SN4NTR/ArduinoSecuritySystem/Final/Changes.txt

C1, C2 - 10 мкФ
C7, C9 - 10 мкФ в другом корпусе
R1, R2 - 10 кОм
