SN4NTR/ArduinoSecuritySystem/Final/Presentation.pptx

## Презентация дипломного проекта

«Система обеспечения безопасности котельной жилого дома на базе микроконтроллера»

Выполнил: Миронь А.В.
Руководитель: Шемаров А.И.

## Газовый котел

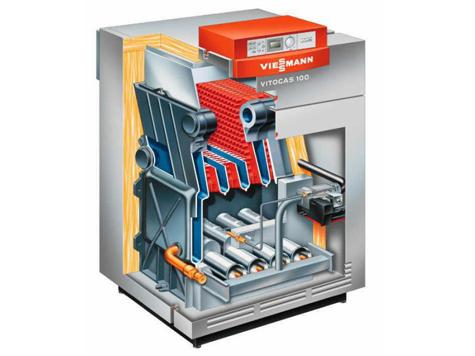
[picture p1: figure]
Принцип работы газового котла - понятно и подробно

- Низкая цена топлива;
- Высокий КПД;
- Занимает 40% доли рынка среди других котлов;
- Спрос на них будет постоянно увеличиваться.

## Функционал системы

- Определение превышения концентрации угарного (CO), углекислого (CO2) и природного газов;
- Обнаружение задымления;
- Обнаружение возгорания;
- Определение превышения температуры и влажности;
- SMS-оповещение по номеру телефона;
- Звуковая сигнализация;
- Световая индикация;
- Перекрытие подачи газа в газовый котел.

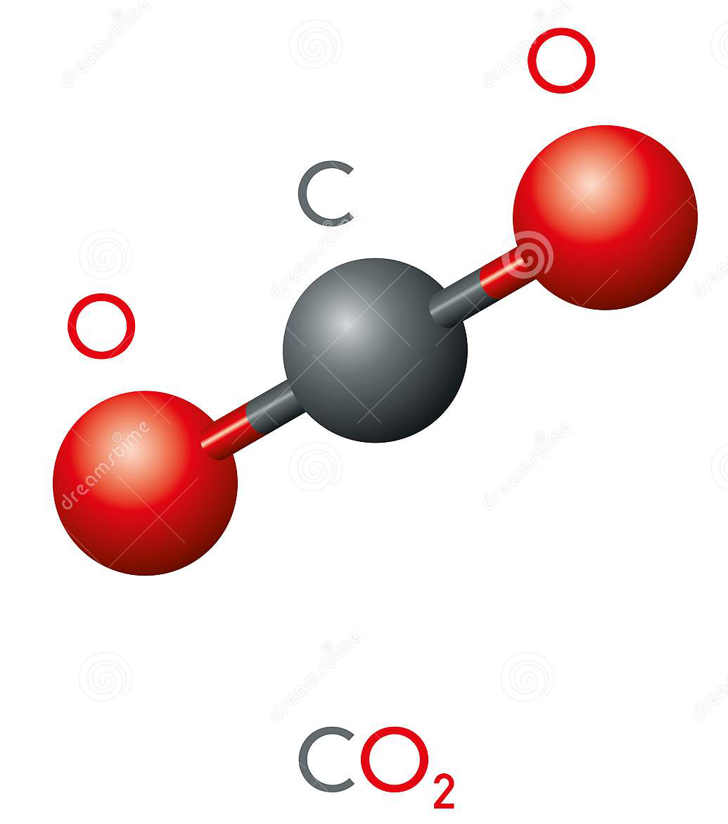
[picture p2: figure]
Углекислый газ, СО2, модель молекулы и химическая формула Иллюстрация вектора - иллюстрации насчитывающей изолировано, газ: 126784904
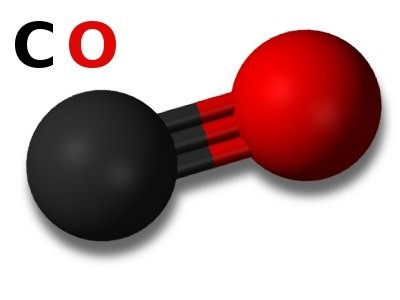
[picture p3: figure]
Влияние угарного газа на здоровье человека | АльфаЭко
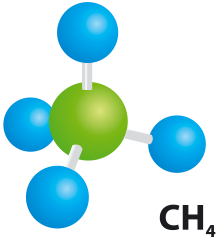
[picture p4: figure]
Природный газ – экологичное моторное топливо

## Аппаратное обеспечение

Микроконтроллер ATmega328P

- Тактовая частота 0 – 20 МГц;
- Напряжение питания 1,8 – 5,5 В;
- Общее количество портов 23;
- Объем Flash-памяти 32 кб;
- Объем RAM-памяти 2 кб;
- Объем EEPROM-памяти 1 кб;
- Количество аппаратных I2C/SPI 1;
- Диапазон рабочих температур -40 - 85℃.

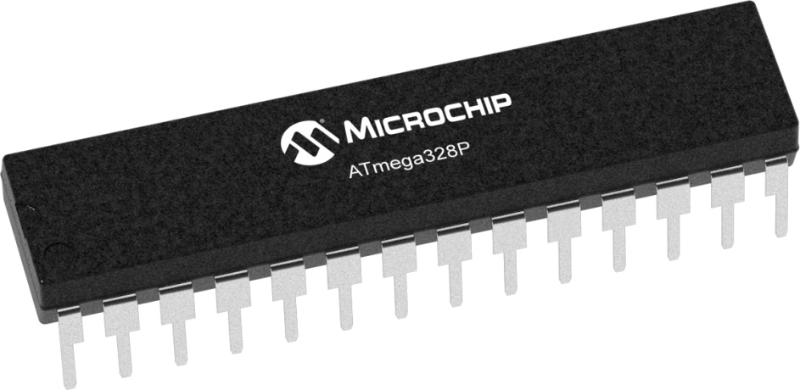
[picture p5: figure]
ATmega328P - 8-bit AVR Microcontrollers

## Аппаратное обеспечение

GSM/GPRS модуль SIM900A

- Два диапазона 900/1800 МГц;
- Напряжение питания 3,2 – 4,8 В;
- Встроенный стек TCP/IP, UDP/IP;
- Протоколы HTTP и FTP;
- Управление AT-командами;
- Диапазон рабочих температур -40 - 85℃.

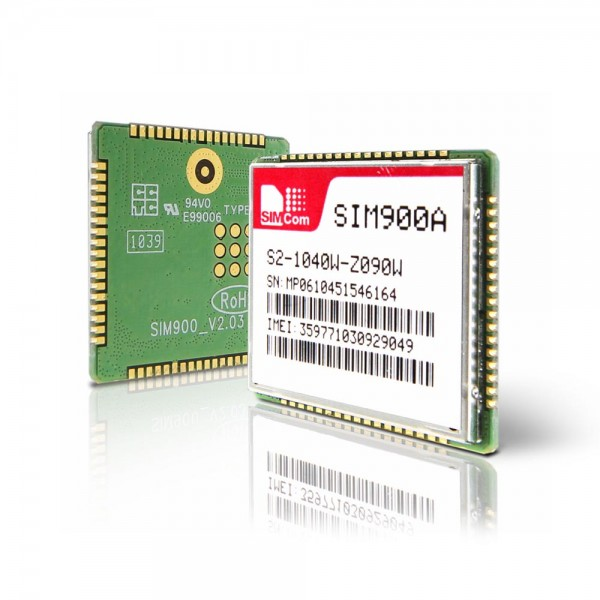
[picture p6: figure]
GSM GPRS модуль SIM900A (б/у)

## 3D-модель печатной платы

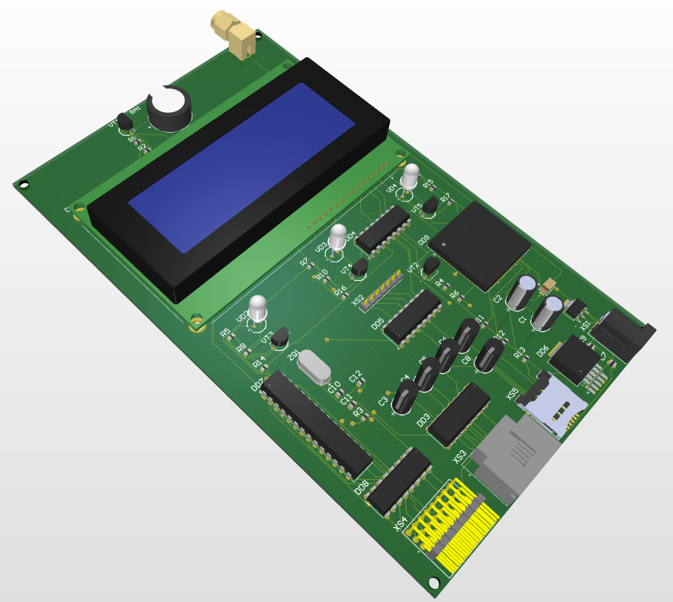
[picture p7: figure]

- 3-й класс точности;
- Паяльная паста Mechanic XG-50;
- Бессвинцовый припой ПОМ-3;
- Покрытие лаком PLASTIK 71.

Размеры платы: 110 х 180 х 1,5 мм

## 3D-модель корпуса устройства

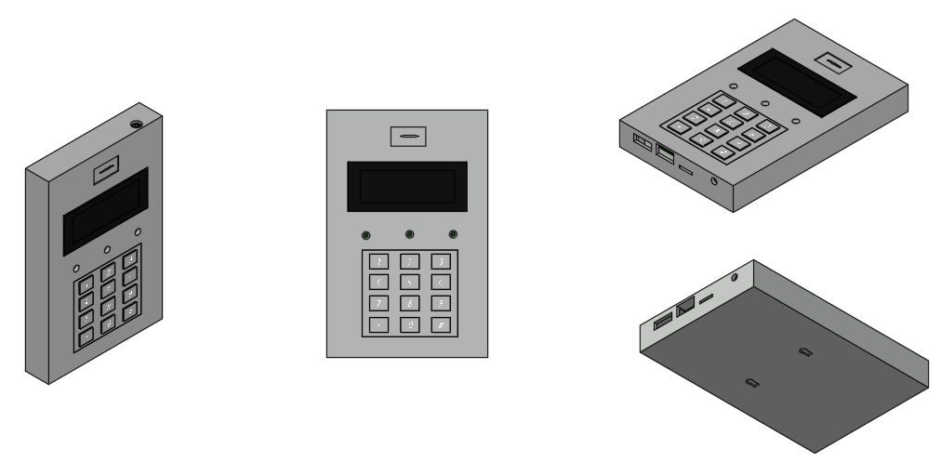
[picture p8: figure]

Размеры корпуса: 130 х 200 х 29 мм

ABS-пластик

## Slide 8

Программное обеспечение

## Моделирование работы системы

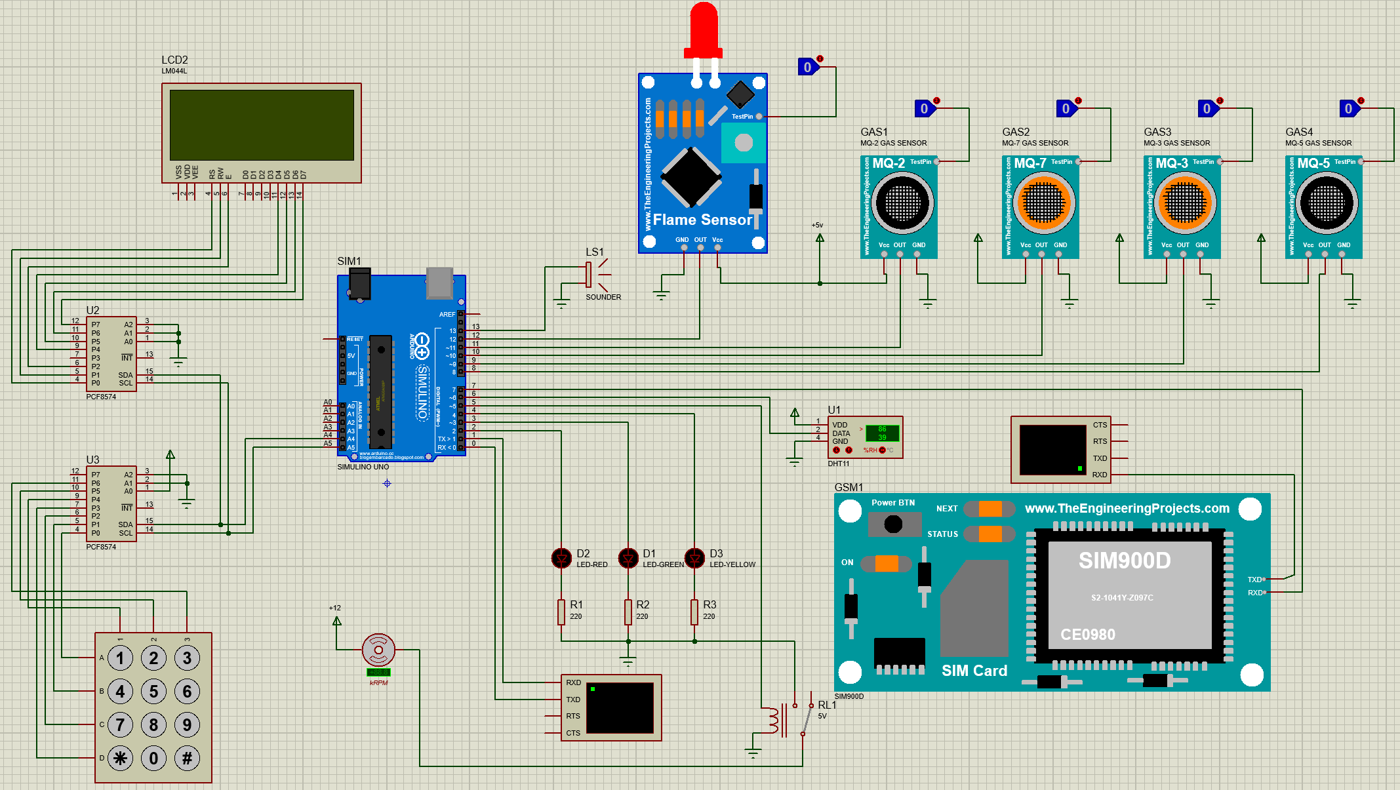
[picture p9: figure]

## Моделирование работы системы

Ввод номера телефона

Безопасная ситуация

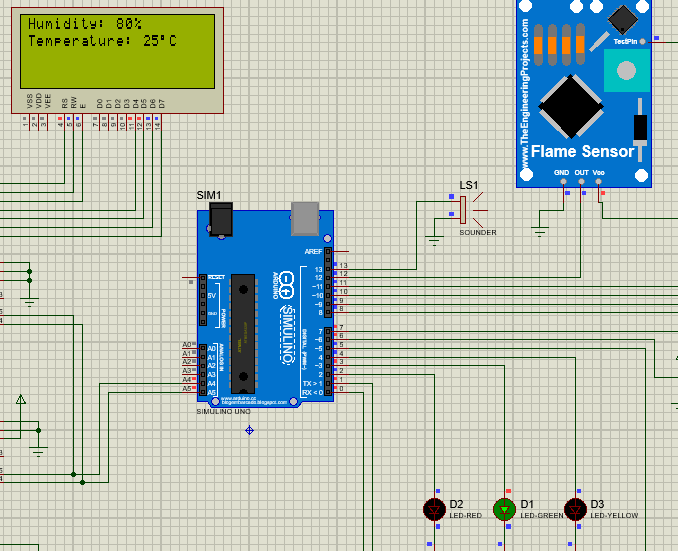
[picture p10: figure]
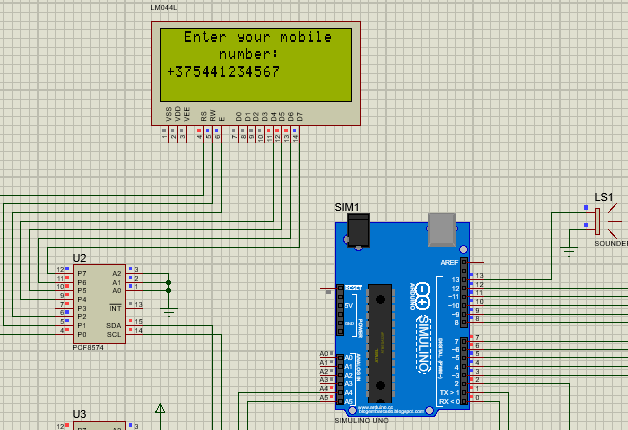
[picture p11: figure]

## Моделирование работы системы

Опасная ситуация

SMS-оповещение

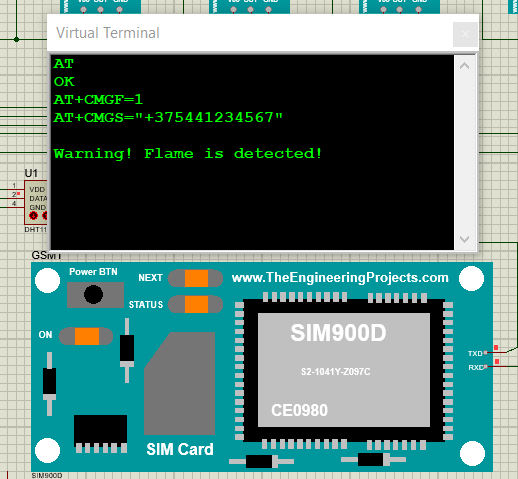
[picture p12: figure]
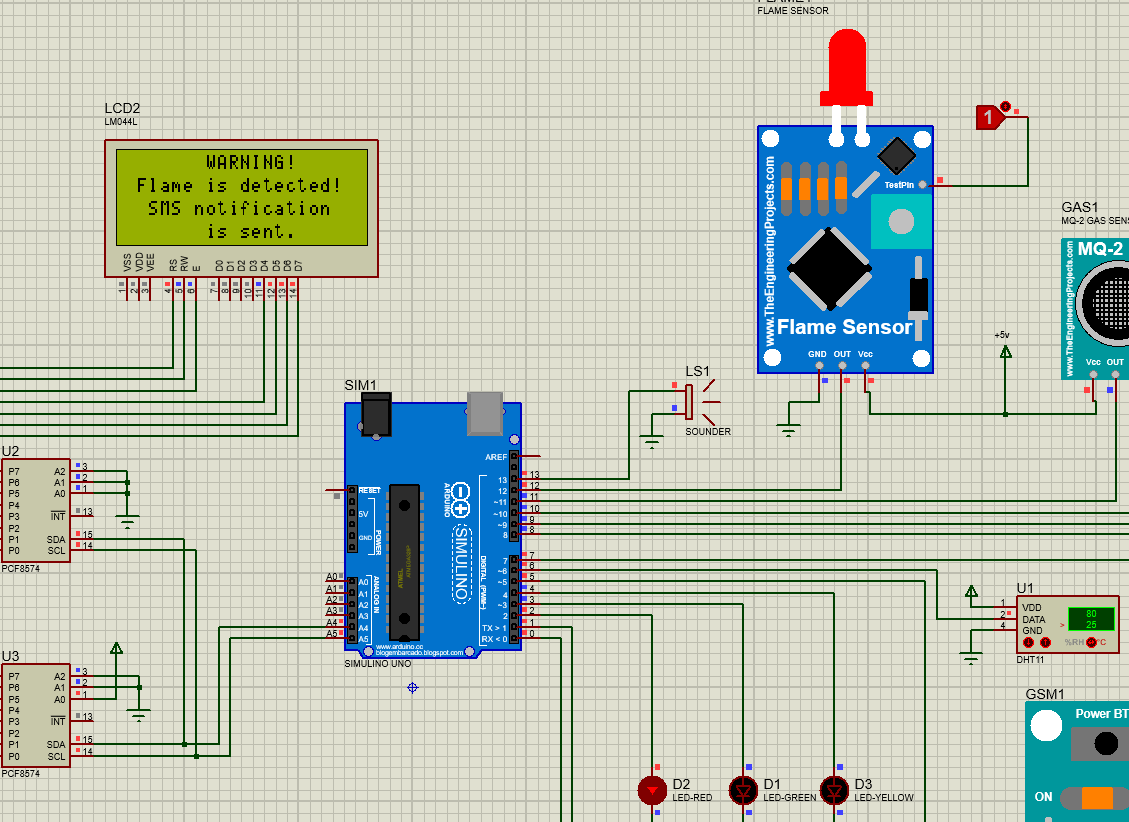
[picture p13: figure]

## Анализ экономической эффективности

Наименование статьи затрат | Значение, руб.
Покупные комплектующие | 261
Производственная себестоимость | 344
Полная себестоимость | 354
Отпускная цена | 443

## Спасибо за внимание!
