SN4NTR/ArduinoSecuritySystem/Final/For Review/Specs/Ведомость ДП Миронь.pdf

Перв. примен.

Зона
Обозначение | Наименование

Дополнительные
сведения

Текстовые документы

БГУИР ДП 1-40 02 02 01 011 ПЗ | Пояснительная записка | 91 с.
| Отзыв руководителя | 1 с.
| Рецензия | 1 с.

Справочный №

Графические документы

ГУИР.425158.001 ПЛ | Схема структурная | Формат А1
ГУИР.425158.001 Э3 | Схема электрическая принципиальная | Формат А1
ГУИР.425158.001 ПД | Схема алгоритма работы | Формат А1
ГУИР.758725.001 | Чертеж печатной платы | Формат А1

Подпись и дата

ГУИР.425158.001 СБ | Сборочный чертеж печатной платы | Формат А1
ГУИР.425159.001 СБ | Сборочный чертеж устройства | Формат А1

Инв. № дубл. Взам. Инв. № Подпись и дата

## БГУИР ДП 1-40 02 02 01 011 Д1

Изм. | Лист | № докум. | Подп. | Дата
Разраб. | Миронь | | | | Лит. | Лист | Листов
Инв. № подл.

Система обеспечения безопасности котельной жилого дома на базе микроконтроллера
Ведомость дипломного проекта
Пров. | Шемаров | Т | 92 | 92
Т.контр. | Шемаров
Н.контр. | Лихачёв
Утв. | Азаров

Кафедра ЭВС
гр. 750701
