SN4NTR/ArduinoSecuritySystem/Final/For Review/Specs/Спецификация на СБ печатной платы Миронь.pdf

Формат Зона Поз.
Обозначение | Наименование | кол.
Примеч.

Документация

A1 | ГУИР.425158.001 СБ | Сборочный чертеж печатной платы | 1
А1 | ГУИР.425158.001 Э3 | Схема электрическая | 1
| | принципиальная
А4 | ГУИР.425158.001 ПЭ3 | Перечень элементов | 1 | 2 с.

Детали

А1 | 1 | ГУИР.758725.001 | Плата печатная | 1

Прочие изделия

Диоды

2 | SMA4007 | 1 | VD1
3 | GNL-3012HD | 1 | VD2
4 | GNL-3012YD | 1 | VD3
5 | GNL-3012GD | 1 | VD4

Конденсаторы

6 | ECAP-10 мкФ, 100 В, ±20% | 2 | С1, C2
7 | ECAP-1 мкФ, 100 В, ±20% | 5 | С3..C6, C8
8 | TECAP-10 мкФ, 35 В, ±10% | 2 | C7, C9
9 | 0805-NPO-33 пФ, 50 В, ±5% | 2 | C10, C11
10 | 0805-X7R-1 мкФ, 16 В, ±10% | 1 | C12
| | ГУИР.425158.001
Изм | Лист | № докум | Подп. | Дата
Разраб. | Миронь | | | Система обеспечения безопасности котельной жилого дома на базе микроконтроллера | Лит | Лист | Листов
Пров. | Шемаров | | | | | Т | | 1 | 3
Т.контр. | Шемаров | | | | ЭВС, гр.750701
Н.контр. | Лихачёв
Утв. | Азаров

Микросхемы

11 | LCD-20X4B | 1 | DD1
12 | NCP1117ST50T3G | 1 | DD2
13 | MAX232 | 1 | DD3
14 | PCF8574 | 3 | DD4, DD5,
| | | DD8
15 | MIC29302WT | 1 | DD6
16 | ATmega328P | 1 | DD7
17 | SIM900A | 1 | DD9

Разъемы

18 | ADC-029 | 1 | XS1
19 | DS1023-1x7 | 1 | XS2
20 | RS-232 | 1 | XS3
21 | DS1013-24S | 1 | XS4
22 | SIM5051-6-0-18-00-A | 1 | XS5
23 | 901-9894-RFX | 1 | XS6

Резисторы

24 | Чип 0805-10 кОм ± 1% | 2 | R1, R2
25 | Чип 0805-1 МОм ± 1% | 1 | R3
26 | Чип 0805-4,7 кОм ± 1% | 4 | R4, R5, R7,
| | | R9
27 | Чип 0805-47 кОм ± 1% | 4 | R6, R8, R10,
| | | R15
28 | Чип 0805-22 Ом ± 1% | 3 | R11..R13
29 | Чип 0805-510 Ом ± 1% | 3 | R14, R16, R17
| ГУИР.425158.001 | Лист
2
Изм | Лист | № докум | Подп.

Резонаторы

30 | Резонатор кварцевый HC-49S | 1 | ZQ1

Устройства индикационные

31 | Динамик пьезоэлектрический CVS-1508 | 1 | BA1

Транзисторы

32 | КТ3102АМ | 5 | VT1..VT5

Материалы

33 | Краска МКЭ белая ОСТ92-1586-89 | 0,02
34 | Припой ПОМ-3 ГОСТ 21931-76 | 0,04
35 | Паяльная паста Mechanic XG-50 | 0,03
36 | Лак PLASTIK 71 | 0,03

# ГУИР.425158.001

Лист
3
Изм | Лист | № докум | Подп.
