SN4NTR/ArduinoSecuritySystem/Final/For Review/Specs/Спецификация на СБ устройства Миронь.pdf

Формат Зона Поз.
Обозначение | Наименование | кол.
Примеч.

Документация

A1 | ГУИР.425159.001 СБ | Сборочный чертеж устройства | 1

Стандартные изделия

1 | ГУИР.758725.001 | Плата | 1
2 | | Клавиатура Accord AK-304-N-BBW | 1
3 | | Винт М2.5х8 ГОСТ 17473-80 | 4
4 | | Винт М2.5х5 ГОСТ 17473-80 | 8
5 | | Винт М3х8 ГОСТ 17473-80 | 4

# ГУИР.425159.001

Изм | Лист | № докум | Подп. | Дата
Разраб. | Миронь | | | Система обеспечения безопасности котельной жилого дома на базе микроконтроллера | Лит | Лист | Листов
Пров. | Шемаров | | | | | Т | | 1
Т.контр. | Шемаров | | | | ЭВС, гр.750701
Н.контр. | Лихачёв
Утв. | Азаров
