SN4NTR/ArduinoSecuritySystem/Docs/Приказ по темам.pdf

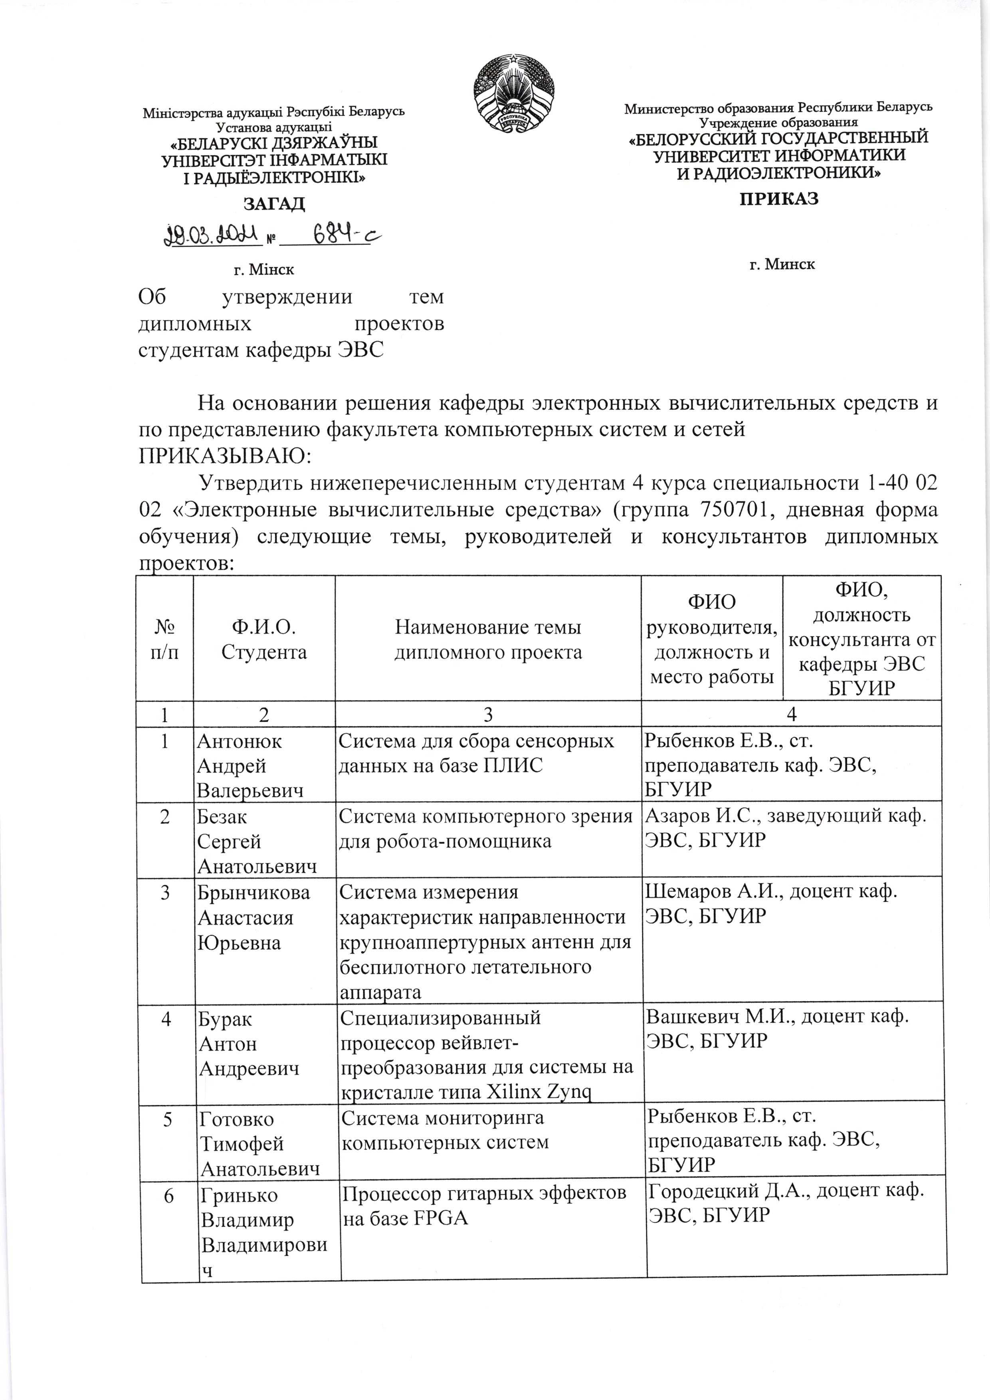
[picture p36: page 1]
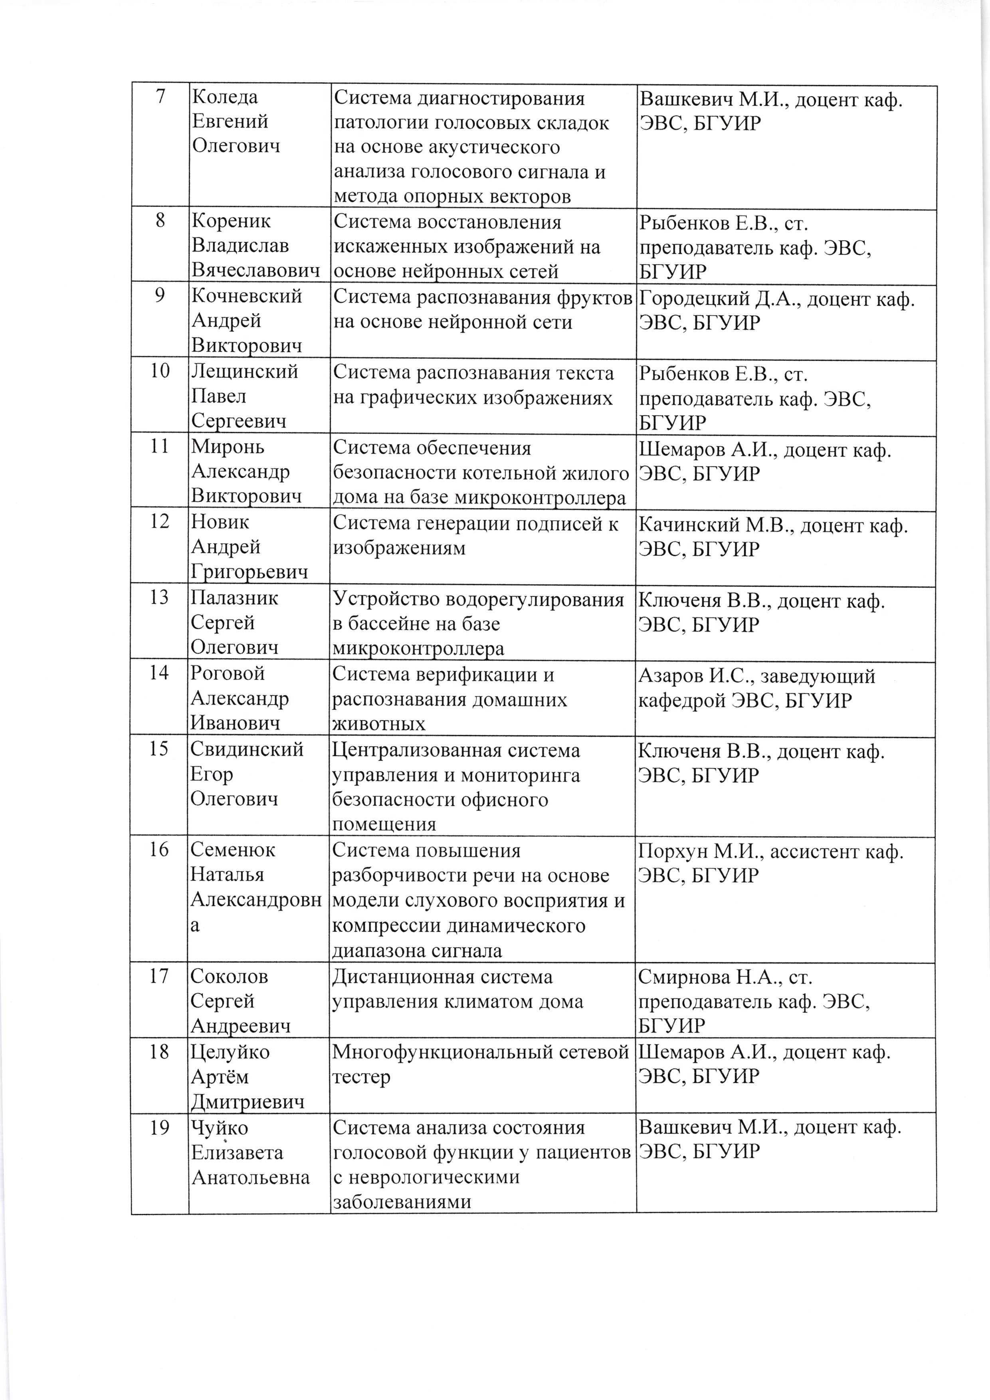
[picture p37: page 2]
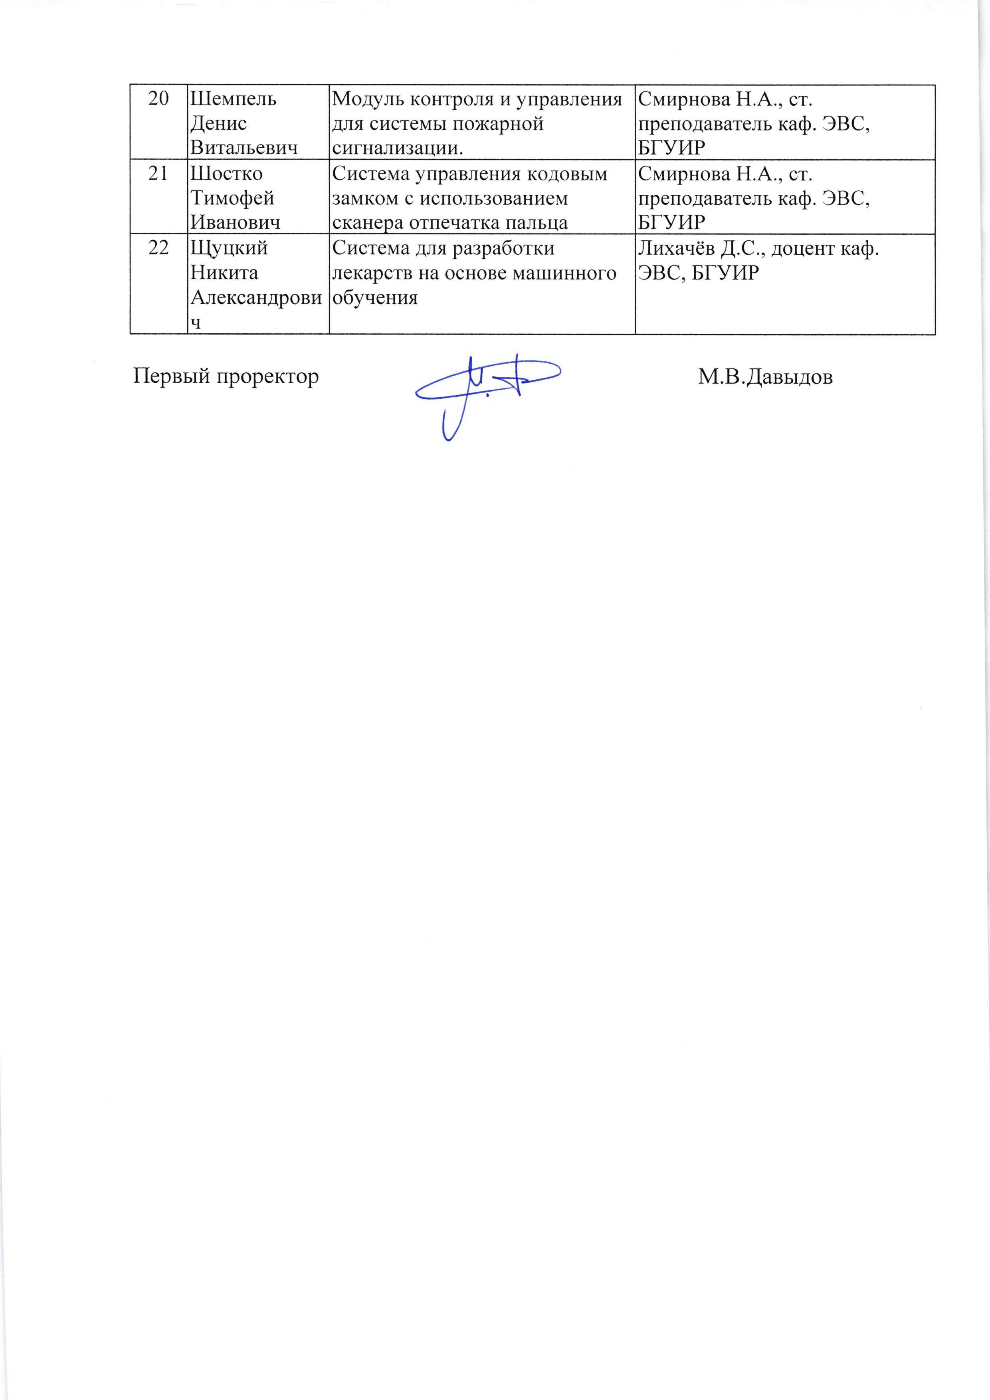
[picture p38: page 3]
