SN4NTR/ArduinoSecuritySystem/Final/For Review/Пояснительная записка Миронь.pdf

Министерство образования Республики Беларусь

Учреждение образования
БЕЛОРУССКИЙ ГОСУДАРСТВЕННЫЙ УНИВЕРСИТЕТ ИНФОРМАТИКИ И РАДИОЭЛЕКТРОНИКИ

Факультет компьютерных систем и сетей Кафедра электронных вычислительных средств

К защите допустить:
Заведующий кафедрой ЭВС
___________ И. С. Азаров

ПОЯСНИТЕЛЬНАЯ ЗАПИСКА
к дипломному проекту
на тему

СИСТЕМА ОБЕСПЕЧЕНИЯ БЕЗОПАСНОСТИ КОТЕЛЬНОЙ ЖИЛОГО ДОМА НА БАЗЕ МИКРОКОНТРОЛЛЕРА

БГУИР ДП 1-40 02 02 01 011 ПЗ

Студент | А. В. Миронь
Руководитель | А. И. Шемаров

Консультанты:
от кафедры ЭВС | А. И. Шемаров
по экономической части | Т. А. Рыковская
Нормоконтролер | Д. С. Лихачев

Рецензент

Минск 2021

РЕФЕРАТ

СИСТЕМА | ОБЕСПЕЧЕНИЯ | БЕЗОПАСНОСТИ | КОТЕЛЬНОЙ
ЖИЛОГО ДОМА НА БАЗЕ МИКРОКОНТРОЛЛЕРА : дипломный проект / А. В. Миронь. – Минск : БГУИР, 2021, – п.з. – 91 с., чертежей (плакатов) – 6 л. формата А1.

В рамках дипломного проекта разработана система обеспечения безопасности котельной жилого дома на базе микроконтроллера. Было разработано программное обеспечение для тестирования работы системы. Данная система обладает широким функционалом для отслеживания и анализа состояния воздуха в котельном помещении с возможностью определения превышения концентрации ядовитых газов и функцией SMS-оповещения о чрезвычайной ситуации по указанному при регистрации пользователем номеру, а также функцией перекрытия подачи газа в газовый котел.
Элементная база была выбрана исходя из функционального назначения и условий эксплуатаций разрабатываемой системы.
Область технического применения представляет собой жилые и нежилые помещения частного дома, дачи либо коттеджа, т. к. устройство сконструировано для эффективного применения в данных условиях.

Ил. – 24, табл. – 13, прилож. – 2, список лит. – 22 назв.;
Графическая часть – 6 л. формата А1.

Ключевые слова: система обеспечения безопасности котельной,
элементная база, | конструирование, | печатная плата, | газовый котел.

5

СОДЕРЖАНИЕ

5 Выбор | средств | обеспечения | теплового | режима, | герметизации,

6.8 Обеспечение требований эргономики и инженерной психологии ... 48

8 Рекомендации | по | обеспечению | электрической | и | экологической

9 Требования к хранению, маркировке, упаковке и транспортировке

6

7

ВВЕДЕНИЕ

Отопление частного дома, коттеджа, дачи или любого другого жилого помещения является важным фактором для комфортного пребывания в них. В настоящее время существует большое количество различных способов для обогрева помещений, для поддержания комфортной температуры внутри. Одним из таких примеров является газовый котел.
Данный вид котлов получил широкое распространение за счет ряда преимуществ:
– позволяет отапливать объекты и помещения больших размеров;
– коэффициент полезного действия достаточно высокий, а цена топлива – небольшая;
– количество энергии, которое отдает котел, намного больше, чем потребляемое;
– отсутствует необходимость следить за пламенем, потому что газ подается в установку непрерывно;
– прост в эксплуатации и рассчитан на долгий срок службы.
В то же время, газовый котел является источником повышенной опасности. Современные котлы оснащены различными датчиками, которые могут определить, работает ли горелка, не упало ли давление ниже допустимого значения, достаточна ли тяга и т. д. Но несмотря на это, важную роль играет то, какую систему безопасности имеет помещение, в котором газовый котел размещен. При несоблюдении правил эксплуатации газовый котел может стать источником утечки газа или возгорания. Для того, чтобы максимально быстро реагировать на такие ситуации, необходимо грамотно подойти к выбору системы безопасности котельного помещения.

8

### 1 ЛИТЕРАТУРНЫЙ ОБЗОР

Для того, чтобы обеспечить в жилом помещении необходимые условия
для | комфортного проживания, | нужна система, | которая могла | бы
поддерживать нужный температурный режим внутри. Система отопления является наиболее удачным инженерным решением данного вопроса. Эволюция отопительного оборудования проделала долгий путь: от простых каминов до смарт-котлов, интегрированных в отопительную систему и рационально расходующих энергию в зависимости от нужд потребителя. Существуют различные виды систем отопления, но самыми основными являются: водяная, электрическая, паровая, воздушная [1].
Среди | всей | классификации | систем | отопления | наибольшей
популярностью пользуется водяное отопление. Технические преимущества такого отопления были выявлены в результате многих лет практики:
– небольшая температура поверхности различных приборов и труб;
– обеспечивает одинаковую температуру во всех помещениях;
– экономит топливо;
– повышенные эксплуатационные сроки;
– бесшумная работа;
– простота в обслуживании и ремонте.
Главным компонентом системы водяного отопления является котел. Такое устройство необходимо для того, чтобы нагревать воду. Вода является в таком виде отопления теплоносителем. Она циркулирует по трубам замкнутого типа, а потом тепло передается в различные отопительные компоненты, а от них уже обогревается все помещение.

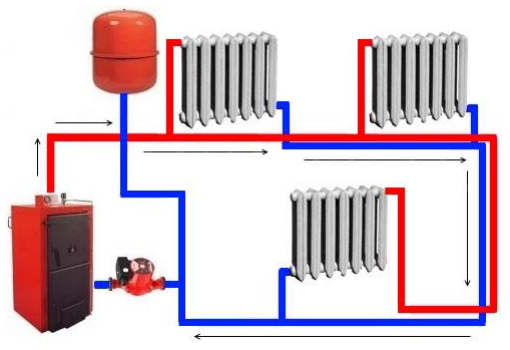
[picture p39: figure]

Рисунок 1.1 – Схема водяной системы отопления

9

Электрическая система отопления становится популярной за счет того, что не требует больших затрат для установки или ремонта. Электрический конвектор можно поставить в нужное место и подключить его к питанию сети. Уровень комфорта и экономичность такой обогревательной системы достигается благодаря тому, что в электрических конвекторах применяется электронная система, которая помогает поддерживать определенную температуру.

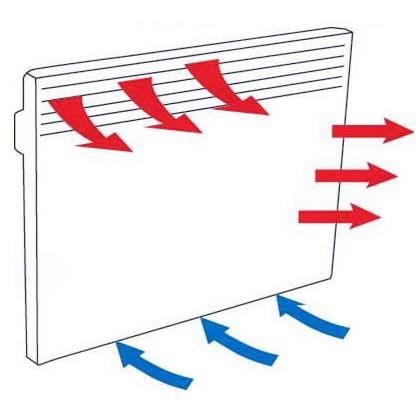
[picture p40: figure]

Рисунок 1.2 – Схема электрической системы отопления

Воздушное отопление считается одним из самых старых видов отопления. Такая отопительная система получила широкое распространение в общественных и производственных помещениях. Нагретый воздух попадает в помещение, где происходит процесс смешивания с внутренним воздухом и охлаждается до температуры помещения и снова нагревается.


Рисунок 1.3 – Схема воздушного отопления

10

Одним из видов воздушного отопления является отопление при помощи газовых котлов. Низкая цена топлива обеспечила ему популярность. Но установка такого котла требует соблюдения ряда условий из-за взрывоопасности газа. Современные газовые котлы имеют различные датчики, отвечающие за безопасность оборудования:
– тяги;
– температуры (уличный и комнатный);
– пламени;
– датчик давления;
– перегрева.

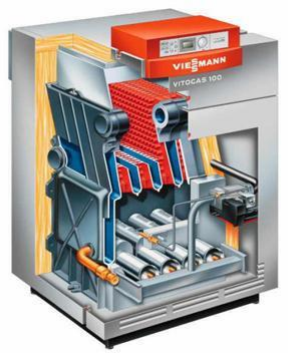
[picture p41: figure]

Рисунок 1.4 – Газовый котел

Но несмотря на безопасность современного котельного оборудования, важную роль играет система безопасности помещения, в которой котел размещен. Данная система безопасности должна уметь распознавать наличие опасных газов в помещении (таких как угарный (CO) и углекислый (CO2) газ), задымленность, возгорание, а также отслеживать температуру и влажность помещения и реагировать соответствующим образом на данные показатели [2].

11

### 2 АНАЛИЗ ТЕХНИЧЕСКОГО ЗАДАНИЯ

### 2.1 Описание схемы электрической принципиальной

Работа системы обеспечения безопасности котельной жилого дома основывается на принципе считывания показаний датчиков и, исходя из данных показаний, принятия решений на основе программы управления, которая зашита в микроконтроллере ATmega328P (DD7). Для обеспечения работы микроконтроллера на частоте 16 МГц необходимо подключить
внешний | кварцевый | резонатор | ко | входам | XTAL1 | и | XTAL2
микроконтроллера, второй конец параллельных резонатору цепей заземлить, но перед подключением земли расположить по емкости малого номинала, т. к. встроенный кварцевый резонатор способен выдать частоту до 8 МГц [3]. Для данной цели выбран многослойный керамический конденсатор номиналом 33 пФ с максимальным отклонением от номинала в 5% и напряжением 50 В.
Главной | микросхемой, | отвечающей | за | управление | системой
обеспечения | безопасности | котельной | жилого | дома, | является
микроконтроллер ATmega328P (DD7). Для подключения к управляющей схеме различных элементов управления, датчиков, а также индикаторов системы будут использованы расширители портов ввода/вывода. Элементы управления необходимы для первоначальной настройки устройства. При первом включении пользователю будет предложено ввести при помощи клавиатуры номер телефона для возможности SMS-оповещений. Датчики
выполняют | роль | считывателей | состояния | котельного | помещения.
Индикаторы необходимы для визуального и звукового оповещения пользователя об опасной ситуации. Для реализации возможности SMS-оповещения пользователя к микроконтроллеру ATmega328P подключается микросхема SIM900A (DD9). Разъем типа RS-232 (XS3) необходим для прошивки и отладки системы.
Для отображения состояния котельного помещения к системе подключается LCD-дисплей LCD-20X4B размером 20 символов на 4 строки. К управляющей микросхеме DD7 дисплей подключается через расширитель портов ввода/вывода PCF8574 (DD4). Для установки адреса устройства необходимо заземлить выводы A0-A2. Получится адрес «000».
Для обеспечения возможности ввода номера телефона при настройке устройства пользователем используется клавиатура Accord AK-304-N-BBW. Данная клавиатура имеет кнопки от 0 до 9 и знаками «*» и «#». Клавиатура

12

подключается через 7-контактный разъем (XS2). На выводы расширителя портов P0-P6 подаются сигналы с клавиатуры через разъем XS2, который пронумерован для правильного подключения клавиатуры. Разъем XS2 подключается к микроконтроллеру при помощи расширителя портов ввода/вывода PCF8574 (DD5). Необходимо заземлить адресные выводы A1-A2 и подать питание на вывод A0, чтобы получить адрес «001».
Система обеспечения безопасности котельной жилого дома имеет разъемы для подключения до 8 проводных датчиков (XS4): различных газов, температуры и влажности, а также реле для отключения подачи газа. Данный разъем подключается к микроконтроллеру при помощи расширителя портов ввода/вывода по шине I

2C – PCF8574 (DD8). Выводы разъема OUT1-OUT8 подключаются к выводам P0-P7 расширителя DD8. Так как DD8 подключен к I

2C шине, необходимо задать уникальный адрес данного устройства. Для этого A0 и A2 заземляются (их логические уровни равны нулю), а на вывод A1 подается питание +5В (логический уровень равен единице). В данном случае уникальный адрес будет «010». Для питания DD8 используется питающее напряжение цепи +5В.
К микросхеме DD7 подключается пьезодинамик (ВA1) HPA17F при помощи усилителя для звукового оповещения пользователя о чрезвычайной ситуации.
Взаимодействие с системой происходит через коммуникационный последовательный интерфейс RS-232 (XS3), который имеет большое число
преобразователей | в | USB, | Ethernet, | силовые | разъемы | и | другие.
Коммуникационный разъем ХS3 содержит выводы интерфейса SPI, который может быть использован для ISP-программирования. Последовательный
коммуникационный | интерфейс | подключен | через | микросхему
преобразователя | уровней | MAX232 | (DD3). | К | DD3 | подключаются
поляризованные конденсаторы емкостью 1 мкФ к выводам C1+, C1-, C2+, C2-, V-. Для питания DD3 используется напряжение +5В.
Для обеспечения возможности SMS-оповещения пользователя о чрезвычайных ситуациях используется микросхема SIM900A (DD9). Эта микросхема является двухдиапазонным модулем GSM/GPRS работающим на частотах EGSM 900 МГц и DCS 1800 МГц. Для того, чтобы аутентифицировать систему в сети, к выводам SIM_VDD, SIM_DATA, SIM_CLK микросхемы DD9 необходимо подключить SIM-карту через разъем SIM5051 (XS5) с использованием резисторов на 22 Ом. Вывод PWRKEY GSM-модуля подключается к выводу PD5 микроконтроллера ATmega328P для подачи микроконтроллером сигнала включения. Передача сигналов

13

GSM-модулем осуществляется через антенну, которая подключается к разъему 901-9894-RFX (XS6). Цепь, идущая от коллектора транзистора VT1 к выводу PD5 микроконтроллера добавлена для дополнительной страховки и нужна для того, чтобы следить, включен ли модуль SMS-оповещения. Если микроконтроллер DD7 обнаружит, что на этой линии высокий уровень напряжения, выполнится функция повторного запуска GSM-модуля. Вывод NETLIGHT GSM-модуля используется для отображения состояния сети. Рабочие состояния вывода представлены в таблице 2.1.

Таблица 2.1 - Рабочие состояния вывода NETLIGHT [4]

Состояние | Функция SIM900A
Выключен | Микросхема не в рабочем состоянии
64 мс включено / 800 мс выключено | Микросхема не нашла сеть
64 мс включено / 3000 мс выключено | Микросхема нашла сеть
64 мс включено / 300 мс выключено | Связь по GPRS

### 2.2 Описание схемы питания

Разъем ADC-029 (XS1) является входным портом. На него подается внешнее питание от блока питания 12 В. При помощи стабилизатора напряжения NCP1117ST50T3G (DD2) напряжение 12 В преобразуется в 5 В. А при помощи MIC29302WT (DD6) – в 3,3 В. Напряжение питания 3,3 В используется для питания GSM-модуля, 5 В используется для питания
микроконтроллера | ATmega328P, | преобразователя | уровня | MAX232,
расширителей портов PCF8574 и для подачи питания на разъемы для подключения внешних устройств. Для обеспечения работы динамика BA1 используется напряжение 12 В.
Структурная схема системы обеспечения безопасности котельной жилого дома представлена на плакате ГУИР.425158.001 ПЛ. Схема электрическая принципиальная представлена на чертеже ГУИР.425158.001 Э3.

### 2.3 Анализ условий эксплуатации

Система | обеспечения | безопасности | котельной | жилого | дома
эксплуатируется в диапазоне температур от -20 до +60°С и относительной

14

влажности не более 90%, а основным назначением системы является эксплуатация в районе с умеренным климатом.
Cистема будет находиться в умеренном климате в помещении, и температура помещения не будет ниже -20°С, при отсутствии отопления. Исходя из этих условий, была выбрана следующая категория размещения:
для | эксплуатации | в | помещениях | с | искусственно | регулируемыми
климатическими условиями, например, в закрытых отапливаемых или охлаждаемых и вентилируемых производственных и других, в том числе хорошо вентилируемых подземных помещениях (отсутствие воздействия прямого солнечного излучения, атмосферных осадков, ветра, песка и пыли наружного воздуха; отсутствие или существенное уменьшение воздействия рассеянного солнечного излучения и конденсации влаги) «помещение категории 4» [5].
Сочетание исполнения, категории и группы для системы обеспечения безопасности котельной жилого дома будет использоваться следующее: вид климатического исполнения УХЛ 4.2 по ГОСТ 15150-69.

Таблица 2.2 – Характеристики вида климатического исполнения УХЛ 4.2 [5]

Значение температуры воздуха при эксплуатации, °С | Относительная влажность, %
Рабочее | Предельное рабочее | Среднегодовое значение | Верхнее значение
верхнее | нижнее | верхнее | нижнее | при 20°С | при 25 °С
+35 | +10 | +40 | 0 | 60 | 80

15

### 3 ВЫБОР ЭЛЕМЕНТНОЙ БАЗЫ И МАТЕРИАЛОВ

КОНСТРУКЦИИ

Выбор элементной базы очень важен для обеспечения стабильности, надежности и экономичности устройства, потому что выбор элементов, применяющихся в современных электронных средствах, обеспечивает ремонтоспособность элементов. Не менее важной задачей является достижение простоты сборки, а также электрического монтажа, испытаний и регулировки.
Характеристики изделий электронной техники приведены в таблице 3.1.

Таблица 3.1 – Элементы, входящие в систему, и их характеристики

Позиционное обозначение | Тип | Примечание | Корпус
1 | 2 | 3 | 4
ВA1 | CVS-1508 | Uпит не более 5 В; Диапазон температуры (-0С 20…+55)
C1, C2 | JRB | Конденсатор электролитический поляризованный сквозного монтажа; C = 10 мкФ; Uраб = 100 В; Диапазон температур (-40…+105)⁰С
C3-C6, C8 | JRB | Конденсатор электролитический поляризованный сквозного монтажа; C = 1 мкФ; Uраб = 100 В; Диапазон температур (-40…+105)⁰С
С7, С9 | GRM | Конденсатор танталовый поверхностного монтажа; C = 10 мкФ; Uраб = 35 В; Диапазон температур (-55…+125)⁰С

16

Продолжение таблицы 3.1

1 | 2 | 3 | 4
С10, С11 | GRM | Конденсатор многослойный керамический поверхностного монтажа; C = 33 пФ; Uраб = 50 В; Диапазон температур (-55…+125)⁰С | SMD 0805
C12 | GRM | Конденсатор многослойный керамический поверхностного монтажа; C = 1 мкФ; Uраб = 16 В; Диапазон температур (-55…+125)⁰С | SMD 0805
DD1 | LCD-20X4B | Uпит не более 5 В; Диапазон температур (-30…+80) 0С
DD2 | NCP1117 ST50T3G | Uпит не более 20 В; Диапазон температур (-40…+125)⁰С | SOT-223
DD3 | MAX232 | Uпит не более 5,5 В; Диапазон температур (-40…+85)⁰С | DIP-16
DD4, DD5, DD8 | PCF8574 | Uпит не более 7 В; Диапазон температур (-40…+85)⁰С | PDIP-16
DD6 | MIC29302WT | Uпит не более 26 В; Диапазон температур (-40…+125)⁰С | TO-263-5
DD7 | ATmega328P | Uпит не более 5,5 В; Диапазон температур (-40…+85)⁰С | DIP-28
DD9 | SIM900A | Uпит не более 4,5 В; Диапазон температур (-40…+85)⁰С | SMD-8pin
R1-R17 | RC | Бескорпусные толстопленочные резисторы; R = 22 Ом, 510 Ом, 4,7 кОм, 10 кОм, 47 кОм, 1 МОм; Pном. = 0,125 Вт; Uраб = 200 В; Диапазон температур (-55…+125)⁰С | SMD 0805

17

Продолжение таблицы 3.1

1 | 2 | 3 | 4
VD1 | M7 | Диод универсальный | SMA
VD2 | GNL-3012HD | Светодиод красный
VD3 | GNL-3012YD | Светодиод желтый
VD4 | GNL-3012GD | Светодиод зеленый
VT1-VT5 | КТ3102АМ | Транзистор npn типа Макс. напр. к-б при заданном обратном токе к и разомкнутой цепи э.(Uкбо макс) = 50 В Макс. напр. к-э при заданном токе к и разомкнутой цепи б.(Uкэо макс) = = 45 В Iк макс = 0.1 A P = 0.5 В Диапазон температур (-55…+150)⁰С | TO-92
XS1 | ADC-029 | Разъем питания для системы Диапазон температуры (-25…+85)⁰С | DIP
XS2 | DS1023-1x7 | Разъем для подключения клавиатуры, 7 контактов Диапазон температуры (-40…+105)⁰С | DIP
XS3 | RS-232 | Разъем RS-232 Диапазон температуры (-40…+105)⁰С | BH-10
XS4 | DS1013-24S | Разъем для подключения датчиков, 24 контакта Диапазон температуры (-55…+140)⁰С | DIP
XS5 | SIM5051-6-0-18-00-A | Разъем для SIM-карты Диапазон температуры (-40…+85)⁰С | SMD

18

Продолжение таблицы 3.1

1 | 2 | 3 | 4
XS6 | 901-9894-RFX | Разъем для подключения антенны к GSM-модулю Диапазон температуры (-40…+90)⁰С | SMD
ZQ1 | РПК01 | Кварцевый резонатор Диапазон температуры (-20…+70)⁰С | HC-49S

Есть несколько принципов выбора элементной базы:
– объема производства;
– исходя из их назначения в схеме;
– с учетом требований, предъявляемых к компоновке платы как в целом, так и отдельных ее элементов;
– | экономической | целесообразности | применяемого | способа
изготовления изделия.
Стеклостелиты имеют структуру слоеного пластика, волокна которого чередуются с полимерным связующим веществом. Обычно это бакелита, эпоксидная смола или полиэфирная смола. Стеклоткань является основой
стеклотекстолита. | Кроме | хороших | электрических | и | механических
электрических свойств, она обладает высокими гидрофобными свойствами, химической инертностью, а ее рабочая температура от -65°С до +155°С, что придает высокую стойкость к перегревам.
Основным недостатком | является предельный | запас прочности
стеклотекстолила, поэтому это требует соблюдения определенных условий хранения. Возможно выделение токсичной пыли от смол и при нагреве до высоких температур токсичных паров, которые способны раздражать человеческую слизистую. Еще одним недостатком является достаточно высокая стоимость.
На плате используются неметаллические покрытия с целью защиты:
– | элементов | проводящего | рисунка | от | замыкания | навесными
радиоэлементами;
– печатных проводников и поверхности основания печатной платы от воздействия припоя.
Диэлектрические защитные покрытия на основе эпоксидных смол, холодных эмалей, сухого пленочного резиста, оксидных пленок используют

19

от воздействия припоя для защиты печатных проводников и поверхности основания печатной платы. Варианты конструктивных покрытий печатных плат представлены в таблице 3.2.

Таблица 3.2 – Конструктивные покрытия печатных плат [6]

Вид покрытия | Толщина, мкм | Назначение покрытия
Серебряное | 6 – 12 | Улучшение электрической проводимости
Сплав серебро-сурьма | 6 – 12 | Улучшение электрической проводимости и повышение износоустойчивости переключателей и концевых контактов
Золотое и его сплавы | 0,5 – 3,0 | Улучшение электрической проводимости, снижение переходного сопротивления и повышение износоустойчивости
Палладиевое | 1 – 5 | Снижение переходного сопротивления и повышение износоустойчивости контактов переключателей и концевых контактов
Никелевое | 3 – 6 | Защита от коррозии, повышение износоустойчивости контактов переключателей и концевых контактов
Медное | 25 – 30 | Обеспечение электрических параметров, соединение проводящих слоев

В качестве конструктивного покрытия печатной платы выбран сплав серебро-сурьма. Покрытие печатных проводников, контактных площадок и металлизированных отверстий сплавом Sn97Cu3.
Достаточно важным фактором надежности электронных средств является выбор припоя для электрического монтажа. Для пайки выводных электрорадиоэлементов выбран припой ПОМ-3. Для пайки SMD элементов выбрана паяльная паста Mechanic XG-50.
Позиционные | обозначения | элементов | необходимо | маркировать
краской маркировочной МКЭЧ по ГОСТ 14763-89.
После установки элементов будет произведено покрытие лаком Plastik 71.
Перед | пайкой | электрорадиоэлементов | необходимо | подготовить
посадочные места. Для этого необходимо их очистить от окислов при помощи флюса.

20

Флюс – вещество органического и неорганического происхождения, предназначенные для удаления оксидов с паяемых поверхностей, снижения поверхностного натяжения, улучшения растекания жидкого припоя и/или защиты от действия окружающей среды.
Принцип действия паяльных флюсов заключается в том, что при нагреве металла, который нужен для облегчения соединения деталей и печатной платы, появляется оксидная пленка, которая снижает способность припоя соединяться с металлическими деталями. Именно для решения этой проблемы используется флюс для пайки. Флюсы могут добавляться в припой или наносятся непосредственно на металлические поверхности для предотвращения нежелательного окисления.
Таким образом выполняется сразу три задачи:
– улучшение смачивания поверхностей, подлежащих пайке;
– роль кислородного барьера для предотвращения дальнейшего окисления;
– растворение оксидной пленки, образовавшейся на поверхности обрабатываемого металла.
Главное требование к флюсам – это способность выдерживать высокие температуры, сохраняя при этом все полезные эксплуатационные свойства. Поэтому для химической очистки соединяемых поверхностей был выбран флюс Kester 959T.

21

### 4 ВЫБОР КОМПОНОВОЧНОЙ СХЕМЫ И МЕТОДА

КОНСТРУИРОВАНИЯ

Компоновочная схема изделия определяется габаритами и количеством элементной базы, способом защиты от электростатических и магнитных
полей, | объемом | монтажных | соединений, | ремонтопригодностью | и
механическими воздействиями.
Можно выделить 2 типа компоновочной схемы: централизованная и децентрализованная [7].
Централизованная схема компоновки имеет следующие особенности: – длина и количество межблочных соединений сведены к минимуму; – все элементы сложной системы располагаются в одном отсеке на специальных этажерочных конструкциях;
– ремонт и демонтаж наиболее удобны, легче выполнить качественные системы охлаждения и амортизации.
Централизованная схема компоновки имеет следующие особенности: – не требуется тщательная экранировка отдельных блоков;
– | обеспечивается | относительно | большая | легкость | размещения
элементов изделия на объекте;
– при соответствующих схемных решениях может быть более надежной, сохраняя частичную работоспособность при выходе из строя отдельных элементов изделия.
При децентрализованной компоновке можно выделить следующие недостатки: затруднен полный демонтаж системы, значительная длина межблочных соединений, для каждого отдельного блока необходимо предусматривать автономные системы охлаждения, виброзащиты.
Проанализировав | все | особенности, | было | принято | решение
использовать централизованную компоновочную схему, так как все элементы будут находиться на одной плате и в одном корпусе.
В процессе компоновки элементов на печатную плату необходимо учитывать элементы, которые будут размещаться на передней панели. Для определения формы устройства необходимо заранее выбрать их место размещение.
На последующих стадиях проектирования происходит корректировка и уточнение компоновочных параметров. При компоновке необходимо определить площадь, объем и массу конструкции. В том случае, если результаты расчетов не будут соответствовать требованиям ТЗ, то по

22

согласованию с заказчиком в технически обоснованных случаях в ТЗ могут быть внесены необходимые корректировки.
При компоновке системы обеспечения безопасности котельной жилого дома должны быть учтены следующие основные требования:
– требования по жесткости и прочности;
– эргономика, удобство ремонта;
– наличие достаточного пространства для межблочных соединений;
– сосредоточение центра тяжести ближе у опорной поверхности;
– оптимально размещение комплектующих элементов в модулях всех уровней с учетом коэффициента заполнения по объему и удобству для осмотра и ремонта;
– оптимальность, устойчивость и стабильность функциональных межблочных связей.
Необходимо учитывать влияние паразитных электромагнитных связей при проектировании платы. Учет и анализ этих связей на ранней стадии проектирования позволит снизить затраты на производство всего изделия, а также сократить сроки проектирования и добиться более устойчивой работы. Способом решения этой проблемы является исключение с самого начала конструирования схемы причин, порождающих помехи. При этом необходимо: понять, какие виды помех наиболее вероятны в данной схеме и выбрать и разместить печатные платы, кабели и другие структурные составляющие системы таким образом, чтобы исключить как можно больше причин, вызывающих помехи, и обеспечить при этом возможность подключения подавляющих помехи компонентов.
Помехи бывают двух типов: постоянные и перецеживающиеся. Постоянные помехи имеют один и тот же характер, что облегчает выявление их причины. Перецеживающие помехи появляются время от времени. Такой характер помех сильно затрудняет выявление их источника.
Проблемы возникновения помех и наводок можно свести к минимуму, изолируя чувствительные части схемы от источника помех, устраняя паразитные индуктивные и емкостные связи. Для этого необходимо:
– размещать мощные схемы вблизи нагрузок;
– стараться свести к минимуму длину проводников.
– располагать маломощные схемы поблизости от источника сигнала; – располагать маломощные и мощные схемы как можно дальше друг от друга и использовать максимально короткие контуры прохождения тока.

23

### 5 ВЫБОР СРЕДСТВ ОБЕСПЕЧЕНИЯ ТЕПЛОВОГО

РЕЖИМА, ГЕРМЕТИЗАЦИИ, ВИБРОЗАЩИТЫ И ЭЛЕКТРОМАГНИТНОЙ СОВМЕСТИМОСТИ

Изделия электронной техники связаны с использованием достаточно больших мощностей в сравнительно малых объемах. Это приводит к увеличению выделяющегося при работе тепла. При конструировании техники большое значение имеет разработка методов отвода теплоты, регулирования и контроля температуры.
Выбранный способ охлаждения должен обеспечить заданный по ТЗ тепловой режим техники, который можно проверить расчетным путем конструкции либо опытным путем после испытания макета или опытного образца. Если на ранней стадии конструирования неправильно выбран способ охлаждения, это обнаружится только на более поздних стадиях конструирования, в результате чего сроки создания электронной техники существенно увеличатся.
Выделяемое изделиями тепло может быть отведено от поверхности прибора и передано за пределы аппаратуры несколькими методами, применяемыми отдельно или в сочетании друг с другом. В зависимости от характера и назначения электронных средств применяют следующие методы отвода тепла от индивидуальных изделий электронной техники или групп изделий [8]:
– принудительное воздушное охлаждение;
– естественное охлаждение (воздушное);
– термоэлектрическое охлаждение;
– охлаждение, основанное на изменении агрегатного состояния вещества;
– принудительное жидкостное (без кипения или с поверхностным кипением).
Эффективность того или иного метода охлаждения определяется
значением | коэффициента | теплоотдачи, | то | есть | интенсивностью
протекающих процессов теплоотдачи.
Выбор метода охлаждения определяется следующими факторами: интенсивностью теплового потока, диапазон возможного изменения температуры окружающей среды, условиями эксплуатации, нормами эксплуатации, специальными условиями работы (стационарными или кратковременными режимами, работой против сил тяготения) и другими [8].

24

Проведя анализ схемы системы обеспечения безопасности котельной жилого дома и тип корпуса устройства, можно сделать предположение о возможности применения естественного воздушного охлаждения.
При естественном охлаждении отвод тепла происходит за счет теплопроводности, естественной конвекции окружающего воздуха и излучения.
Необходимо учитывать, что разрабатываемое устройство будет
предназначено | для | эксплуатации | в | помещениях | с | искусственно
регулируемыми климатическими условиями (с отсутствием воздействия атмосферных осадков, прямого солнечного излучения, ветра, песка, пыли, наружного воздуха, отсутствие или существенное уменьшение воздействия рассеянного солнечного излучения и конденсации влаги).
Герметизация является надежным средством защиты от воздействия от пыли, влажности и вредных веществ окружающей среды. Основная цель герметизации – предотвращение воздействия внешних климатических факторов.
Выбор | способа | герметизации | обуславливается | совокупностью
требований к конструкции: условиями реализации нормального теплового режима, плотностью компоновки, ремонтопригодностью, элементоемкостью реализуемой схемы, рядом эксплуатационных требований (изменение
барометрического | давления, | механические | воздействия, | перепады
температур) и надежностью. | Герметизация широко применяется в науке и
технике. Способ герметизации выбирается в зависимости от конкретных целей и условий. Для герметизации используют пайку, сварку и холодное газодинамическое напыление соединений и течей металлических деталей и изделий, специальные герметизирующие материалы (герметики), составы и уплотнения [9].
Воздействие влаги на материал корпуса системы обеспечения безопасности котельной жилого дома и изоляционные материалы имеет разную природу, но одинаковый конечный результат – разрушение исходной структуры материала. Наличие влаги – причина электрохимической коррозии, реакции которой идут при низких температурах.
Разрушение может быть равномерным (по всей поверхности изделия),
и | неравномерным | (например, | за | счет | механического | повреждения
поверхности алюминия и затем образования отверстий в нем).
Влияние влаги на материалы, входящие в состав системы обеспечения безопасности котельной жилого дома, может быть очень значительным из-за
отсутствия | изоляционных | материалов. | Но | разрабатываемая | система

25

относится к классу аппаратуры, которая будет эксплуатироваться в закрытом помещении.
Исходя вышеперечисленных факторов можно сделать вывод, что
окружающая | среда | помещения, | где | будет | использоваться | система
обеспечения безопасности котельной жилого дома, не повлияет на него. Важным является вопрос о необходимости виброзащиты устройства и выборе, при необходимости, способа ее осуществления.
В процессе эксплуатации и транспортировки система обеспечения безопасности котельной жилого дома подвергается различным видам механических воздействий:
– удары (основные параметры: ускорение и длительность);
– вибрации (основные параметры: частота вибраций, и возникающее при этом ускорение);
– линейные ускорения.
Под вибропрочностью понимают способность электронных средств противостоять разрушающему действию вибрации в заданных диапазонах частот и при возникающих ускорениях в течение срока службы, а под виброустойчивостью аппаратуры – способность выполнения всех функций в условиях вибрации в заданных диапазонах частот и возникающих при этом ускорений.
В приборах, не защищенных от вибрации и ударов, узлы, чувствительные к механическим перегрузкам, выходят из строя. Делать такие узлы настолько прочными, чтобы они выдерживали максимальные динамические перегрузки, нецелесообразно, так как увеличение прочности в конечном счете приводит к увеличению массы, а вследствие этого и к неизбежному возрастанию динамических перегрузок. Поэтому считают более целесообразным использовать другие средства для снижения воздействия перегрузок [7].
При проектировании электронных средств прежде всего следует выяснить, нужны ли защитные мероприятия. С этой целью сравнивают оговоренные в технических условиях причины допустимых механических воздействий для предназначенных к использованию элементов (микросхем, резисторов и так далее) с величинами механических действий на объекте установки радиоэлектронных средств. При этом величины воздействующих механических факторов следует скорректировать с учетом возможного резонансного усиления колебаний по пути их распространения с места установки блока до конкретного рассматриваемого элемента. В случае, если

26

уровни воздействующих механических факторов превышают допустимые, предусматривают защитные мероприятия с оценкой их эффективности [7]. Защитные системы от наиболее распространенных видов механических помех, к которым относятся вибрации и удары, могут быть пассивными и активными. Пассивные виброзащитные системы, по сравнению с активными, более просты в исполнении и не требуют для выполнение своих функций затрат дополнительной энергии.
Существует три пассивных способа виброзащиты аппаратуры:
– демпфирование;
– увеличение жесткости конструкции;
– использование виброизоляторов.
Плату системы обеспечения безопасности котельной жилого дома
можно | представить, | как | колебательную | систему | с | равномерно
распределенной нагрузкой. Она характеризуется собственной частотой. Поведение колебательной системы при воздействии на нее извне вибраций зависит от отношения частоты этих вибраций к резонансной частоте. Собственная частота колебаний платы зависит от формы, размеров, характера материала и условий закрепления [7].
Для обеспечения электромагнитной совместимости необходимы ликвидация или максимальное ослабление влияния помех, источников нежелательных сигналов на элементы конструкции. Помехой является непредусмотренный при проектировании электронных средств сигнал, способный вызвать нежелательное воздействие, выраженное в виде нарушения функционирования, искажения передаваемой информации.
Помехами | могут | быть | напряжения, | токи, | электрические | заряды,
напряженность поля и др. Источники помех весьма многообразны по физической природе и подразделяются на внутренние и внешние [7].
Внутренние | помехи | возникают | внутри | электронных | средств.
Источниками | электрических помех | являются | блоки | питания, | цепи
распределения электроэнергии, термопары, потенциалы, возникающие при трении.
Источниками магнитных помех являются трансформаторы и дроссели. При наличии пульсаций выходного напряжения вторичных источников электропитания цепи распределения электроэнергии, тактирующие и
синхронизирующие | цепи | следует | рассматривать | как | источники
электромагнитных помех. Значительные помехи создают электромагниты, электрические двигатели, реле и электромеханические исполнительные механизмы устройств ввода и вывода информации электронных средств.

27

Внутренними помехами являются помехи от рассогласования волновых сопротивлений линий связи с входными и выходными сопротивлениями модулей, которые эти линии соединяют, а также помехи, возникающие по земле [10].
Внешними | помехами | являются | помехи | сети | электропитания,
сварочных аппаратов, щеточных двигателей, передающей радиоэлектронной
аппаратурой, | а | также | помехи, | вызванные | разрядами | статического
электричества, атмосферными и космическими явлениями, ядерными взрывами. Действие на аппаратуру внешних помех по физической природе аналогично действию внутренних помех [10].
Приемниками помех являются высокочувствительные усилители, линии связи, магнитные элементы, характеристики которых изменяются под действием полей рассеивания источников помех. Помехи могут проникать в ЭС непосредственно по проводам или проводникам (гальваническая помеха), через электрическое (емкостная помеха), магнитное (индуктивная помеха) или электромагнитное поле. Многочисленные проводники, входящие в состав любой аппаратуры, можно рассматривать как приемопередающие антенные устройства, принимающие или излучающие электромагнитные поля [10].
Гальваническая связь возникает в результате протекания токов и
падения | напряжений | на | электрических | соединениях | конструкций.
Радикальным способом устранения гальванической помехи является устранение цепей, по которым проходят совместные токи питания и земли как чувствительных к помехам схем, так и сравнительно не чувствительных мощных схем. Таким образом, по проводам, связывающим модули в систему, передаются как полезные сигналы, так и сигналы помехи. Эффективным схемным средством селективного ослабления помехи при отсутствии
ослабления | и | искажения | сигнала | является | использование
помехоподавляющих фильтров [11].
Экраны включаются в конструкцию для ослабления нежелательного возмущающего поля в некотором ограниченном объеме до приемлемого уровня. Возможны два варианта защиты. В первом случае экранируемые средства размещается внутри экрана, а источник помех – вне его, во втором – экранируется источник помех, а защищаемая от помех аппаратура располагается вне экрана. Первый вариант используют при защите от внешних помех, второй – от внутренних. В обоих вариантах в качестве экранов используются металлические оболочки [12].

28

При выполнении линий передачи схемы печатным способом вводятся экранирующие трассы, коммутируемые с шиной нулевого потенциала и
выполняющие | функции | экранов | проводов. | Если | источник | помехи
расположен на соседней плате, то защита схемы экранирующей трассой невозможна.
В проектируемой системе обеспечения безопасности котельной жилого дома, учитывая используемую элементную базу, значительных внутренних помех, оказывающих влияние на работоспособность устройства, не должно возникать. Внешние помехи также не должны возникать. Следовательно, дополнительных средств, снижающих количество помех, не нужно устанавливать на печатную плату [12].

29

### 6 РАСЧЕТ КОНСТРУКТИВНО-ТЕХНОЛОГИЧЕСКИХ

ПАРАМЕТРОВ

### 6.1 Компоновочный расчет печатной платы

Для того, чтобы определить размер печатной платы и габаритные размеры корпуса электронного средства, выполняются компоновочные расчеты. Рассчитываются установочные площади типоразмеров элементов, устанавливаемых на печатные платы. Установочные габаритные размеры ЭВС платы представлены в таблице 6.1.

Таблица 6.1 – Габаритные параметры ЭВС

Элемент | Кол-во, шт. | Установочная площадь, мм² | Объем, мм³
Пьезодинамик CVS-1508 | 1 | 176,72 | 1325,36
Конденсатор керамический GRM -SMD 0805 | 3 | 2,50 | 3,25
Конденсатор танталовый, 10 мкФ | 2 | 2,61 | 3,40
Конденсатор электролитический, 10 мкФ | 2 | 31,17 | 374,06
Конденсатор электролитический, 1 мкФ | 5 | 19,64 | 215,99
Микросхема MIC29302WT, TO-263-5 | 1 | 169,36 | 778,52
Микросхема NCP1117ST50T3G, SOT-223 | 1 | 48,91 | 88,04
Микросхема MAX232, DIP-16 | 1 | 170,00 | 867,00
Микросхема PCF8574, DIP-16 | 3 | 162,64 | 826,21
Микросхема ATmega328P, DIP-28 | 1 | 372,93 | 1771,42
Микросхема SIM900A, SMD-68 | 1 | 576,00 | 1728,00
Резистор серии RC, SMD 0805 | 17 | 2,50 | 1,25
Диод универсальный M7, SMA | 1 | 45,50 | 72,80
Светодиод GNL-3012HD | 1 | 11,95 | 75,26
Светодиод GNL-3012YD | 1 | 11,95 | 75,26
Светодиод GNL-3012GD | 1 | 11,95 | 75,26
Дисплей LCD-20X4B | 1 | 5880,00 | 82320,00
Транзистор КТ3102АМ, TO-92 | 5 | 16,62 | 76,45

30

Продолжение таблицы 6.1

Элемент | Кол-во, шт. | Установочная площадь, мм² | Объем, мм³
Разъем ADC-029 | 1 | 128,70 | 1415,70
Разъем DS1013-24S | 1 | 334,26 | 3048,49
Разъем DS1023-1x7 | 1 | 45,54 | 237,27
Разъем RS-232 | 1 | 321,57 | 3267,14
Разъем SIM5051-6-0-18-00-A | 1 | 276,00 | 483,00
Разъем 901-9894-RFX | 1 | 64,00 | 883,20
Кварцевый резонатор HC-49S | 1 | 51,15 | 214,83
Суммарная установочная площадь всех элементов | Sуст , | мм² ,
вычисляется по следующей формуле:

Sуст = ∑(Si
- n)

n

i=1

= 9483,22 мм²
, | (6.1)

где Si – значение установочной площади i-го элемента;
n – количество элементов.
Для получения суммарной установочной площади платы, значения установочной площади и объема ЭВС подставляются из вышеуказанной таблицы.
Площадь печатной платы вычисляется по следующей формуле:

SПП =

Sуст
m ∙ kз

=

9483,22
1 ∙ 0,5

= 18966,44 мм²
, | (6.2)

где kз – коэффициент заполнения платы;
m – количество сторон монтажа.
Исходя из полученной площади и с учетом крепежных отверстий для платы, а также с учетом отступа от края плата выбираем размеры платы 110 х 180 мм. Площадь такой печатной платы равна 19800 мм²
, что полностью
удовлетворяет запросам по размеру монтажной зоны. Окончательные габариты будут получены в результате размещения элементов и трассировки печатной платы.

31

Вычисление суммарного установочного объема всех элементов системы производится по следующей формуле:

Vуст = ∑(Vi
- n)

n

i=1

= 103453,27 мм³
, | (6.3)

где Vi − значение установочного объема i-го элемента.
Объем заполнения печатной платы вычисляется по следующей формуле:

Vреал =

Vуст
kЗ

=

103453,27
0,5

= 206906,53 мм³
, | (6.4)

где kЗ – коэффициент заполнения по объему.
Чертеж печатной платы системы обеспечения безопасности котельной жилого дома представлен на чертеже ГУИР.758725.001. Сборочный чертеж печатной платы представлен на чертеже ГУИР.425158.001 СБ.

### 6.2 Компоновочный расчет устройства

Для компоновочного расчета устройства необходимо использовать расчеты из раздела 6.1 и добавить объемы заполнения модулей из таблицы 6.2.

Таблица 6.2 – Установочные объемы остальных модулей системы обеспечения безопасности котельной жилого дома

Модуль | Кол-во, шт. | Установочный объем, мм³
Клавиатура AK-304-N-BBW | 1 | 25785,6

По таблице 6.2 и результатам расчетов из раздела 6.1 вычислим суммарный установочный объем всех модулей по следующей формуле:

Vкорп = Vреал + ∑(Vмi
- n)

n

i=1

= 206906,53 + 25785,6 = 232692,13 мм³ , (6.5)

где Vмi – площадь каждого модуля в отдельности.

32

Исходя из полученного объема и объема изделий электронной техники электронного средства с учетом элементов коммутации определяется размер корпуса 130 х 200 х 10 мм.
Окончательный вывод о размерах корпуса электронного средства делается с учетом элементов коммутации, если они присутствуют в корпусе.
Сборочный | чертеж | устройства | представлен | на | чертеже
ГУИР.425159.001 СБ.

### 6.3 Расчет параметров печатной платы

Будет использоваться печатная плата 2-ой группы жесткости по ГОСТ
23752-79. | Данная | печатная | плата | должна | удовлетворять | условиям
эксплуатации по ГОСТ 15150-69 УХЛ 4.2.
Печатные платы 2-ой группы жесткости имеют диапазон рабочих температур от -40 до +85°C и обеспечивают надежную работу при относительной влажности до 98% при температуре +35°C. Кроме того, характеризуются стойкостью к повышенному давлению [13].
Класс точности определяет наименьшее минимальное значение основных размеров конструктивных элементов. ГОСТ 23751-86 определяет 5 классов точности. Параметры классов точности представлены в таблице 6.3.

Таблица 6.3 – Классы точности печатных плат [14]

Параметр | Класс точности
1 | 2 | 3 | 4 | 5
Мин. ширина проводника, t, мм | 0,75 | 0,45 | 0,25 | 0,15 | 0,10
Мин. расстояние между центрами проводников, S, мм | 0,75 | 0,45 | 0,25 | 0,15 | 0,10
Мин. ширина гарантийного пояска, В, мм | 0,30 | 0,20 | 0,1 | 0,05 | 0,025
Отношение диаметра мин. отверстия к толщине ПП (γ) | 1:2,5 | 1:2,5 | 1:3 | 1:4 | 1:5

Исходя из технологических возможностей производства был выбран комбинированный позитивный метод изготовления печатной платы. Разработка печатной платы ведется по 3-му классу точности, так как используется двусторонняя печатная плата с односторонним монтажом.

33

Допуски на расположение отверстий и контактных площадок для 3-го класса точности печатной платы приведены в таблице 6.4.

Таблица 6.4 – Допуски на расположение отверстий и контактных площадок для 3-го класса точности ПП [14]

Параметры, мм | Значение допуска
Допуск на отверстие ∆d без металлизации, d ≤ 1 мм | ±0,05
То же, d > 1 | ±0,1
Допуск на отверстие ∆d с металлизацией и оплавлением, d ≤ 1 мм | +0,00 -0,13
То же, d > 1 | +0,05 -0,18
Допуск на ширину печатного проводника, контактной площадки, концевого печатного контакта, экрана ∆b без покрытия | ±0,05
То же, с покрытием | ±0,1
Допуск на расположение осей отверстий δd(Td), при размере платы по большей стороне менее 180 | 0,08
Допуск на расположение центров контактных площадок δp(TD), при размере платы большей стороне менее 180 | 0,15
Допуск на расположение центров (осей) проводников δl(Tl) относительно центра (оси) любого другого элемента поводящего рисунка, при размере платы большей стороне менее 180 | 0,03

Диаметры контактных площадок и монтажных отверстий выбираются в соответствии с ГОСТ 10317-79.
Расчет конструктивно-технологических параметров печатной платы: При выборе толщины печатной платы следует учитывать, что с увеличением ее толщины и уменьшением диаметра отверстий усложняется технология нанесения металлизации, поэтому рекомендуется выбирать толщину печатной платы согласно пропорции γ, представленной в таблице 6.3:

d0
Нп

≥

1
4
, | (6.6)

34

где Нп – толщина печатной платы;
d0 – минимальный диаметр металлизированных отверстий. Следовательно, толщина печатной платы 1,5 мм.
Определим | минимальную | ширину | печатного | проводника | по
постоянному току для цепей питания и заземления:

b1min =

Imax
jдоп ∗ ℎф
, | (6.7)

где Imax – максимальный постоянный ток, протекающий в проводниках, А; jдоп – допустимая плотность тока, выбирается в зависимости от метода
изготовления | печатной | платы | (jдоп = 48 А мм² ⁄ | для

комбинированного позитивного метода);
ℎф – толщина проводника (фольги), мм.

b1min =

0,4872
48 ∗ 0,035 = 0,29 мм .

Определим номинальное значение диаметров монтажных отверстий по следующей формуле:

d = dЭ + |dН.О.

| + r , | (6.8)
где dэ | – максимальное значение диаметра вывода навесного ЭВС,
устанавливаемого на печатную плату. Для прямоугольного вывода за диаметр берется диагональ его сечения;
dН.О. – нижнее предельное отклонение от номинального диаметра
монтажного | отверстия | (определяется | классом | точности
печатной платы и диаметром отверстия), мм;
r | – | разница | между | минимальным | диаметром | отверстия | и
максимальным диаметром вывода ЭВС, ее выбирают в пределах 0,1…0,4 мм. Примем r = 0,1 мм.
Диаметры монтажных и переходных отверстий металлизированных и
не | металлизированных | должны | соответствовать | ГОСТ | 10317-79.
Предпочтительные размеры монтажных отверстий выбирают из ряда 0,4; 0,5; 0,6; 0,7; 0,8; 0,9; 1,0; 1,1; 1,2; 1,3; 1,4; 1,5; 1,6; 1,7; 1,8; 2,0 мм [15].
Подставим данные о диаметрах выводов элементов в формулу 6.8:

35

d1 = 0,8 + 0,05 + 0,1 = 0,95 ~ 1 мм ,

d2 = 0,6 + 0,05 + 0,1 = 0,75 ~ 0,8 мм ,

d3 = 0,5 + 0,05 + 0,1 = 0,65 ~ 0,7 мм ,

d4 = 0,559 + 0,05 + 0,1 = 0,709 ~ 0,8 мм ,

d5 = 0,586 + 0,05 + 0,1 = 0,736 ~ 0,8 мм ,

d6 = 0,55 + 0,05 + 0,1 = 0,7 мм ,

d7 = 0,905 + 0,05 + 0,1 = 1,055 ~ 1,1 мм ,

d8 = 0,898 + 0,05 + 0,1 = 1,048 ~ 1,1 мм ,

d9 = 0,6 + 0,05 + 0,1 = 0,75 ~ 0,8 мм ,

d10 = 0,5 + 0,05 + 0,1 = 0,65 ~ 0,7 мм ,

d11 = 1,27 + 0,1 + 0,1 = 1,47 ~ 1,5 мм ,

d12 = 1,442 + 0,1 + 0,1 = 1,642 ~ 1,7 мм ,

d13 = 1,52 + 0,1 + 0,1 = 1,72 ~ 1,8 мм ,

d14 = 0,978 + 0,05 + 0,1 = 1,128 ~ 1,2 мм ,

d15 = 1,2 + 0,1 + 0,1 = 1,4 мм .

Рассчитаем | диаметры | контактных | площадок. | Наименьшее
номинальное значение диаметра контактной площадки под выбранное отверстие рассчитывается по формуле:

Dmin = (d + ∆dво) + 2 ∗ b + ∆tво + 2 ∗ ∆dтр + √Td
| | | 2 + TD

2 + ∆tно

| | | | 2
, | (6.9)

где d – номинальное значение монтажного отверстия;
b – размер гарантийного пояска;
Δdво – верхнее предельное отклонение диаметра отверстия;

36

Δdтр – величина подтравливания диэлектрика, которая для МПП принимается равной 0,03 мм, для ОПП, ДПП, ГПК – нулю; Td – позиционный допуск расположения оси отверстия;
TD – позиционный допуск расположения центра контактной площадки; Δtво – верхнее предельное отклонение диаметра контактной площадки; Δtно – нижнее предельное отклонение диаметра контактной площадки.

Dmin1 = 1,18 мм ,

Dmin2 = 1,28 мм ,

Dmin3 = 1,48 мм ,

Dmin4 = 1,63 мм ,

Dmin5 = 1,73 мм ,

Dmin6 = 2,03 мм ,

Dmin7 = 2,23 мм .

Максимальный диаметр контактной площадки:

Dmax = Dmin + (0,02. .0,06) , | (6.10)

Dmax1 = 1,24 мм ,

Dmax2 = 1,34 мм ,

Dmax3 = 1,54 мм ,

Dmax4 = 1,69 мм ,

Dmax5 = 1,79 мм ,

Dmax6 = 2,09 мм ,

Dmax7 = 2,29 мм .

37

Определим ширину проводников. Минимальная ширина проводников для ДПП, изготовляемых комбинированным позитивным методом при фотохимическом способе получения рисунка:

bmin = b1min + 1,5 ∗ ℎф + 0,03 , | (6.11)

где b1min – минимальная эффективная ширина проводника. Для 3-го класса b1min = 0,18 мм;
ℎф – толщина фольги, которая равна 0,035 мм.

bmin = 0,18 + 1,5 ∗ 0,035 + 0,03 = 0,2625 мм .

Максимальная ширина проводника:

bmax = bmin + (0,02. .0,06) , | (6.12)

bmax = 0,18 + 0,06 = 0,3225 мм .

После проведения вышеизложенных расчетов можно сделать вывод о
том, | что | параметры | печатного | монтажа | отвечают | требованиям,
предъявляемым к платам 3-го класса точности.

### 6.4 Оценка теплового режима

Проведем расчет теплового режима устройства.
Определим площадь поверхности корпуса по следующей формуле:

SК = 2 ⋅ [L1 ⋅ L2 + LЗ

⋅ (L1 + L2

| | | | )] , | | (6.13)

где L1, L2, LЗ – габаритные размеры блока.

Sk = 2 ∙ [0,200 ∙ 0,130 + 0,010 ∙ (0,200 + 0,130)] = 0,059 м

| | | | | | 2

Определим поверхность нагретой зоны:

SЗ = 2 ⋅ [L1 ⋅ L2 + KЗ

⋅ L3 ⋅ (L1 + L2

| | | | | )] , | (6.14)

38

где L1, L2, L3 – размеры нагретой зоны;
KЗ – коэффициент заполнения (KЗ = 0,5).

SЗ = 2 ∙ [0,200 ∙ 0,130 + 0,5 ∙ 0,010 ∙ (0,200 + 0,130)] = 0,055 м

2

Определим удельную мощность, рассеиваемую с поверхности нагретой зоны:

qЗ =

P
SЗ
, | (6.15)

где Р – мощность источников тепла, рассеиваемая в аппарате.

P = Kнагруз.

⋅ Pпотр.

, | (6.16)

где Pпотр. – мощность, потребляемая устройством; Kнагруз. – коэффициент нагрузки (0,4…0,8).

Pпотр. = U ⋅ I = 12 ∗ 1,5 = 18 Вт ,

P = 0,5 ∗ 18 = 9 Вт ,

q3 =

9
0,055 = 162,75 Вт м

2 ⁄ .

Определим удельную мощность, рассеиваемую поверхностью корпуса:

qК =

P
SК
, | (6.17)

qК =

9
0,059 = 153,58 Вт м

2 ⁄ .

Определим коэффициент, являющийся функцией удельной мощности корпуса:

Q1 = 0,1472 ⋅ qK − 0,2962 ⋅ 10

−3
⋅ qK

2 + 0,3127 ⋅ 10

−6
⋅ qK

3
. | (6.18)

39

Подставив значения в данную формулу, получим следующий результат:

Q1 = 0,1472 ∙ 153,58 − 0,2963 ∙ 10⁻³

- 153,58² + 0,3127 ∙ 10⁻⁶
- 153,58³ =
= 16,75 .

Определим коэффициент, являющийся функцией удельной мощности нагретой зоны:

Q2 = 0,1390 ⋅ qЗ − 0,1223 ⋅ 10

−3
⋅ qЗ

2 + 0,0698 ⋅ 10
−6
⋅ qЗ

3
. | (6.19)

Подставив значения в данную формулу, получим следующий результат:

Q2 = 0,1390 ∙ 162,75 − 0,1223 ∙ 10⁻³

- 162,75² + 0,0698 ∙ 10⁻⁶
- 162,75³ =
= 19,68 .

Найдем коэффициент, зависящий от давления окружающей среды:

KH1 = 0,82 +

1
0,925 + 4,6 ⋅ 10

−5 ⋅ H1

, | (6.20)

где H1 – давление окружающей среды, которое равно 10

5 Па.

KH1 = 0,82 +

1
0,925 + 4,6 ⋅ 10

−5 ⋅ 10

5 = 1.001 .

Определим коэффициент, зависящий от давления внутри корпуса:

KH2 = 0,82 +

1
1,25 + 5,8 ⋅ 10

−5 ⋅ H2

, | (6.21)

где H2 – давление внутри корпуса, которое равно 10

5 Па.

KH2 = 0,82 +

1
1,25 + 5,8 ⋅ 10

−5 ⋅ 10

5 = 0,942 .

Определим перегрев корпуса:

40

QK = Q1 ⋅ KH1 , | (6.22)

QK = 16,75 ∙ 1,001 = 16,77 C

o

Определим перегрев нагретой зоны:

QЗ = QК + (Q2 − Q1

) ⋅ KH2 , | (6.23)

QЗ = 16,77 + (19,68 − 16,75) ∙ 0,942 = 19,53 C

o

Определим температуру корпуса:

TK = QK + TC , | (6.24)

где TC – верхнее значение температуры окружающей среды, которое равно 40 C

o

TK = 16,77 + 40 = 56,77 C

o

Определим температуру нагретой зоны:

TЗ = QЗ + TC , | (6.25)

TЗ = 19,53 + 40 = 59,53 C

o

Полученные результаты свидетельствуют об удачно проведенном тепловом расчете, так как расчетные числовые значения температур меньше предельно допустимых значений, обеспечивающих безотказную работу в течение заданного отрезка времени непрерывной работы.
При выборе типа корпуса в первую очередь нужно было опираться на габаритные размеры печатные платы, чтобы в дальнейшем удобно и беспроблемно закрепить печатную плату. Так же нужно было учитывать габаритные размеры антенны, дисплея, клавиатуры и разъемов. На основе данных факторов и происходил выбор типа корпуса.
На основании расчетов и условий эксплуатации был выбран негерметичный корпус.

41

### 6.5 Расчет механической прочности

Для того чтобы проверить насколько хорошо защищено проектируемое устройство от механических воздействий, необходимо провести расчеты собственных частот вибраций, а затем подобрать соответствующие виброизоляторы.
Так как систему обеспечения безопасности котельной жилого дома предполагается использовать без виброизоляторов, то в этом случае печатная плата является единственной колебательной системой.
Жесткость плат зависит от материала, формы, геометрических размеров и способа закрепления.
Печатная | плата | разрабатываемого | прибора | изготовлена | из
стеклотекстолита марки СФ-2-35-1,5. Она имеют прямоугольную форму следующих размеров: a × b × ℎ = 180 мм × 110 мм × 1,5 мм.
Расчет собственной частоты колебания плат позволяет подобрать основные параметры их конструкции, исключающие возможности появления резонанса. При расчете платы ее представляют в виде тонкой пластины, так как отношение толщины платы к наименьшему из двух размеров меньше, чем 1:10.
При расчете платы-пластины принимают следующие упрощения:
– толщина платы постоянна;
– ЭРЭ на плате располагаются равномерно на ее поверхности;
– изгибные деформации при колебаниях малы, по сравнению с толщиной, упругие деформации подчиняются закону Гука;
– материал пластины идеально упругий, однородный и изотропный. Для данного способа закрепления платы, поправочный коэффициент, учитывающий способ закрепления равен:

Kα = 22,37 ∙ √1 + 0,61(

a
b

)

2 + (

a
b

)

4 , | (6.26)

где а – длина большей стороны; b – длина меньшей стороны.

Ka = 22,37 ∙ √1 + 0,61 ∙ ( 180
110)

2
+ (

180
110)

4
= 70,04 .

42

Цилиндрическая жесткость платы равна:

D =

E ∗ ℎ

3
12 ∗ (1 − γ)

2

,

(6.27)

где Е – модуль упругости материала платы Е = 3,02·10¹⁰ Н/м² ;
h – толщина печатной платы, h = 1,5·10⁻³ м;
γ – коэффициент Пуассона для материала платы, γ = 0,22.

D =

3,02 ∙ 10¹⁰ ∙ (1,5 ∙ 10⁻³
)

3
12 ∙ (1 − 0,22)

2 = 13,96 .

Распределенная по площади масса платы и ЭРЭ:

m′′ = ρ ∗ ℎ +

mэ
a ∗ b
, | (6.28)

где ρ – удельная плотность материала платы, ρ = 2,05·10³

кг/м³
;
mЭ – масса элементов, mЭ = 0,055 кг.

m′′ = 2,05 ∙ 10³

- 1,5 ∙ 10⁻³ +

0,055
0,18 ∙ 0,11 = 5,85

кг
м²

Определим частоту собственных колебаний плат:

f0 =

Ka
2π ∗ a

2

√
D
m′′ ,

(6.29)

f0 =

60,997
2π ∙ 0,18²

√
13,96
5,85 = 531,38 Гц .
Как | упругая | пластина | печатная | плата | может | подвергнуться
усталостному | разрушению | при | действии | циклических | нагрузок, | в
особенности при резонансе. | В результате нарушаются контактные
соединения в разъемах, разрушаются пленочные проводники, места пайки и т.д. Подобные отказы в работе радиоэлектронных средств в какой-то мере

43

можно избежать, выполнив условие (6.30) и обеспечив тем самым достаточную усталостную долговечность платы в вибрационном поле.

f0 ≥ √(
β ∗ g ∗ nbmax
0,003 ∗ b

)

2 3
,

(6.30)

где f0 – минимальная частота собственных колебаний платы; nbmax – максимальные вибрационные перегрузки, g;
g – ускорение свободного падения, то принимаем g = 9,81 м/с²
;
β – безразмерная постоянная, выбираемая в зависимости от частоты собственных колебаний и воздействующих ускорений.

f0 = √(
35 ∙ 9,81 ∙ 57
0,003 ∙ 100 )

2 3
= 1620,54 Гц .

Условие (6.30) выполняется: fmin = 1620,5 Гц ≥ 531,38 Гц. Таким образом, плата будет обладать достаточной усталостной долговечностью при воздействии вибраций.
Амплитуда изгибных колебаний по формуле:

Az =

n0
4 ∗ f0

2 ≤ 3 ∗ 10⁻⁴
, | (6.31)

где nb – максимальные вибрационные перегрузки, выраженные в единицах g; f0 – минимальная частота собственных колебаний платы.

Аz =

57
4 ∙ 1620,54² = 5,43 ∙ 10⁻⁶ .

Исходя из полученных значений, проектируемая печатная плата будет иметь достаточную усталостную прочность при гармонических вибрациях.

### 6.6 Обеспечение электромагнитной совместимости

Рассчитаем сопротивление проводника по формуле:

44

R =

ρ ∙ ln
(b ∙ tn

)

, | (6.32)

где ρ – удельное объемное электрическое сопротивление проводника, ρ = 0,0175 мкОм/м – для медных проводников, полученных методом химического травления;
ln − длина проводника, мм;
b – ширина проводника, мм;
tn – толщина проводника, мкм.

R1 =

0,0175 ∙ 50
(0,29 ∙ 35)

= 0,086 Ом .

Рассчитаем допустимый ток в печатном проводнике:

Imax = 10⁻³
- γдоп ∙ b ∙ tn , | (6.33)

где γдоп – допустимая плотность тока, которая равна 48 А/мм² .

Imax = 10⁻³
∗ 48 ∗ 0,29 ∗ 35 = 0,4872 А .

Далее найдем паразитные емкости и индуктивности печатного монтажа в наиболее критических местах печатной платы. Для расчета паразитной емкости выбирается участок, где она наибольшая. Емкость между двумя выбранными проводящими элементами определяется по формуле:

C =

0,12 ∙ ξr

- ln
log10 [

2a
b + tn

]

,
(6.34)

где ln – длина участка, на котором проводники параллельны друг другу, мм; а – толщина диэлектрика, мм (a = 0,5 мм);
b – ширина проводника, мм (b = 0,2925 мм);
tn – толщина проводника, мм (tn = 35 мкм);
ξr – диэлектрическая проницаемость среды между проводниками, расположенных на наружных поверхностях платы, покрытой лаком, определяется по формуле:

45

ξr = 0,5 ∙ (ξП + ξЛ

) , | (6.35)

где ξп и ξл – диэлектрические проницаемости материала платы и лака (для стеклотекстолита ξп = 6, для лака ξл = 4).

ξr = 0,5 ∙ (6 + 4) = 5 ,

C =

0,12 ∙ 5 ∙ 50 ∗ 10

−3
log10 [

2 ∗ 0,5
0,29 + 35]

= 19,384 пФ .

Для расчета паразитной индуктивности проводников печатной платы, рассчитывается собственная индуктивность печатного проводника, по формуле:

L = 0,0002 ⋅ ln ⋅ (lg

2 ⋅ ln
tn + b

+ 0,2235 ⋅

tn + b
ln
+ 0,5) , | (6.36)

где ln – длина участка проводника, мм; b – ширина проводника, мм;
tn – толщина проводника, мм.

L = 0,011 мкГн .

Индуктивность | двух | параллельных | печатных | проводников,
расположенных с одной стороны печатной платы с зазором и с противоположным направлением тока в них рассчитывается по формуле:

L = 0,0004 ⋅ ln ⋅ (ln

a + b
tn + b

−

a − b
ln

+ 0,2235 ⋅

tn + b
ln
+ 1,5) , | (6.37)

где ln – длина участка, на котором проводники параллельны друг другу, мм; b – ширина проводника, мм;
tn – толщина проводника, мм;
а – толщина диэлектрика, мм.

46

L = 0,003 мкГн .

Полученные значения паразитной емкости и индуктивности малы и ими можно пренебречь и дополнительных мер по ее устранению предпринимать не следует.

### 6.7 Оценка надежности устройства

Свойство изделия сохранять во времени в установленных пределах значения параметров, которые отвечают за работоспособность в заданных режимах и условиях применения, определяется как надежность.
Надежность | радиоэлектронных | средств | напрямую | зависит | от
следующих факторов: качество и количество электрорадиоэлементов, входящих в него, условия эксплуатации, качества сборки, а также от своевременности обслуживания и ремонта.
К качественным характеристикам надежности относятся:
– безотказность;
– долговечность;
– сохраняемость;
– ремонтопригодность.
Безотказность | – | это | способность | устройства | сохранять
работоспособность в течение определенного времени.
Долговечность | – | это | способность | устройства | сохранять
работоспособность до наступления предельного состояния при выполнении установленных требований по техническому обслуживанию и ремонту. Сохраняемость – это способность устройства непрерывно находиться в исправном состоянии при хранении и транспортировании.
Ремонтопригодность | – | это | способность | устройства, | которое
заключается в его приспособленности к предупреждению и обнаружению возможных причин возникновения отказов, повреждений, и устранению их последствий путем проведения ремонтов и технического обслуживания. Предельное состояние – это способность устройства, при котором его дальнейшая эксплуатация должна быть прекращена.
Для периода нормальной эксплуатации выполним расчет при следующих допущениях:
– отказы элементов случайны и независимы;
– учитываются только случайные отказы;
– имеет место экспоненциальный закон надежности устройства.

47

Исходными данными для расчета являются значения интенсивности отказов для всех электрорадиоэлементов, установленных на печатной плате. Заданное время работы tз составляет 12000 ч.
Таблица 6.5 содержит интенсивность отказов каждого элемента.

Таблица 6.5 – Значение интенсивности отказов отдельных элементов

Группа элементов | Кол-во элемен-тов в группе, ni | Интенсив-ность отказов для элементов группы, λoj ∗ ∗ 10⁻⁶1/ч | Произве-дение niλoj ∗ ∗ 10⁻⁶1/ч
1 | 2 | 3 | 4
Микропроцессор ATmega328P | 1 | 0,023 | 0,023
Микросхема SIM900A | 1 | 0,023 | 0,023
Микросхема MIC29302WT | 1 | 0,028 | 0,028
Микросхема NCP1117ST50T3G | 1 | 0,028 | 0,028
Микросхема MAX232 | 1 | 0,028 | 0,028
Микросхема PCF8574 | 3 | 0,028 | 0,084
Пьезодинамик | 1 | 0,027 | 0,027
LCD-дисплей LCD-20X4B | 1 | 0,21 | 0,21
Светодиод | 3 | 0,034 | 0,102
Конденсатор электролитический | 7 | 0,173 | 1,211
Конденсатор танталовый | 2 | 0,022 | 0,044
Конденсатор керамический | 3 | 0,022 | 0,066
Кварцевый резонатор HC-49S | 1 | 0,026 | 0,026
Резистор SMD 0805 | 17 | 0,044 | 0,748
Транзистор BC547 | 5 | 0,065 | 0,325
Разъем 24-контактный | 1 | 0,015 | 0,015
Разъем 7-контактный | 1 | 0,015 | 0,015
Разъем питания ADC-029 | 1 | 0,3 | 0,3
Разъем RS-232 | 1 | 0,0044 | 0,0044
Разъем SIM5051 | 1 | 0,0044 | 0,0044
Разъем RECE.20279 | 1 | 0,3 | 0,3
Печатный монтаж | 210 | 0,000017 | 0,00357
λoj | | | 3,62

Необходимо скорректировать λΣ с учетом электрического режима и условия работы элементов (Кэ = 5):

48

λΣ

(v) = 3,62 ∗ 10⁻⁶

∗ 5 = 18,1 ∗ 10⁻⁶ 1/ч .

Наработка на отказ:

ТО =

1
18,1 ∗ 10⁻⁶ = 55249 ч .

Вероятность безотказной работы за время tЗ:

P(tЗ

) = e

−

12000
55249 = 0,8 .
В результате расчета надежности | получено, | что | вероятность
безотказной работы за заданное время tз составляет 0,8.

### 6.8 Обеспечение требований эргономики и инженерной психологии

Выделяют следующие эргономические требования:
– антропометрические – соответствие конструкции изделия размерам и форме тела человека и его частей (ног и рук), входящих в контакт с изделием;
– | физиологические | и | психофизиологические | (соответствие
конструкции изделия силовым, скоростным, зрительным возможностям человека);
– гигиенические (освещенность, вентилируем ость, температура, токсичность, шум. вибрация, напряженность электрического и магнитного полей);
– психологические (соответствие конструкции изделия возможностям
восприятия | и | переработки | информации, | закрепленным | и | вновь
формируемым навыкам человека).
Размещение органов управления и индикации необходимо производить по следующим правилам:
– по функциям;
– по удобству пользования;
– по частоте пользования;
– по важности;
– по последовательности пользования.
При компоновке панели должны соблюдаться следующие правила [16]:

49

– органы управления и индикаторы должны быть расположены соответственно последовательности пользования: слева направо при расположении в одну линию по горизонтали и сверху вниз при размещении в одну линию по вертикали;
– | зрительный | обзор | панели | должен | создаваться | основными
функционально-конструктивными элементами, не должно быть лишних элементов, надписей, линий и др.;
– композиционная упорядоченность требует размещать внешние установочные изделия по четкой системе перпендикуляров и параллелей. Компоновку лицевой панели необходимо начинать выполнять с анализа работы оператора с устройством. Для этого необходимо графически изобразить все элементы панели, а затем установить взаимосвязь между ними и оператором.
Рабочие операции необходимо распределить между правой и левой рукой оператора. Для правой руки нужно выделить органы управления, связанные с наиболее ответственными и точными операциями. Количество и траектории рабочих движений должны быть сокращены до минимума.
При размещении внешних установочных изделий следует выполнять общее правило: органы индикации необходимо располагать вверху, органы управления – в средней части, а органы подключения – внизу лицевой панели.
В устройстве, проектируемом в дипломном проекте, органы индикации присутствуют и располагаются в верхней и средней части, органы управления расположены в средней части и органы подключения – внизу корпуса.

50

### 7 ВЫБОР ПРОГРАММНОГО ОБЕСПЕЧЕНИЯ САПР

В данном проекте для выполнения различных видов чертежей, была использована САПР AutoCAD.
AutoCAD — двух- и трехмерная система автоматизированного проектирования и черчения, которая была разработана компанией Autodesk.
Первая | версия | программы | появилась | в | 1982 | году. | AutoCAD | и
специализированные приложения на его основе нашли широкое применение
в | машиностроении, | строительстве, | архитектуре | и | других отраслях
промышленности [17].
Для проектирования чертежей были использованы различные базовые
функции | системы: | создание | слоев, | примитивных | элементов, | их
масштабирование; выбор толщины и типа основных, тонких и осевых линий. Одной из важных функций AutoCAD является возможность импорта и экспорта PDF файлов. Некоторые чертежи были экспортированы из Altium Designer в формате PDF и импортированы в AutoCAD для их доработки. Altium Designer — комплексная система автоматизированного проектирования радиоэлектронных средств, разработанная компанией Altium. Данная система позволяет реализовывать проекты электронных средств на уровне схемы или программного кода с последующей передачей информации проектировщику ПЛИС или печатной платы. Отличительной особенностью программы является проектная структура и сквозная целостность ведения разработки на разных уровнях проектирования, что позволяет передавать изменения в разработке на уровне платы на уровень ПЛИС или схемы, а также наоборот [18].
В состав программного комплекса Altium Designer входит весь необходимый инструментарий для разработки, редактирования и отладки проектов на базе электрических схем и ПЛИС. Редактор схем позволяет вводить многоиерархические и многоканальные схемы любой сложности, а также проводить смешанное цифро-аналоговое моделирование. Библиотеки программы содержат более 90 тысяч готовых компонентов, у многих из которых имеются модели посадочных мест, а также трехмерные модели. Редактор печатных плат Altium Designer содержит мощные средства интерактивного размещения компонентов и трассировки проводников, которые совместно с интуитивной и полностью визуализированной системой
установки | правил | проектирования | максимально | упрощают | процесс
разработки | электроники. | Инструменты | трассировки | учитывают | все
требования, | предъявляемые | современными | технологиями | разработок,

51

например, при трассировке дифференциальных пар или высокочастотных участков плат. В состав программы входит автоматический трассировщик Situs, в котором используются наиболее прогрессивные алгоритмы трассировки печатных проводников.
Работа над всеми частями проекта ведется в единой управляющей оболочке Design Explorer, которая позволяет разработчику контролировать целостность проекта на всех этапах проектирования. В дополнение к мощным средствам разработки, Altium Designer имеет широкие возможности импорта и экспорта сторонних систем проектирования и поддерживает практически все стандартные форматы выходных файлов (Gerber, ODB++, DXF).
Благодаря вышеперечисленным преимуществам, САПР Altium Designer
была | использована | как | основная | система | автоматизированного
проектирования.
Важным этапом при проектировании печатных узлов является разработка конструкторской документации.
В | процессе | разработки | конструкторской | документации | был
использован плагин для Altium Designer — Board Assistant. Board Assistant
является | специализированной | панелью | инструментов, | позволяющая
разрабатывать и оформлять перечень элементов, схему электрическую принципиальную и конструкторскую документацию на печатные платы в формате PDF, добавлять на чертеж печатной платы обозначения сквозных отверстий, а также добавлять таблицу со сквозными отверстиями и иные дополнительные функции. На рисунке 7.1 показано основное окно плагина.


Рисунок 7.1 – Окно плагина Board Assistant

52

С помощью данного плагина был оформлен чертеж печатной платы. Для упрощения формирования конструкторской документации в Altium Designer был добавлен редактор Draftsman. Интерфейс редактора показаны на рисунке 7.2.

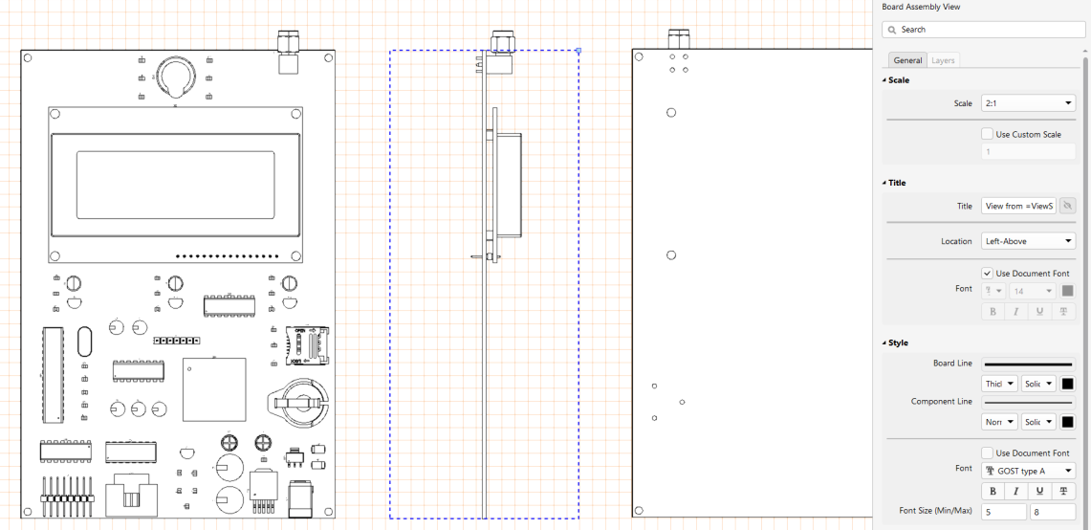
[picture p42: figure]

Рисунок 7.2 – Интерфейс и рабочая область редактора Draftsman

Редактор Draftsman был использован для формирования сборочного чертежа и чертежей нестандартных установок ЭВС, которые позже были перенесены в AutoCAD и доработаны. Перечень элементов и спецификация были оформлены в текстовом редакторе MS Word.

53

### 8 РЕКОМЕНДАЦИИ ПО ОБЕСПЕЧЕНИЮ

ЭЛЕКТРИЧЕСКОЙ И ЭКОЛОГИЧЕСКОЙ БЕЗОПАСНОСТИ ПРИ ЭКСПЛУАТАЦИИ И ПРОИЗВОДСТВЕ УСТРОЙСТВА

При производстве устройства наибольшей опасности подвергаются рабочие при выполнении заготовительных операций. К ним относятся: разрезка материала, раскрой заготовоки выполнение базовых отверстий на заготовках печатных плат. В крупносерийном производстве разрезку материала выполняют методом штамповки в специальных штампах на эксцентриковых прессах с одновременной пробивкой базовых отверстий на технологическом поле. В серийном и мелкосерийном производстве широкое распространение получили одно- и много ножевые роликовые ножницы. Разрезку основных и вспомогательных материалов, необходимых при изготовлении печатной платы в мелкосерийном и единичном производстве, осуществляют с помощью гильотинных ножниц.
Базовые отверстия получают различными методами в зависимости от класса печатной платы. На печатной плате первого класса базовые отверстия получают методом штамповки с одновременной вырубкой заготовки. Базовые отверстия на заготовках плат второго и третьего классов получают сверлением в универсальных кондукторах.
В настоящее время в серийном производстве сверление базовых отверстий по кондуктору на универсальных сверлильных станках уступило место сверлению на специализированных станках.
Можно выделить следующие факторы обитаемости:
– психофизические факторы — наибольшую опасность представляет работа пресса в автоматическом режиме, требующая большого напряжения, внимания и осторожности работающего, так как всякое замедление движения рабочего может привести к травматизму;
– химические факторы — при выполнении базовых отверстий на сверлильных станках может выделятся большое количество пыли, текстолит и гетинакс выделяют при контакте с раскаленным сверлом токсичные вещества;
– физические факторы — механизмы для раскройки плат (прессы, механические ножницы, сверлильные станки), наибольшую опасность представляют механизмы с ручной подачей материала и работающие в автоматическом режиме.

54

При работе на станках с ручной подачей материала труд относится к тяжелой категории, а при работе с автоматической подачей материала – к средней категории тяжести.
Во избежание попадания рук рабочего в опасную зону применяют системы двурукого включения, при котором пресс включается только после одновременного нажатия обеими руками двух пусковых кнопок.
В прессах и ножницах с педалями для предотвращения случайных включений педаль ограждают или делают запорной. Часто опасную зону прессов ограждают при помощи фотодатчиков, сигнал от которых автоматически останавливает пресс, если рука рабочего оказалась в опасной
зоне. | При | ручной | подаче | необходимо | применять | специальные
приспособления (пинцеты, крючки и т. д.).
Хорошим решением вопроса безопасности является механизация и автоматизация подачи и удаления заготовок из штампа, в том числе с использованием средств робототехники.
Во избежание травм при работе на сверлильных станках необходимо следить за тем, чтобы все ремни, шестерни и валы имели жесткие неподвижные ограждения. Движущиеся части и механизмы оборудования, требующие частого доступа для осмотра, ограждаются съемными или открывающимися устройствами ограждения. В станках без электрической блокировки должны быть приняты меры, исключающие возможность случайного или ошибочного их включения во время осмотра.
Во избежание захвата одежды и волос рабочего его одежда должна быть заправлена так, чтобы не было свободных концов; обшлага рукавов следует застегнуть, волосы убрать под берет.
Образующиеся при сверлении, резке материала заготовок ПП пыль необходимо удалять с помощью промышленных пылесосов.
При | эксплуатации | устройства | для | соблюдения | электрической
безопасности запрещается:
– превышать допустимую токовую нагрузку;
– оклеивать и окрашивать электрические провода, кабели и само устройство;
– эксплуатировать устройство в условиях, не соответствующих требованиям эксплуатационной документации изготовителя;
– использовать провода и кабели с поврежденной или утратившей свои защитные свойства изоляцией;

55

– оставлять без присмотра включенные в электросеть электрические приборы и оборудование, за исключением приборов, эксплуатационными документами на которые допускается их работа без надзора.
После окончания работы все электроустановки в здании (сооружении) необходимо отключать, за исключением дежурного освещения, источников электропитания установок пожарной автоматики, систем оповещения и
управления | эвакуацией, | систем | против | дымной | защиты, | а | также
электроустановок, которые по условиям технологического процесса должны работать круглосуточно [2].
При соблюдении всех перечисленных мер безопасности влияние опасных факторов можно свести минимуму.

56

9 ТРЕБОВАНИЯ К ХРАНЕНИЮ, МАРКИРОВКЕ, УПАКОВКЕ И ТРАНСПОРТИРОВКЕ УСТРОЙСТВ

### 9.1 Требования к хранению

Хранение устройств изготовителем и потребителем в упаковке для транспортирования в складах должно соответствовать условиям хранения по ГОСТ15150-69.
Условия хранения системы обеспечения безопасности котельной жилого дома, в части воздействия климатических факторов, должны соответствовать группе условий хранения 2 по ГОСТ 15150-69:
– место хранения – закрытые помещения с естественной вентиляцией; – температура окружающей среды – от -50 до +40 оС.
Срок хранения усилителя в упаковке изготовителя в условиях хранения 2 по ГОСТ 15150-69 – не более пяти лет.

### 9.2 Требования к маркировке

Маркировка изделия должна соответствовать требованиям ГОСТ 18620-86.
Сведения о блоке содержатся на трех маркировочных табличках, располагаемых на корпусе устройства.
Первая маркировочная табличка, расположенная на лицевой стороне, содержит:
– название устройства;
– товарный знак предприятия-изготовителя;
– надпись: «Зроблена у Беларусi»;
– градуировку диапазона настроек сопротивления изоляции;
– градуировку дополнительной задержки во времени.
Вторая маркировочная табличка, расположенная на левой стороне, содержит:
– название устройства;
– схему электрическую принципиальную;
– товарный знак предприятия-изготовителя;
– наименование предприятия-изготовителя;
– обозначение технических условий.
Третья маркировочная табличка, расположенная спереди, содержит:

57

– название устройства;
– товарный знак предприятия-изготовителя; – дата изготовления;
– максимальный потребляемый ток;
– напряжение питания;
– максимальная потребляемая мощность; – измерительное напряжение;
– максимальный измерительный ток;
– степень защиты – по ГОСТ 14254-80;
– масса;
– заводской номер.
Маркировочные таблички выполнены методом, исключающим потерю надписей в процессе эксплуатации.
После проверки отделом технического контроля предприятия-изготовителя устройство пломбируется.

### 9.3 Требования к упаковке

Упаковка устройства соответствует требованиям ГОСТ 9181-74.
Для упаковывания изделия следует применять потребительскую и транспортную тару.
В качестве потребительской тары должны применяться:
– коробки по ГОСТ 12301-81;
– пачки по ГОСТ 12301-80;
– ящики по ГОСТ 9142-84 (для изделий общей массой свыше 7,5 кг); – коробки из пенополистирола;
– чехлы из полиэтиленовой пленки по ГОСТ 10354-82 или других полимерных пленок, не вызывающих коррозию изделий;
– пакеты из бумаги по ГОСТ 8273-75 или ГОСТ 2228-81;
– ящики металлические.
В качестве транспортной тары должны применяться:
– ящики дощатые типов II, III, V по ГОСТ 2991-85; ящики типа III,
усиленные | двумя | поясными | планками, | следует | применять | для
транспортирования изделий водным путем и при железнодорожных перевозках мелкими отправками;
– ящики фанерные типов II и VI по ГОСТ 5959-80; ящики типа II следует применять только при пересылке почтой;

58

– ящики многооборотные фанерные по ГОСТ 9395-76 и дощатые по ГОСТ 9395-75;
– ящики из гофрированного картона для электроизмерительных приборов по ГОСТ 22852-77;
– ящики деревянные для продукции, поставляемой на экспорт, в том числе и в районы с тропическим климатом, по ГОСТ 24634-81;
– тара на амортизаторах, разработанная для конкретных изделий и согласованная в установленном порядке;
– комбинированные ящики, изготовленные из комбинированных материалов: картона с пенополистирола, резофана и т.п., согласованные в установленном порядке;
– ящики – по ГОСТ 16511-86.
В | качестве | потребительской | тары | применяют | коробки | из
гофрированного картона по ГОСТ 12301-81, а в качестве транспортной тары применяются ящики из гофрированного картона по ГОСТ 22852-77. Упаковывание должно производиться в закрытом помещении с температурой воздуха не ниже 15°С и относительной влажностью до 80%. Упаковка должна обеспечивать сохранность изделия при погрузочно-разгрузочных работах, транспортировании, хранении и необходимую защиту от внешних воздействий.

### 9.4 Требования к транспортировке

Устройства | в | упаковке | предприятия-изготовителя | должны
транспортироваться любым видом закрытого транспорта (железнодорожные вагоны, закрытые автомашины, контейнеры, герметизированные отсеки
самолетов, | трюмы | и | т.д.), | при перевозке | открытым | транспортом
транспортные | ящики | с | изделиями | должны | быть | укрыты
водонепроницаемыми материалами (например, брезентом).
Условия транспортирования в части воздействия климатических факторов внешней среды соответствуют требованиям, установленным ГОСТ 15150-69, для условий хранения 2: температура окружающей среды – от -50 до +60 оС.
Срок транспортирования входит в общий срок хранения блоков.

59

### 10 ПРОЕКТИРОВАНИЕ ПРОГРАММНОГО

ОБЕСПЕЧЕНИЯ

### 10.1 Разработка схемы алгоритма работы системы

Разрабатываемая система обеспечения безопасности котельной жилого дома состоит из программно доступных средств микроконтроллера: переменных, констант, ОЗУ, таймера, а также портов ввода/вывода. Работа системы заключается в считывании данных с датчиков и их обработке на основе написанного алгоритма.
Схема алгоритма работы системы обеспечения безопасности котельной жилого дома представлена на чертеже ГУИР.425158.001 ПД. Код программы приведен в приложении Б.

### 10.2 Описание алгоритма работы системы

Для прототипирования и симуляции работы устройства была выбрана
платформа | Arduino | Uno | [19], | которая | выполнена | на | основе
микроконтроллера ATmega328P. Для обмена данными используются двунаправленные выводы платформы.
Программное обеспечение написано на языке программирования C++ в среде разработки Arduino IDE [20].

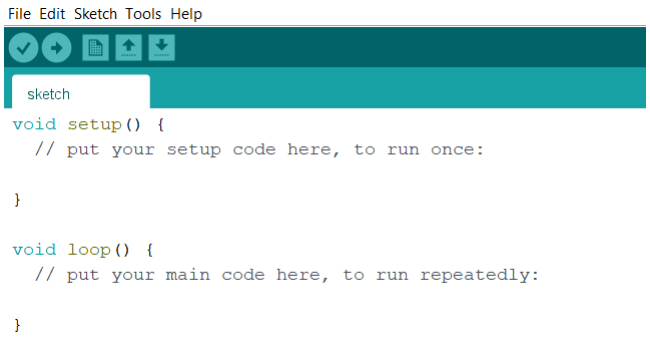
[picture p43: figure]

Рисунок 10.1 – Интерфейс программы Arduino IDE

60

Среда разработки состоит из встроенного текстового редактора программного кода, области сообщений, консоли, панели инструментов и меню.
Код программы состоит из нескольких частей: объявление переменных и констант, настройка работы портов платформы и бесконечный цикл, в котором будут вызываться различные функции для выполнения алгоритма программы.
В результате компиляции исходного кода в среде разработки Arduino IDE подведен анализ аппаратных затрат платформы Arduino Uno:
– скетч использует 13920 байт (43%) памяти устройства из 32256 максимально доступных байт;
– глобальные переменные используют 1092 байта (53%) динамической памяти из 2048 максимально доступных байт.
Исходя из этих данных, можно сделать вывод, что алгоритм занимает только половину предоставляемых ресурсов и, следовательно, программа является легковесной и быстрой, а аппаратная составляющая будет иметь низкое энергопотребление.

61

### 11 МОДЕЛИРОВАНИЕ РАБОТЫ СИСТЕМЫ

### 11.1 Выбор среды моделирования

Моделирование системы обеспечения безопасности котельной жилого дома осуществляется в системе автоматизированного проектирования Proteus [21]. Эта система позволяет виртуально смоделировать работу аналоговых и цифровых устройств.
Proteus | позволяет | собрать | схему | электронного | устройства | и
симулировать его работу, выявляя ошибки, допущенные на стадии разработки. Программа состоит из двух модулей:
– ISIS – редактор электронных схем с последующей имитацией их работы;
– ARES – редактор печатных плат, оснащенный автотрассировщиком Electra, встроенным редактором библиотек и автоматической системой размещения компонентов на плате.
Proteus включает в себя более 6000 электронных компонентов со всеми справочными данными, а также демонстрационные ознакомительные проекты. Кроме того, в Proteus можно добавлять библиотеки элементов и устанавливать дополнительные компиляторы.

### 11.2 Описание процесса моделирования

В | процессе | моделирования | были | использованы | следующие
библиотечные элементы:
1) Arduino Uno (рисунок 11.1) – платформа. Используется для реализации системы.

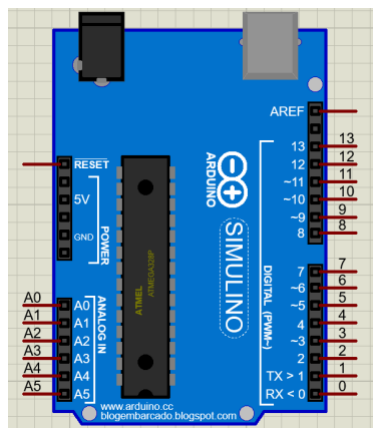
[picture p44: figure]

Рисунок 11.1 – Arduino Uno

62

2) SIM900D (рисунок 11.2) – GSM/GPRS модуль. Необходим для симуляции отправки SMS-сообщений.

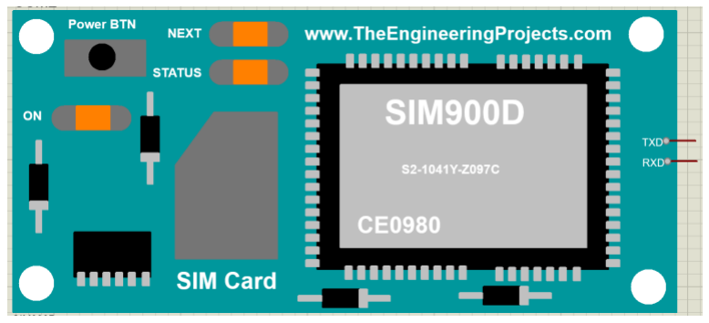
[picture p45: figure]

Рисунок 11.2 – SIM900D

3) LM044L (рисунок 11.3) – LCD дисплей 20 x 4 символов. Используется для отображения информации.

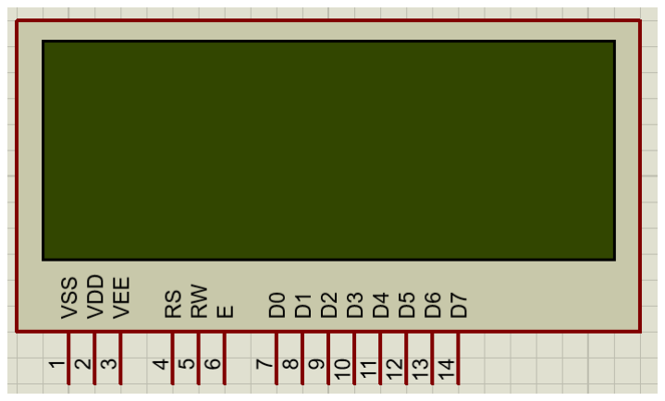
[picture p46: figure]

Рисунок 11.3 – LM044L

4) KEYPAD-PHONE (рисунок 11.4) – матричная клавиатура 3 x 4. Используется для ввода данных.


Рисунок 11.4 – KEYPAD-PHONE

63

5) PCF8574 (рисунок 11.5) – I

2C расширитель портов. Необходим для подключения клавиатуры и LCD дисплея к платформе.

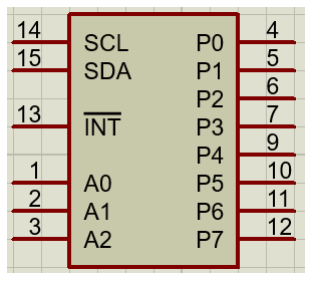
[picture p47: figure]

Рисунок 11.5 – PCF8574

6) FLAME SENSOR (рисунок 11.6) – датчик огня. Необходим для обнаружения возгорания в котельном помещении.

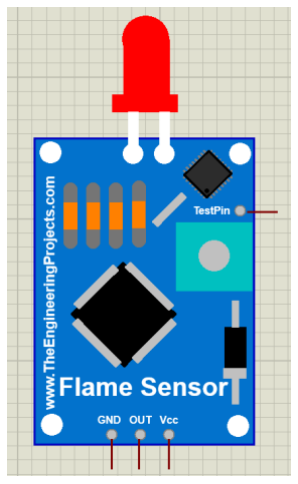
[picture p48: figure]

Рисунок 11.6 – FLAME SENSOR

7) MQ-2 GAS SENSOR (рисунок 11.7) – датчик дыма. Необходим для обнаружения задымления в котельном помещении.

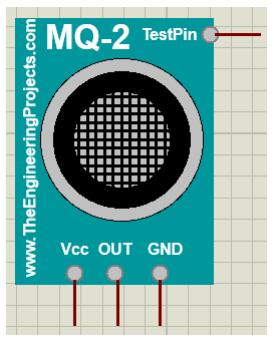
[picture p49: figure]

Рисунок 11.7 – MQ-2 GAS SENSOR

64

8) MQ-3 GAS SENSOR (рисунок 11.8) – выполняет роль симуляции датчика MQ-135 – датчика углекислого газа CO2, т. к. данная модель отсутствует в библиотеке Proteus. Необходим для обнаружения превышения концентрации CO2 в котельном помещении.

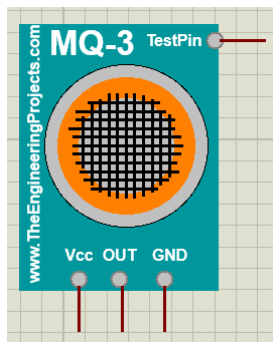
[picture p50: figure]

Рисунок 11.8 – MQ-3 GAS SENSOR

9) MQ-5 GAS SENSOR (рисунок 11.9) – датчик природного газа. Необходим для обнаружения утечки газа в котельном помещении.

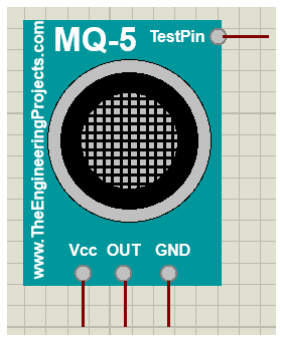
[picture p51: figure]

Рисунок 11.9 – MQ-5 GAS SENSOR

10) MQ-7 GAS SENSOR (рисунок 11.10) – датчик угарного газа CO. Необходим для обнаружения превышения концентрации CO в котельном помещении.

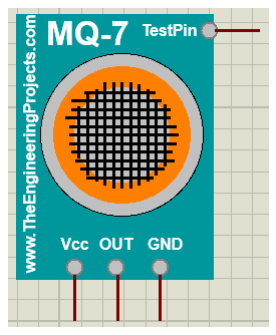
[picture p52: figure]

Рисунок 11.10 – MQ-7 GAS SENSOR

65

11) DHT11 (рисунок 11.11) – датчик температуры и влажности. Необходим для определения текущей температуры и влажности в котельном помещении.

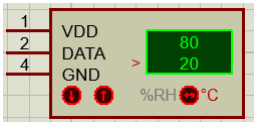
[picture p53: figure]

Рисунок 11.11 – DHT11

12) SOUNDER (рисунок 11.12) – пьезодинамик. Необходим для звуковой сигнализации пользователя.

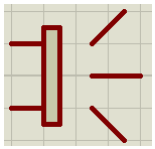
[picture p54: figure]

Рисунок 11.12 – SOUNDER

13) LED (рисунок 11.13) – LED-индикатор. Необходим для визуального отображения статуса котельного помещения.

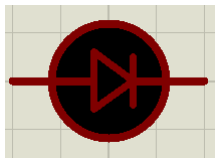
[picture p55: figure]

Рисунок 11.13 – LED

14) RELAY (рисунок 11.14) – реле переключения. Необходимо для включения/отключения электромагнитного клапана для подачи газа в газовый котел.

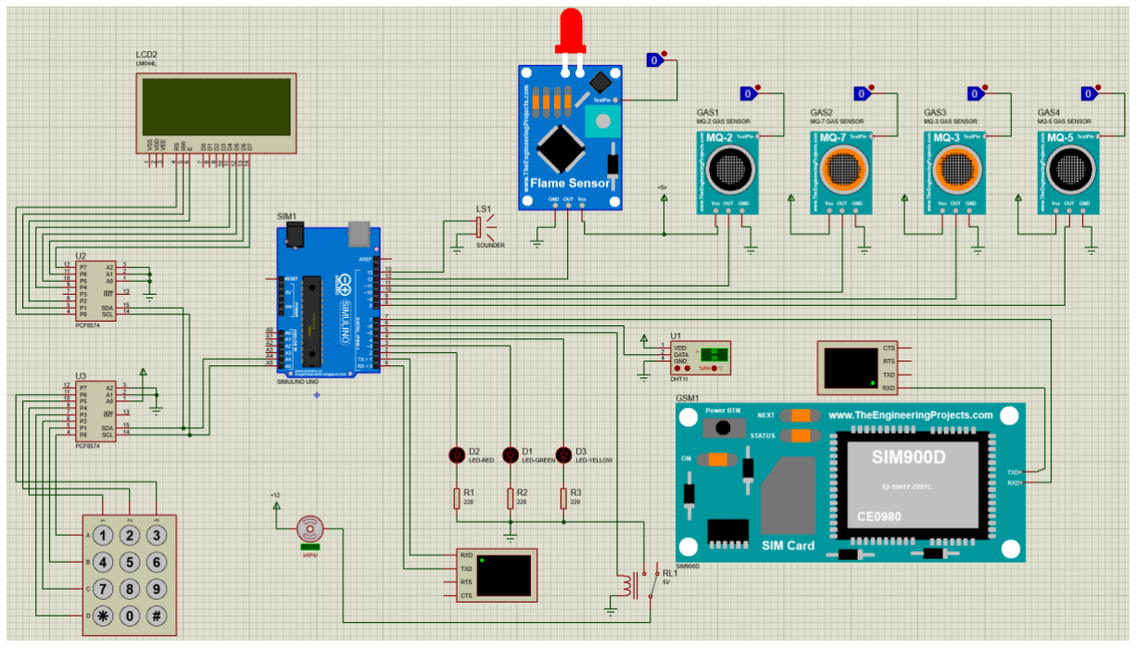
[picture p56: figure]

66

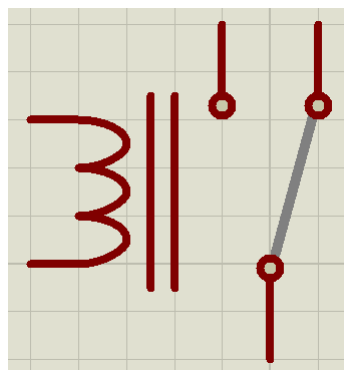
[picture p57: figure]

Рисунок 11.14 – RELAY

15) FAN-DC (рисунок 11.15) – симулирует работу электромагнитного клапана газа.

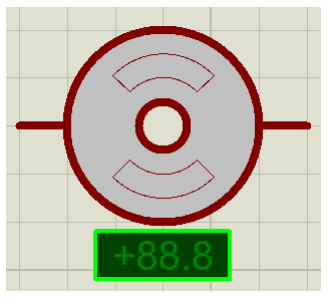
[picture p58: figure]

Рисунок 11.15 – FAN-DC

Итоговая реализация схемы устройства представлена на рисунке 11.16.

Рисунок 11.16 – Реализация схемы устройства в САПР Proteus

67

### 12 ТЕХНИКО-ЭКОНОМИЧЕСКОЕ ОБОСНОВАНИЕ

### 12.1 Характеристика нового изделия

Система обеспечения безопасности котельного помещения жилого дома, которая разрабатывается в данном дипломном проекте, представляет собой набор комплектующих, элементы коммутации и главную печатную плату с предустановленным ПО для работы продукта.
Выдвинуто предположение, что тип производства будет основываться на заказе покупателя и осуществляться в единичном экземпляре. Среди целевой аудитории можно выделить жителей частного дома, коттеджа или дачи, которым необходимо организовать систему обеспечения безопасности для котельного помещения с газовым котлом. Основной функционал системы заключается в возможности мониторинга качества воздуха (наличие угарного газа CO, углекислого газа CO2, дыма и огня), температуры и влажности в котельном помещении. Способ представления информации -отображение на небольшом экране. При обнаружении перечисленных выше газов либо при превышении допустимой температуры предусмотрена функция SMS-оповещения по указанному номеру телефона, а также перекрытие подачи газа в котел. Номер телефона вводится при первом запуске устройства и может быть изменен в любой момент.
По окончанию настройки пользователь получает надежную систему безопасности с базовым набором датчиков газов, которая может быть
расширена | при | помощи | дополнительных | сенсоров. | Основным
преимуществом данного устройства является то, что покупатель получает недорогое специализированное устройство для обеспечения безопасности котельного помещения.
Разработанная система будет дешевле и сопоставима по стоимости с аналогичными устройствами, которые предлагают другие производители, однако она будет иметь больший функционал с возможностью модификации под нужды каждого клиента.

### 12.2 Расчет стоимостной оценки результата

12.2.1 Расчет себестоимости и отпускной цены нового изделия

Рассчитаем затраты по статье «Покупные комплектующие изделия, полуфабрикаты и услуги производственного характера».

68

Таблица 12.1 – Расчет затрат на комплектующие и полуфабрикаты

Наименование комплектующего | Кол-во на единицу, шт. | Цена за ед., р. | Сумма, р.
Микросхема ATmega328P | 1 | 6,70 | 6,70
Микросхема SIM900A | 1 | 30,00 | 30,00
Микросхема MIC29302WT | 1 | 12,00 | 12,00
Микросхема NCP1117ST50T3G | 1 | 0,66 | 0,66
Микросхема MAX232 | 1 | 1,00 | 1,00
Микросхема PCF8574 | 3 | 2,90 | 8,70
Датчик температуры и влажности DHT11 | 1 | 12,50 | 12,50
Датчик дыма MQ-2 | 1 | 12,00 | 12,00
Датчик огня KY-026 | 1 | 10,00 | 10,00
Датчик угарного газа MQ-7 | 1 | 12,00 | 12,00
Датчик углекислого газа MQ-135 | 1 | 15,00 | 15,00
Пьезодинамик CVS-1508 | 1 | 10,00 | 10,00
Плата печатная | 1 | 10,00 | 10,00
LCD-дисплей LCD-20X4B | 1 | 15,00 | 15,00
Светодиод | 3 | 1,35 | 4,05
Клавиатура | 1 | 4,70 | 4,70
Диод SMA4007, 1 А, 1000 В | 1 | 0,13 | 0,13
Конденсатор электролитический 10 мкФ 100 В, 20% | 2 | 0,20 | 0,40
Конденсатор танталовый 10 мкФ 35 В, 10% | 2 | 0,45 | 0,90
Конденсатор электролитический 1 мкФ 100 В, 5% | 5 | 0,09 | 0,45
Конденсатор керамический 33 пФ 50 В, 5% | 2 | 0,12 | 0,24
Конденсатор керамический 1 мкФ 16 В, 10% | 1 | 0,18 | 0,18
Кварцевый резонатор HC-49S, 8 МГц | 1 | 0,42 | 0,42
Клапан электромагнитный Advixon DN 20 | 1 | 40,00 | 40,00
Резистор SMD 0805 22 Ом, 1% | 3 | 0,02 | 0,06
Резистор SMD 0805 510 Ом, 1% | 3 | 0,02 | 0,06
Резистор SMD 0805 4,7 кОм, 1% | 4 | 0,02 | 0,08
Резистор SMD 0805 47 кОм, 1% | 4 | 0,08 | 0,32
Резистор SMD 0805 10 кОм, 1% | 2 | 0,08 | 0,16
Резистор SMD 0805 1 МОм, 1% | 1 | 0,10 | 0,10
Транзистор BC547 45 В, 0,1 А | 5 | 0,21 | 1,05

69

Продолжение таблицы 12.1

Наименование комплектующего | Кол-во на единицу, шт. | Цена за ед., р. | Сумма, р.
Разъем 24-контактный | 1 | 1,00 | 1,00
Разъем 7-контактный | 1 | 0,14 | 0,14
Разъем ADC-029 | 1 | 3,00 | 3,00
Разъем RS-232 | 1 | 3,30 | 3,30
Разъем SIM5051-6-0-18-00-A | 1 | 3,00 | 3,00
Разъем 901-9894-RFX | 1 | 1,50 | 1,50
Реле 507-2CH-F-C 5VDC | 1 | 5,00 | 5,00
Корпус под заказ | 1 | 25,00 | 25,00
Винт М2,5х8 | 4 | 0,02 | 0,08
Винт М2,5х5 | 8 | 0,01 | 0,08
Винт М3х8 | 4 | 0,02 | 0,08
Всего | 83 | | 251,04
Транспортные расходы, р. | | | 10
Итого | | | 261,04
Рассчитаем | затраты | по | статье | «Основная | заработная | плата
производственных рабочих».
Для вычисления основной заработной платы (ЗО) производственных рабочих используется формула:

ЗО = ∑Tчi ∗ ti

| | Ко

i=1

, | (12.1)

где Тчi – часовая тарифная ставка, соответствующая разряду выполняемых по i-й операции работ, р/ч;
ti – норма времени на выполнение работ по i-й операции, ч;
Ко – количество технологических операций при производстве изделия.
Формула | для | вычисления | часовой | тарифной | ставки | (Tч),
соответствующая i-му разряду работ:
Tчi = Tч ∗ КTi , | (12.2)

где Тчi – часовая тарифная ставка первого разряда;

70

КТi – коэффициент разряда работ.
Часовая тарифная ставка рассчитывается путем деления месячной базовой тарифной ставки на среднемесячное количество рабочих часов. Базовая тарифная ставка, действующая на предприятии по состоянию на 01.05.2021, составляет 230 р. Среднемесячное количество расчетных рабочих часов – 176, следовательно, часовая тарифная ставка равна 1,31 р.

Таблица 12.2 – Расчет основной заработной платы производственных рабочих

Вид работ (операции) | Разряд работ | Коэффициент разряда работ | Часовая тарифная ставка, р./ч | Норма времени по операции, ч | Прямая зарплата (расценка), р.
Заготови-тельные | 3 | 1,14 | 1,49 | 2 | 2,98
Установка элементов на печатную плату | 5 | 1,29 | 1,69 | 2 | 3,37
Монтажная | 6 | 1,38 | 1,8 | 3 | 5,41
Контрольная | 9 | 1,68 | 2,2 | 3 | 6,59
Сборочные | 4 | 1,21 | 1,58 | 2 | 3,16
Всего | | | | | 21,51

Дополнительная заработная плата (Зд
) рассчитывается по формуле:

Зд =

Зо ∗ Нд
100 , | (12.3)

где Нд – норматив дополнительной заработной платы, установленный предприятием, который равен 60%.

Зд =

21,51 ∗ 60
100 = 12.91 р .

Рассчитываем накладные расходы (Рн) по формуле:

Рн =

Зо ∗ Нн
100 , | (12.4)

71

где Нн – норматив накладных расходов, который равен 170%.

Рн =

21,51 ∗ 170
100 = 36,57 р .

Отчисления на социальные нужды (Рсоц) рассчитываются по формуле:

Рсоц =

(Зo + Зд) ∗ Hсоц
100 | ,

(12.5)

где Нсоц – норматив отчисления в Фонд социальной защиты населения и обязательного страхования, установленная законодательством (Нсоц = 35%).

Рсоц =

(21,51 + 12,91) ∗ 35
100 | = 12,05 р .

Производственная себестоимость (Спр) вычисляется по формуле:

Спр = Рк + 3о + Зд + Рсоц + Рн , | (12.6)

Спр = 261,04 + 21,51 + 12,91 + 12,05 + 36,57 = 344,07 р .

Коммерческие расходы (Рком) рассчитываются по формуле:

Рком =

Спр ∗ Нком
100 | , | (12.7)

где Нком – норматив коммерческих расходов, который равен 3%.

Рком =

344,07 ∗ 3
100 = 10,32 р .

Полная себестоимость (Cп) рассчитывается по формуле:

Cп = Спр + Рком , | (12.8)

Сп = 344,07 + 10,32 = 354,39 р .

72

Плановая прибыль на единицу продукции (Пед) рассчитывается по формуле:

Пед =

Сп ∗ Нре
100 , | (12.9)

где Нре – норматив рентабельности единицы продукции, который равен 25%.

Пед =

354,39 ∗ 25
100 = 88,6 р .

Отпускная цена (Цотп) равна:

Цотп = Сп + Пед , | (12.10)

Цотп = 354,39 + 88,6 = 442,99 р .

Таблица 12.3 – Расчет себестоимости и отпускной цены единицы продукции

Наименование статьи затрат | Условное обозначение | Значение, р.
Покупные комплектующие | Pк | 261,04
Основная заработная плата производственных рабочих | Зо | 21,51
Дополнительная заработная плата производственных рабочих | Зд | 12,91
Отчисления на социальные нужды | Рсоц | 12,05
Накладные расходы | Рн | 36,57
Производственная себестоимость | Спр | 344,07
Коммерческие расходы | Рком | 10,32
Полная себестоимость | Сп | 354,39
Плановая прибыль на единицу продукции | Пед | 88,60
Отпускная цена | Цотп | 442,99

Подведем результаты расчетов: производственная себестоимость одной единицы продукции составит 344 рубля 7 копеек, полная себестоимость – 354 рубля 39 копеек, отпускная цена – 442 рубля 99 копеек.

73

12.2.2 Расчет чистой прибыли

Проанализировав маркетинговые исследования и заказы потребителей, было установлено количество производимых изделий в первый год равным 150 со средним приростом выпуска в последующие годы на 15%. Размер прироста определен с помощью анализа статистических данных по объему
промышленного | производства | в | Республике | Беларусь | [22]. | Также
учитывались возможные финансовые и производственные риски. Чистая прибыль (Пч) по годам реализации равна:

Пч = N ∗ Пед ∗ (1 −

Нп
| | | 100) , | | | (12.11)

где Нп – ставка налога на прибыль, которая равна 18%. Расчет чистой прибыли за 4 года производства:

Пч1 = 150 ∗ 88,6 ∗ (1 −

18
100) = 10897,54р ,

Пч2 = 173 ∗ 88,6 ∗ (1 −

18
100) = 12532,17 р ,

Пч3 = 198 ∗ 88,6 ∗ (1 −

18
100) = 14411,99 р ,

Пч4 = 228 ∗ 88,6 ∗ (1 −

18
100) = 16573,79 р .

### 12.3 Расчет инвестиций в производство нового изделия

Инвестиции в производство нового изделия включают:
– инвестиции на разработку нового изделия (Иразр);
– инвестиции в основной и оборотный капитал.
Инвестиции в разработку (Ираз) системы обеспечения безопасности котельной жилого дома, согласно смете предприятия, составит:

Ираз = 4493,53 р .

74

Производство продукции будет осуществляться на действующем оборудовании на свободных производственных мощностях, следовательно, инвестиции в основной капитал не требуются.
Для производства нового вида продукции требуется прирост инвестиций в собственный оборотный капитал в размере 15% общей годовой потребности в материальных ресурсах.
Годовая потребность в комплектующих изделиях (Пк) рассчитывается по формуле:
Пк = Рк ∗ N = 261,04 ∗ 150 = 39156 р . | (12.12)

Инвестиции в прирост собственного оборотного капитала (Иоб) вычисляются по формуле:

Иоб = (

15
100) ∗ Пк = 0.15 ∗ 39156 = 5873,4 р . | (12.13)

Инвестиции в собственный оборотный капитал изменяются по годам за счет увеличения производимых устройств на 15% каждый год по сравнению с предыдущим. Из этого следует формула расчета инвестиций в оборотный капитал (при учете прироста собственного оборотного капитала в 15%):

∆Иоб2 = 0,15 ∗ ∆N2 ∗ Рк = 23 ∗ 0,15 ∗ 261,04 = 881,01 р ,

∆Иоб3 = 0,15 ∗ ∆N3 ∗ Рк = 26 ∗ 0,15 ∗ 261,04 = 1013,16 р ,

∆Иоб4 = 0,15 ∗ ∆N4 ∗ Рк = 30 ∗ 0,15 ∗ 261,04 = 1165,14 р .

### 12.4 Расчет показателей экономической эффективности проекта

При оценке эффективности инвестиционных проектов необходимо осуществить приведение затрат и результатов, полученных в разные периоды времени, к расчетному году путем умножения затрат и результатов на коэффициент дисконтирования (a), который определяется следующим образом:

at =

1
(1 + Eн

)

t−tp

, | (12.14)

75

где Eн – требуемая норма дисконта (10-13%);
t – порядковый номер года, затраты и результаты которого приводятся к расчетному году;
tр – расчетный год (в качестве расчетного года принимается год вложения инвестиций, т.е. tр = 1).
Примем ЕН = 11%.

at2 =

1
1 + 0,11 = 0,9009 ,

at3 =

1
(1 + 0,11)

2 = 0,8116 ,

at4 =

1
(1 + 0,11)

3 = 0,7312 .

Расчет чистого дисконтированного дохода за четыре года реализации проекта и срока окупаемости инвестиций представлены в таблице 12.6. Чистый дисконтный доход (ЧДД) вычисляется по формуле:

ЧДДi = Пчi ∗ ati − Иi ∗ ati , | (12.15)

где i – порядковый номер года.
Экономические результаты работы предприятия представлены в таблице 12.4.

Таблица 12.4 – Экономические результаты работы предприятия

Наименование показателей | Обозначение | По годам производства
2021 | 2022 | 2023 | 2024
Результат
Выпуск изделий, шт. | Nt | 150 | 173 | 198 | 228
Чистая прибыль, р. | Пч | 10897,54 | 12532,17 | 14411,99 | 16573,79
Коэффициент дисконта | at | 1 | 0,9009 | 0,8116 | 0,7312
Чистая прибыль с учетом фактора времени, р. | Пчt | 10897,54 | 11290,24 | 11697,10 | 12118,62

76

Продолжение таблицы 12.4

Наименование показателей | Обозначение | По годам производства
2021 | 2022 | 2023 | 2024
Затраты (инвестиции)
Инвестиции в разработку нового изделия, р. | Ираз | 4493,53 | 0 | 0 | 0
Инвестиции в собственный оборотный капитал, р. | Иоб | 5873,40 | 881,01 | 1013,16 | 1165,14
Общая сумма инвестиций, р. | И | 10366,93 | 881,01 | 1013,16 | 1165,14
Инвестиции с учетом фактора времени, р. | Иt | 10366,93 | 793,70 | 822,30 | 851,94
Чистый дисконтный доход по годам, р. | ЧДДt | 530,61 | 10496,54 | 10874,80 | 11266,68
Чистый дисконтный доход с нарастающим итогом, р. | ЧДД | 530,61 | 11027,15 | 21901,95 | 33168,63

Расчет рентабельности инвестиций (РИ) производится по формуле:

РИ =

Пчtср

∑ Иti

n
i=1
∗ 100% , | (12.16)

где Пчtср – средняя чистая прибыль с учетом фактора времени, которая определяется по формуле:

Пчtср =

∑ Пчti

n
i=1
n
, | (12.17)

где Пчti – чистая прибыль, полученная в году с порядковым номер i, р.

77

Пчtср =

10897,54 + 11290,24 + 11697,10 + 12118,62 4

= 11500,88 р ,

РИ =

11500,88
10366,93 + 793,70 + 822,30 + 851,94

∗ 100% = 89,61% .

В результате технико-экономического обоснования инвестиций по производству нового изделия были получены следующие значения показателей их эффективности:
1. Чистый дисконтированный доход за четыре года производства системы обеспечения безопасности котельной жилого дома составит 33168,63 р.
2. Все инвестиции окупятся на конец первого года реализации проекта.
3. Рентабельность инвестиций составит 89,61%.
Таким образом, можно сделать вывод, что производство нового вида изделия является экономически эффективным, а инвестиции в его производство целесообразны.

78

ЗАКЛЮЧЕНИЕ

В ходе выполнения дипломного проекта была разработана система обеспечения безопасности котельной жилого дома в соответствии с заданием. Данная система включает в себя следующий функционал:
– определение наличия опасных газов в помещении (угарный (CO) и углекислый (CO2) газ);
– определение задымления;
– определение возгорания;
– определение превышенной температуры и влажности;
– отображение температуры и влажности на дисплее;
– звуковая и световая сигнализация при обнаружении опасности;
– перекрытие подачи газа;
– SMS-оповещение о чрезвычайной ситуации по номеру телефона.
Во время разработки устройства была выбрана элементная база и
материалы | конструкции, | выбран | метод | конструирования, | оценена
технологичность, разработано программное обеспечение и протестирована работа устройства при помощи САПР Proteus.
По | расчетам | технико-экономического | обоснования | разработки
устройства можно сделать вывод, что производство системы обеспечения безопасности котельной жилого дома на базе микроконтроллера является эффективным.
Таким образом, было разработано цифровое устройство, которое полностью соответствует своим требованиям и может быть использовано в качестве надежной системы обеспечения безопасности котельной жилого дома.

79

СПИСОК ИСПОЛЬЗОВАННЫХ ИСТОЧНИКОВ

[1] Статья про виды систем отопления [Электронный ресурс]. – Режим доступа : https://otoplenie-doma.org/vidy-sistem-otopleniya.html/
[2] | Правила | пожарной | безопасности | Республики | Беларусь
[Электронный ресурс]. – Режим доступа : https://mchs.gov.by/zakonodatelstvo-v-sfere-deyatelnosti-mchs/tnpa/ppb/. (https://mchs.gov.by/zakonodatelstvo-v-sfere-deyatelnosti-mchs/tnpa/ppb)
[3] Atmel Atmega328P [Электронный ресурс]. – Режим доступа : https://ww1.microchip.com/downloads/en/DeviceDoc/Atmel-7810-Automotive-Microcontrollers-ATmega328P_Datasheet/.
[4] Simcom SIM900A [Электронный ресурс]. – Режим доступа : https://components101.com/asset/sites/default/files/component_datasheet/SIM900 A Datasheet/. (https://components101.com/asset/sites/default/files/component_datasheet/SIM900A%20Datasheet/)
[5] ГОСТ 15150-69 Машины, приборы и другие технические изделия. Исполнения для различных климатических районов. Категории, условия
эксплуатации, | хранения | и | транспортирования | в | части | воздействия
климатических факторов внешней среды. – МКС 21.020 Стандартинформ, 2010.
[6] Медведев, А. А. Печатные платы. Конструкции и материалы / А. А. Медведев – М. : Техносфера, 2005. – 304 с.
[7] Базовый принцип конструирования РЭА : справочник / Е. М. Парфенов [и др.]. – М. : Радио и связь, 1981. – 120 с.
[8] Муратов, А. В. Способы обеспечения тепловых режимов РЭC : учебное пособие / А. В. Муратов, Н. В. Ципина. – Воронеж : ГОУВПО “Воронежский государственный технический университет, 2007. – 96 с.
[9] Статья про герметизацию [Электронный ресурс]. – Режим доступа : https://ru.wikipedia.org/wiki/Герметизация/.
[10] Расчёт электромагнитного экрана [Электронный ресурс]. – Режим доступа : https://studizba.com/lectures/129-inzhenerija/1861-konstruirovanie-i-tehnologija-proizvodstva-ktop/36379-23-raschet-jelektromagnitnogo-jekrana.html/. (https://studizba.com/lectures/129-inzhenerija/1861-konstruirovanie-i-tehnologija-proizvodstva-ktop/36379-23-raschet-jelektromagnitnogo-jekrana.html/)
[11] Защита аппаратуры от воздействия помех [Электронный ресурс]. –
Режим | | | | | | | доступа:
https://ozlib.com/945005/tehnika/zaschita_apparatury_vozdeystviya_pomeh/.
[12] Евстафьев, В. В. Основы конструирования и технологии
производства | РЭС | : | учебное | пособие | по | дисциплине | «Основы
конструирования и технологии производства РЭС» / В. В. Евстафьев, И. А.

80

Енгибарян, И. А. Сахаров. ‒ М. : Издательский дом Академии Естествознания, 2016. – 92 с.
[13] ГОСТ 23752-79 Платы печатные общие технические условия. – Издательство стандартов, 1991.
[14] ГОСТ 23751-86 Платы печатные общие параметры конструкции. – Издательство стандартов, 1986.
[15] ГОСТ 10317-79 Платы печатные основные размеры. – Издательство стандартов, 1985.
[16] Кольтюков, Н. А. Основы эргономики и дизайна РЭС : учебное пособие по курсовому проектированию / Н. А. Кольтюков, О.А. Белоусов. – Тамбов : Издательство ФГБОУ ВПО «ТГТУ», 2012. – 124 с.
[17] Статья про САПР AutoCAD [Электронный ресурс]. – Режим доступа : https://ru.wikipedia.org/wiki/AutoCAD/.
[18] Статья про САПР Altium Designer [Электронный ресурс]. – Режим доступа : https://ru.wikipedia.org/wiki/Altium_Designer/.
[19] Статья про Arduino [Электронный ресурс]. – Режим доступа : http://arduino.ru/About/.
[20] Статья про Arduino IDE [Электронный ресурс]. – Режим доступа : https://ru.wikipedia.org/wiki/Arduino_IDE/.
[21] Статья про систему автоматизированного проектирования Proteus
[Электронный | ресурс]. | – | Режим | доступа | :
https://ru.wikipedia.org/wiki/Proteus_Design_Suite/.
[22] Статья про статистические данные по объему промышленного производства в Республике Беларусь [Электронный ресурс]. – Режим доступа
: | https://www.belstat.gov.by/ofitsialnaya-statistika/realny-sector-
ekonomiki/promyshlennost/. (https://www.belstat.gov.by/ofitsialnaya-statistika/realny-sector-ekonomiki/promyshlennost/)

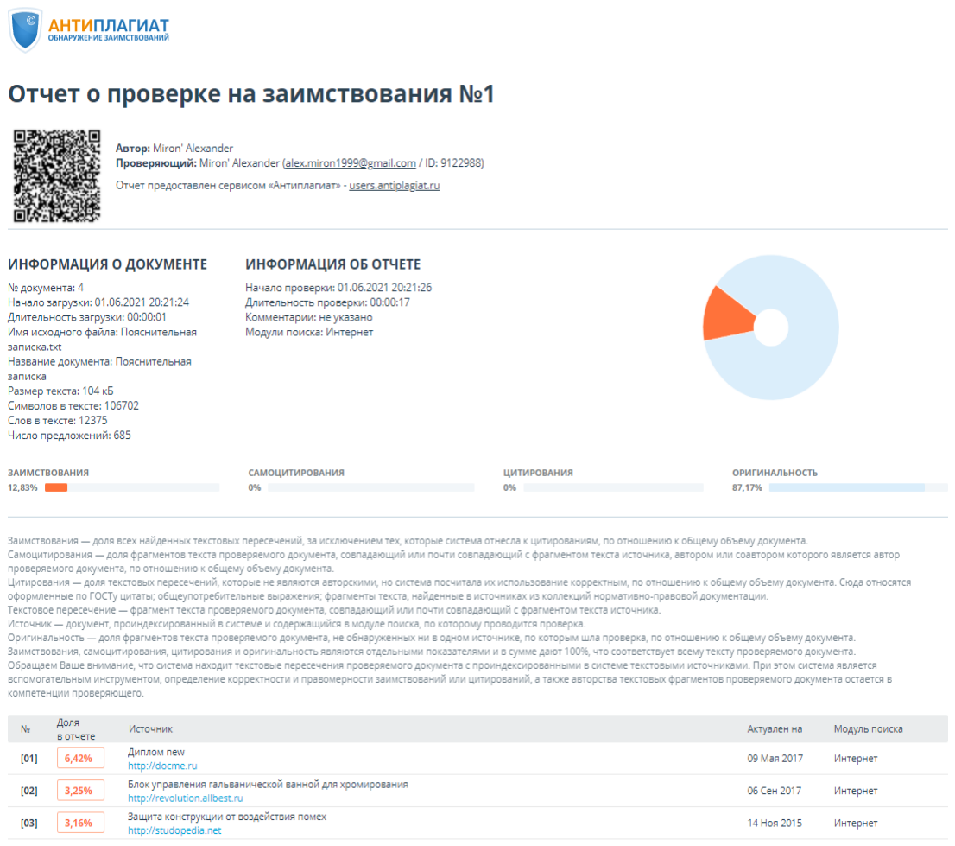
[picture p59: figure]

81

ПРИЛОЖЕНИЕ А
(обязательное)
Отчет о проверке на заимствования

Отчет о проверке представлен на рисунке А.1.

Рисунок А.1 – Отчет о проверке на заимствования

________ Миронь А. В.

82

ПРИЛОЖЕНИЕ Б
(обязательное)
Листинг программы

#include <SoftwareSerial.h> #include <Wire.h>

#include <Keypad.h>

#include <Keypad_I2C.h>

#include <LiquidCrystal_I2C.h> #include "DHT.h"

#define RED_LED_PIN 2

#define GREEN_LED_PIN 3

#define YELLOW_LED_PIN 4

#define DHT_PIN 6

#define DHT_TYPE DHT11

#define RELAY_PIN 5

#define MQ5_SENSOR_PIN 8

#define MQ135_SENSOR_PIN 9 #define MQ7_SENSOR_PIN 10

#define MQ2_SENSOR_PIN 11

#define FLAME_SENSOR_PIN 12 #define SOUNDER_PIN 13

#define RX_PIN 22

#define TX_PIN 7

#define LCD_I2C_ADRESS 0x20 #define KEYPAD_I2C_ADDRESS 0x21

const byte ROWS = 4;
const byte COLUMNS = 3;

const byte LCD_ROWS_AMOUNT = 4; const byte LCD_COLUMNS_AMOUNT = 20;

const byte HUMIDITY_MAX_BORDER = 85;
const byte TEMPERATURE_MAX_BORDER = 50;

const char KEYBOARD_KEYS[ROWS][COLUMNS] = { {'1', '2', '3'},
{'4', '5', '6'},
{'7', '8', '9'},
{'*', '0', '#'}
};

83

const byte ROW_PINS[ROWS] = {0, 1, 2, 3}; const byte COLUMN_PINS[COLUMNS] = {4, 5, 6};

enum SystemStatus {
CO,
CO_2,
SMOKE,
FLAME,
GAS,
HIGH_TEMPERATURE,
HUMIDITY,
OK
};

const SoftwareSerial gsmSerial(RX_PIN, TX_PIN);
const DHT dht(DHT_PIN, DHT_TYPE);
const LiquidCrystal_I2C lcd(LCD_I2C_ADRESS, LCD_COLUMNS_AMOUNT, LCD_ROWS_AMOUNT);
const Keypad_I2C keypad(makeKeymap(KEYBOARD_KEYS), ROW_PINS, COLUMN_PINS, ROWS, COLUMNS, KEYPAD_I2C_ADDRESS);

boolean isDeviceConfigured;
boolean isSmsSent;
byte flameValue;
byte gasValue;
byte smokeValue;
byte coValue;
byte co2Value;
byte temperature;
byte humidity;
String mobileNumber = "+"; SystemStatus systemStatus = OK;

void setup() {
Serial.begin(9600);

initPins();
initGsm();
initDhtSensor();
initLcd();
initKeypad();
}

void initPins() {
pinMode(FLAME_SENSOR_PIN, INPUT);

84

pinMode(MQ2_SENSOR_PIN, INPUT); pinMode(MQ5_SENSOR_PIN, INPUT); pinMode(MQ7_SENSOR_PIN, INPUT); pinMode(MQ135_SENSOR_PIN, INPUT); pinMode(DHT_PIN, INPUT);

pinMode(RED_LED_PIN, OUTPUT); pinMode(GREEN_LED_PIN, OUTPUT); pinMode(YELLOW_LED_PIN, OUTPUT); pinMode(SOUNDER_PIN, OUTPUT); pinMode(RELAY_PIN, OUTPUT);
}

void initGsm() {
gsmSerial.begin(9600);
gsmSerial.println("AT");
}

void initDhtSensor() {
dht.begin();
}

void initLcd() {
lcd.init();
lcd.backlight();
}

void initKeypad() {
keypad.begin(makeKeymap(KEYBOARD_KEYS)); }

void loop() {
if (!isDeviceConfigured) { configureDevice();
} else {
execute();
}
}

void configureDevice() {
printOnLcd(7, 1, "Welcome!"); delay(1000);

enterMobileNumber();

85

isDeviceConfigured = true; }

void enterMobileNumber() {
lcd.clear();
printOnLcd(2, 0, "Enter your mobile"); printOnLcd(6, 1, "number:"); printOnLcd(0, 2, "+");
lcd.setCursor(1, 2);

char key = NO_KEY;
while (key == NO_KEY || key != '#') { key = keypad.getKey();
if (key != NO_KEY && key != '#') { mobileNumber += key;
lcd.print(key);
}
}

lcd.clear();
printOnLcd(4, 0, "Mobile Number"); printOnLcd(4, 1, mobileNumber); printOnLcd(6, 2, "is saved"); printOnLcd(4, 3, "successfully!");

delay(1000);
}

void execute() {
readSensors();

if (isDangerousSituation()) { processDangerousSituation(); } else if (isWet()) {
processWetSituation();
} else {
processOkSituation();
}

delay(1000);
}

void readSensors() {
smokeValue = digitalRead(MQ2_SENSOR_PIN); coValue = digitalRead(MQ7_SENSOR_PIN);

86

co2Value = digitalRead(MQ135_SENSOR_PIN); gasValue = digitalRead(MQ5_SENSOR_PIN); flameValue = digitalRead(FLAME_SENSOR_PIN); humidity = dht.readHumidity();
temperature = dht.readTemperature();
}

void displaySensorsInformation() {
lcd.clear();
printOnLcd(0, 0, "Humidity: " + String(humidity) + "%"); printOnLcd(0, 1, "Temperature: " + String(temperature) + (char) 223 + "C");
}

boolean isDangerousSituation() {
return isGas() || isSmoke() || isFlame() || isCo() || isCo2() || isHighTemperature();
}

boolean isGas() {
if (gasValue == HIGH) {
systemStatus = GAS;
return true;
}
return false;
}

boolean isSmoke() {
if (smokeValue == HIGH) {
systemStatus = SMOKE;
return true;
}
return false;
}

boolean isFlame() {
if (flameValue == HIGH) {
systemStatus = FLAME;
return true;
}
return false;
}

boolean isCo() {
if (coValue == HIGH) {

87

systemStatus = CO;
return true;
}
return false;
}

boolean isCo2() {
if (co2Value == HIGH) {
systemStatus = CO_2;
return true;
}
return false;
}

boolean isHighTemperature() {
if (temperature > TEMPERATURE_MAX_BORDER) { systemStatus = HIGH_TEMPERATURE;
return true;
}
return false;
}

boolean isWet() {
return humidity > HUMIDITY_MAX_BORDER;
}

void printOnLcd(int column, int row, String text) { lcd.setCursor(column, row);
lcd.print(text);
}

void processWetSituation() { digitalWrite(YELLOW_LED_PIN, HIGH); digitalWrite(GREEN_LED_PIN, LOW); digitalWrite(RED_LED_PIN, LOW); digitalWrite(SOUNDER_PIN, LOW); digitalWrite(RELAY_PIN, LOW);
}

void processDangerousSituation() { digitalWrite(RED_LED_PIN, HIGH); digitalWrite(SOUNDER_PIN, HIGH); digitalWrite(GREEN_LED_PIN, LOW); digitalWrite(YELLOW_LED_PIN, LOW); digitalWrite(RELAY_PIN, HIGH);

88

switch (systemStatus) {
case GAS:
displayGasWarningMessage(); break;
case CO:
displayCoWarningMessage(); break;
case CO_2:
displayCo2WarningMessage(); break;
case SMOKE:
displaySmokeWarningMessage(); break;
case FLAME:
displayFlameWarningMessage();
break;
case HIGH_TEMPERATURE:
displayHighTemperatureWarningMessage(); break;
}

sendWarningMessage();
}

void displayGasWarningMessage() { lcd.clear();
printOnLcd(7, 0, "WARNING!"); printOnLcd(2, 1, "Gas is detected!"); printOnLcd(2, 2, "SMS notification"); printOnLcd(7, 3, "is sent.");
}

void displayCoWarningMessage() { lcd.clear();
printOnLcd(7, 0, "WARNING!"); printOnLcd(3, 1, "CO is detected!"); printOnLcd(2, 2, "SMS notification"); printOnLcd(7, 3, "is sent.");
}

void displayCo2WarningMessage() { lcd.clear();
printOnLcd(7, 0, "WARNING!"); printOnLcd(2, 1, "CO2 is detected!");

89

printOnLcd(2, 2, "SMS notification"); printOnLcd(7, 3, "is sent.");
}

void displaySmokeWarningMessage() { lcd.clear();
printOnLcd(7, 0, "WARNING!"); printOnLcd(1, 1, "Smoke is detected!"); printOnLcd(2, 2, "SMS notification"); printOnLcd(7, 3, "is sent.");
}

void displayFlameWarningMessage() { lcd.clear();
printOnLcd(7, 0, "WARNING!"); printOnLcd(1, 1, "Flame is detected!"); printOnLcd(2, 2, "SMS notification"); printOnLcd(7, 3, "is sent.");
}

void displayHighTemperatureWarningMessage() { lcd.clear();
printOnLcd(7, 0, "WARNING!"); printOnLcd(2, 1, "High temperature!"); printOnLcd(2, 2, "SMS notification"); printOnLcd(7, 3, "is sent.");
}

void processOkSituation() { digitalWrite(RED_LED_PIN, LOW); digitalWrite(SOUNDER_PIN, LOW); digitalWrite(YELLOW_LED_PIN, LOW); digitalWrite(GREEN_LED_PIN, HIGH); digitalWrite(RELAY_PIN, LOW);

displaySensorsInformation();

systemStatus = OK;
isSmsSent = false;
}

void sendWarningMessage() { if (!isSmsSent) {
switch (systemStatus) {
case GAS:

90

sendGasWarningMessage();
break;
case CO:
sendCoWarningMessage();
break;
case CO_2:
sendCo2WarningMessage();
break;
case SMOKE:
sendSmokeWarningMessage(); break;
case FLAME:
sendFlameWarningMessage();
break;
case HIGH_TEMPERATURE:
sendHighTempertureWarningMessage(); break;
}

isSmsSent = true;
}
}

void sendGasWarningMessage() { gsmSerial.println("AT+CMGF=1"); gsmSerial.println("AT+CMGS=\"" + mobileNumber + "\"\r"); gsmSerial.println("Warning! Gas is detected!"); gsmSerial.println((char) 26);
}

void sendCoWarningMessage() { gsmSerial.println("AT+CMGF=1"); gsmSerial.println("AT+CMGS=\"" + mobileNumber + "\"\r"); gsmSerial.println("Warning! CO is detected!"); gsmSerial.println((char) 26);
}

void sendCo2WarningMessage() { gsmSerial.println("AT+CMGF=1"); gsmSerial.println("AT+CMGS=\"" + mobileNumber + "\"\r"); gsmSerial.println("Warning! CO2 is detected!"); gsmSerial.println((char) 26);
}

91

void sendFlameWarningMessage() { gsmSerial.println("AT+CMGF=1"); gsmSerial.println("AT+CMGS=\"" + mobileNumber + "\"\r"); gsmSerial.println("Warning! Flame is detected!"); gsmSerial.println((char) 26);
}

void sendSmokeWarningMessage() { gsmSerial.println("AT+CMGF=1"); gsmSerial.println("AT+CMGS=\"" + mobileNumber + "\"\r"); gsmSerial.println("Warning! Smoke is detected!"); gsmSerial.println((char) 26);
}

void sendHighTempertureWarningMessage() { gsmSerial.println("AT+CMGF=1"); gsmSerial.println("AT+CMGS=\"" + mobileNumber + "\"\r"); gsmSerial.println("Warning! High temperature (" + String(temperature) + "C)!");
gsmSerial.println((char) 26);
}
