SN4NTR/ArduinoSecuritySystem/Altium/picturemessage_213rpurb.sml.png

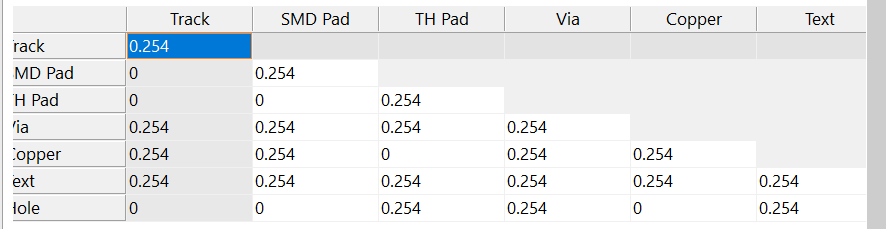
Altium/picturemessage_213rpurb.sml.png
