SN4NTR/ArduinoSecuritySystem/Docs/Board Assistant Config.png

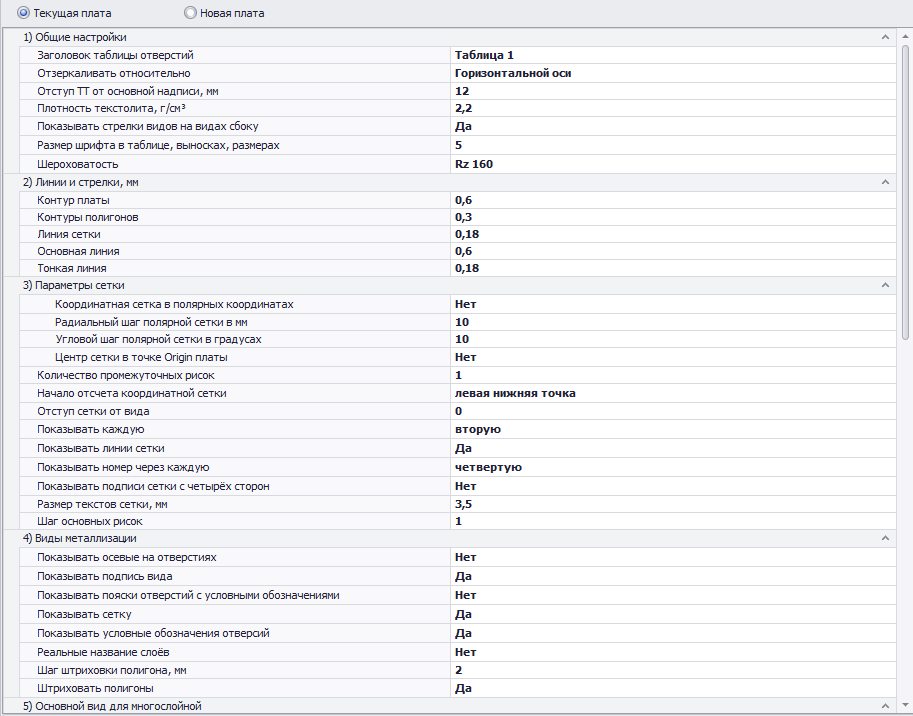
Docs/Board Assistant Config.png
