SN4NTR/ArduinoSecuritySystem/Docs/Power.png

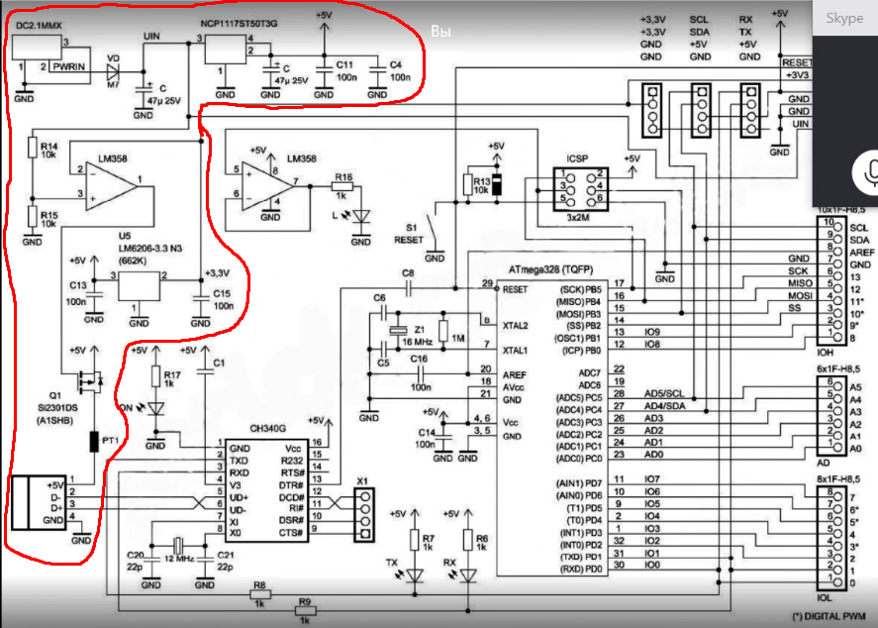
Docs/Power.png
