SN4NTR/ArduinoSecuritySystem/Docs/Schema.png

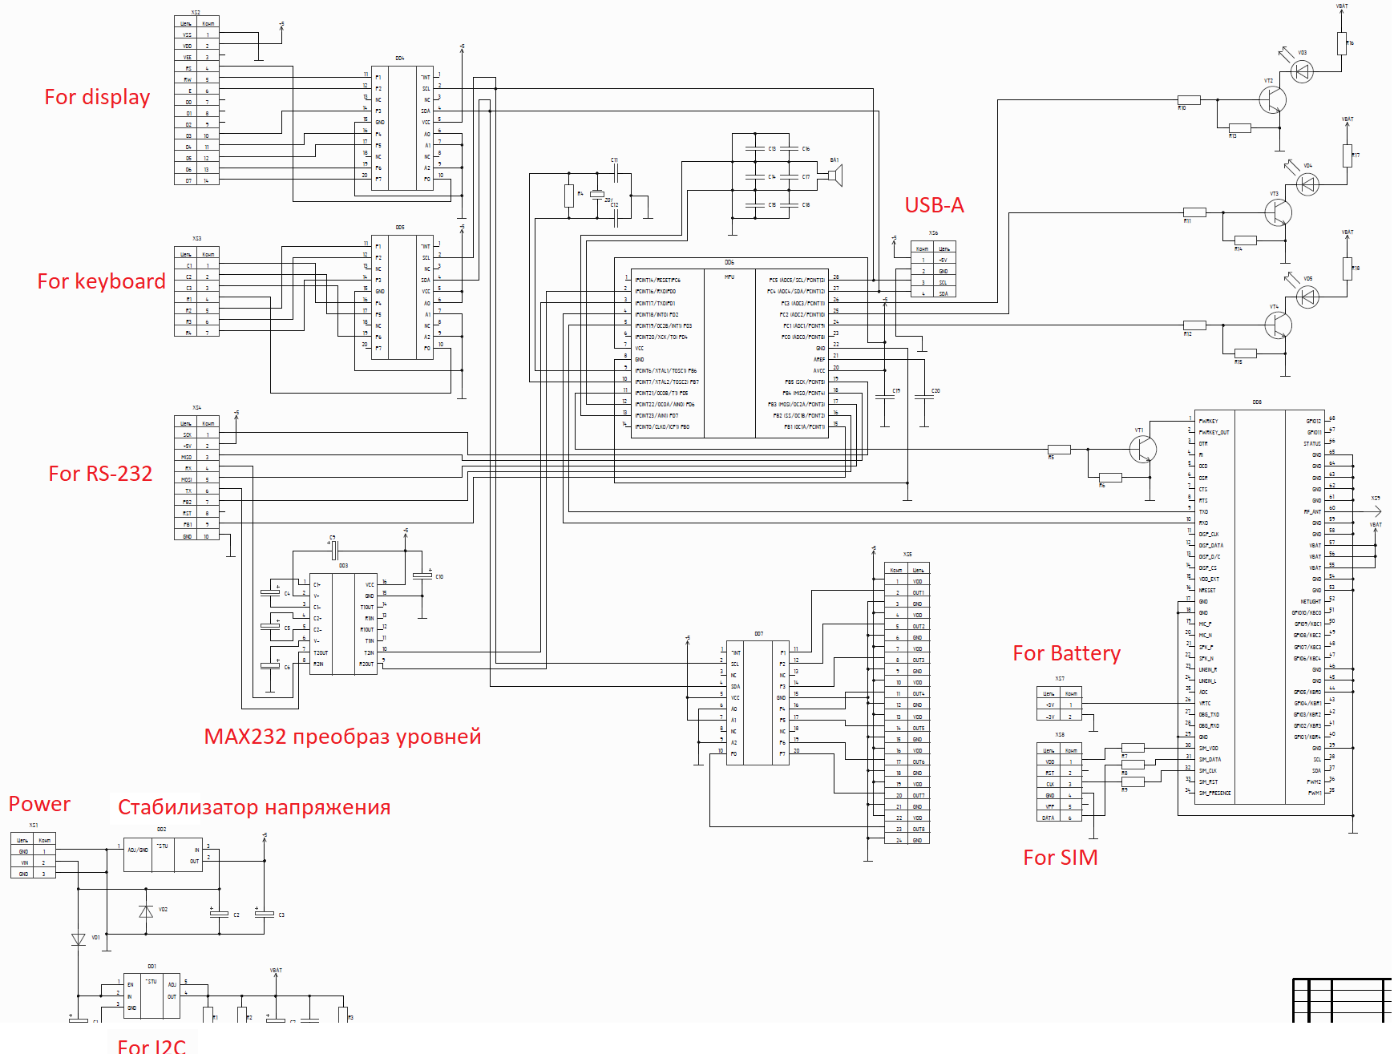
Docs/Schema.png
