SN4NTR/ArduinoSecuritySystem/Altium/Project/AltiumDesigner/2021-05-09_11-47-01/28P3_ATM.step

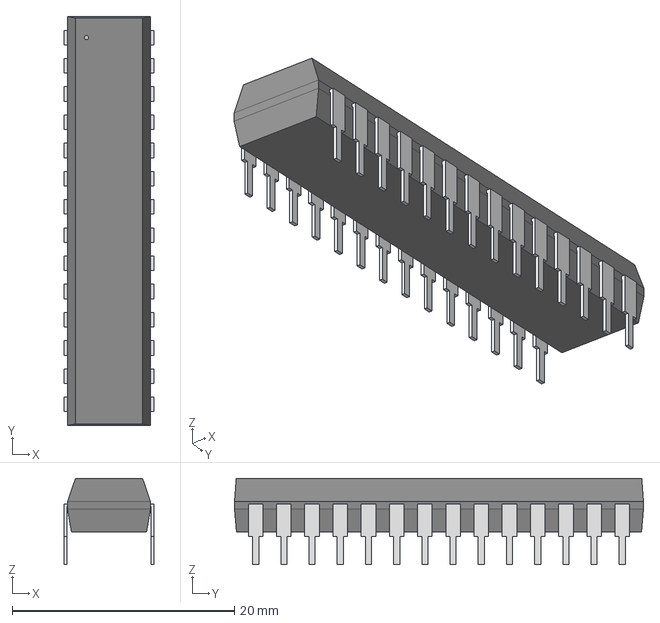
[picture p64: CAD file, 2021-05-11]
Altium/Project/AltiumDesigner/2021-05-09_11-47-01/28P3_ATM.step
8.12 x 36.8 x 7.75 mm
