SN4NTR/ArduinoSecuritySystem/(list of files, cad)

Other CAD files:
Autocad/Draftman 2.dxf
Autocad/Корпус 3.dwg
Autocad/PCB2.dxf
Autocad/Принципиальная схема.dwg
Autocad/Draftman.dxf
Autocad/All Sheets.dwg
Autocad/Рамка формата А1 горизонтальная и вертикальная autocad.dwg
Autocad/Корпус.dwg
Autocad/PCB1.DWG
Autocad/Сборочный устройства.dwg
Autocad/Чертеж Печатной Платы.DWG
Autocad/Структурная схема.dwg
Autocad/Корпус 3.dwg.idw
Autocad/Корпус.dwg.idw
