SN4NTR/ArduinoSecuritySystem/Autocad/PCB2.PcbDoc.pdf

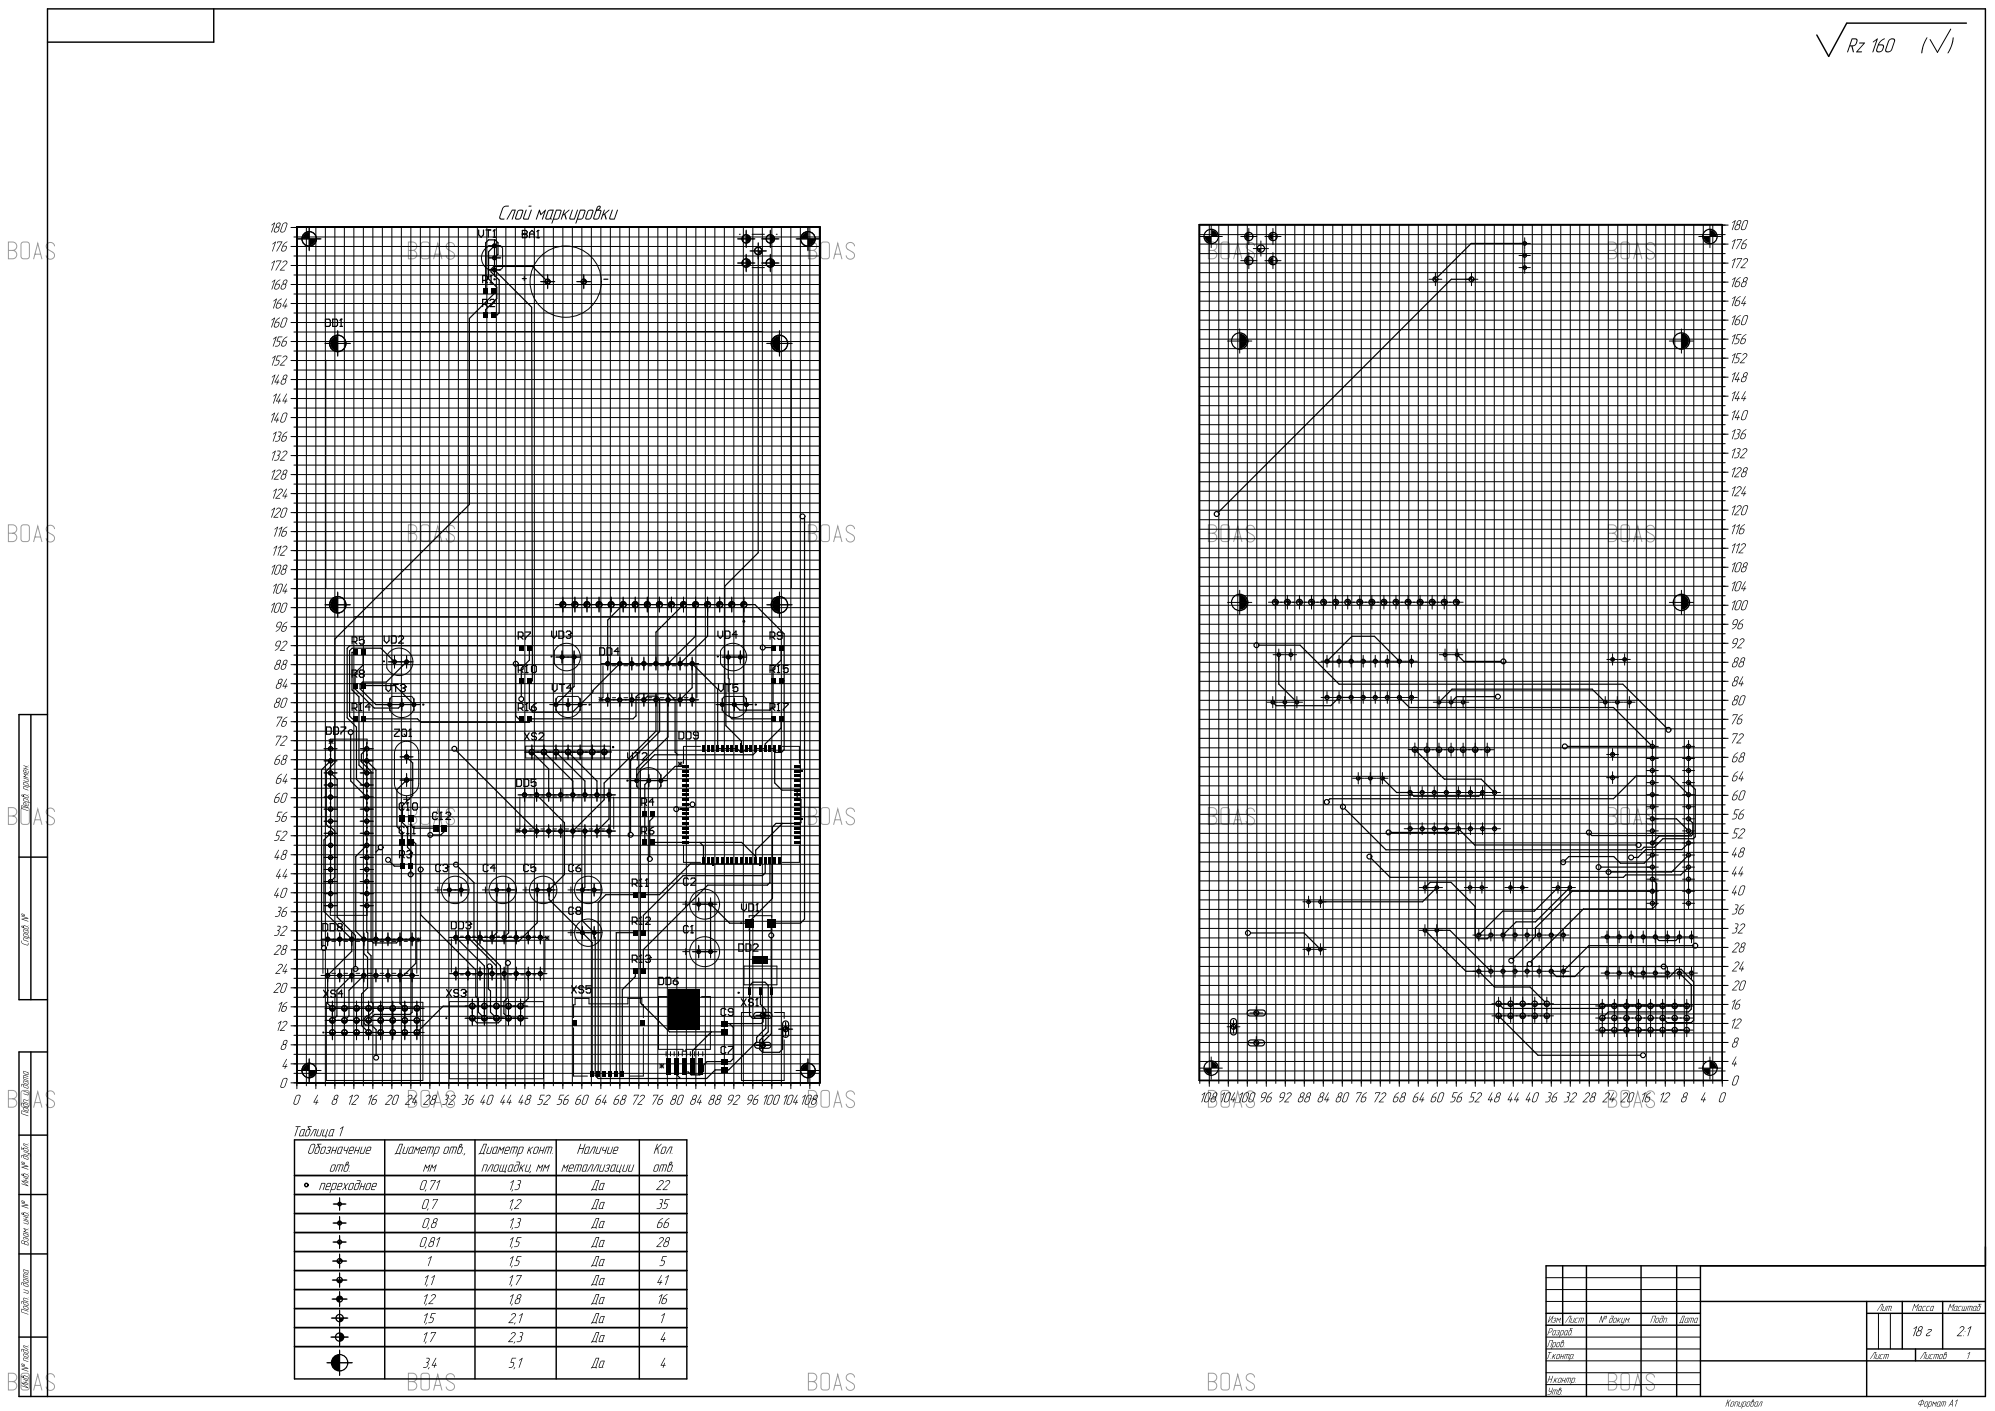
[picture p66: page 1]
COZBOAS488181062; COZBOAS492182007; COZBOAS1988182047
