SN4NTR/ArduinoSecuritySystem/Final/New Plots/Штамп для плаката.pdf

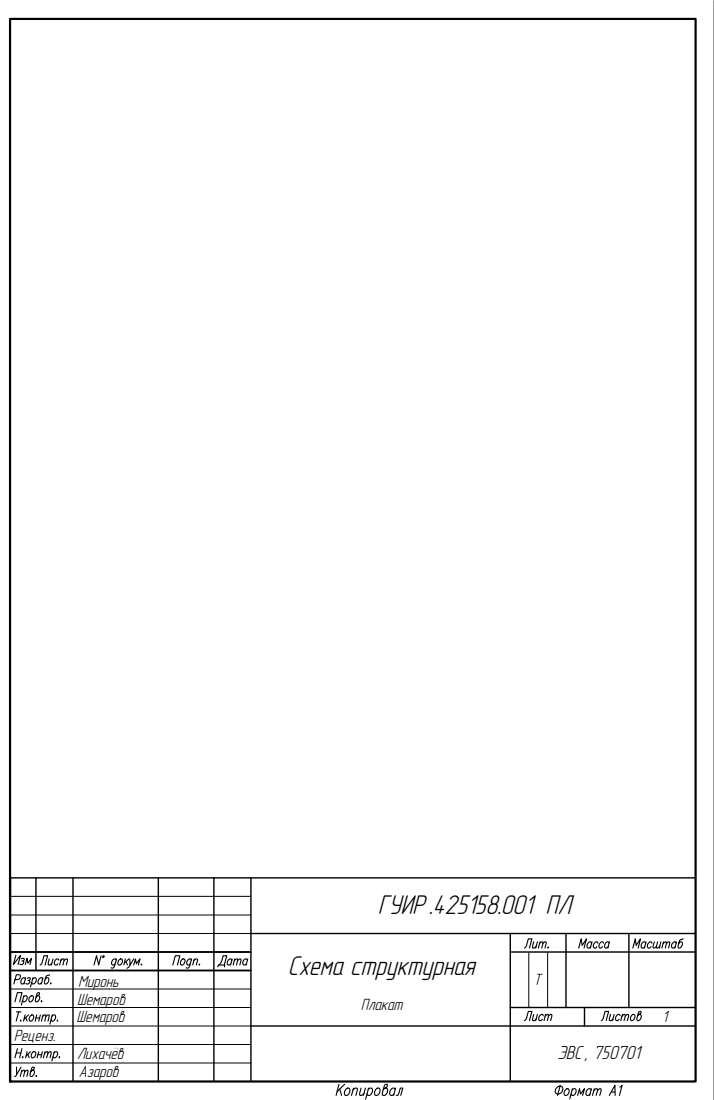
[picture p67: page 1]

ГУИР .425158.001 ПЛ

Схема структурная Плакат

Миронь
Шемаров
Шемаров | | 1

Реценз. | | ЭВС, 750701

Лихачёв
Азаров
