SN4NTR/ArduinoSecuritySystem/Final/Plots/Лицевая панель.pdf

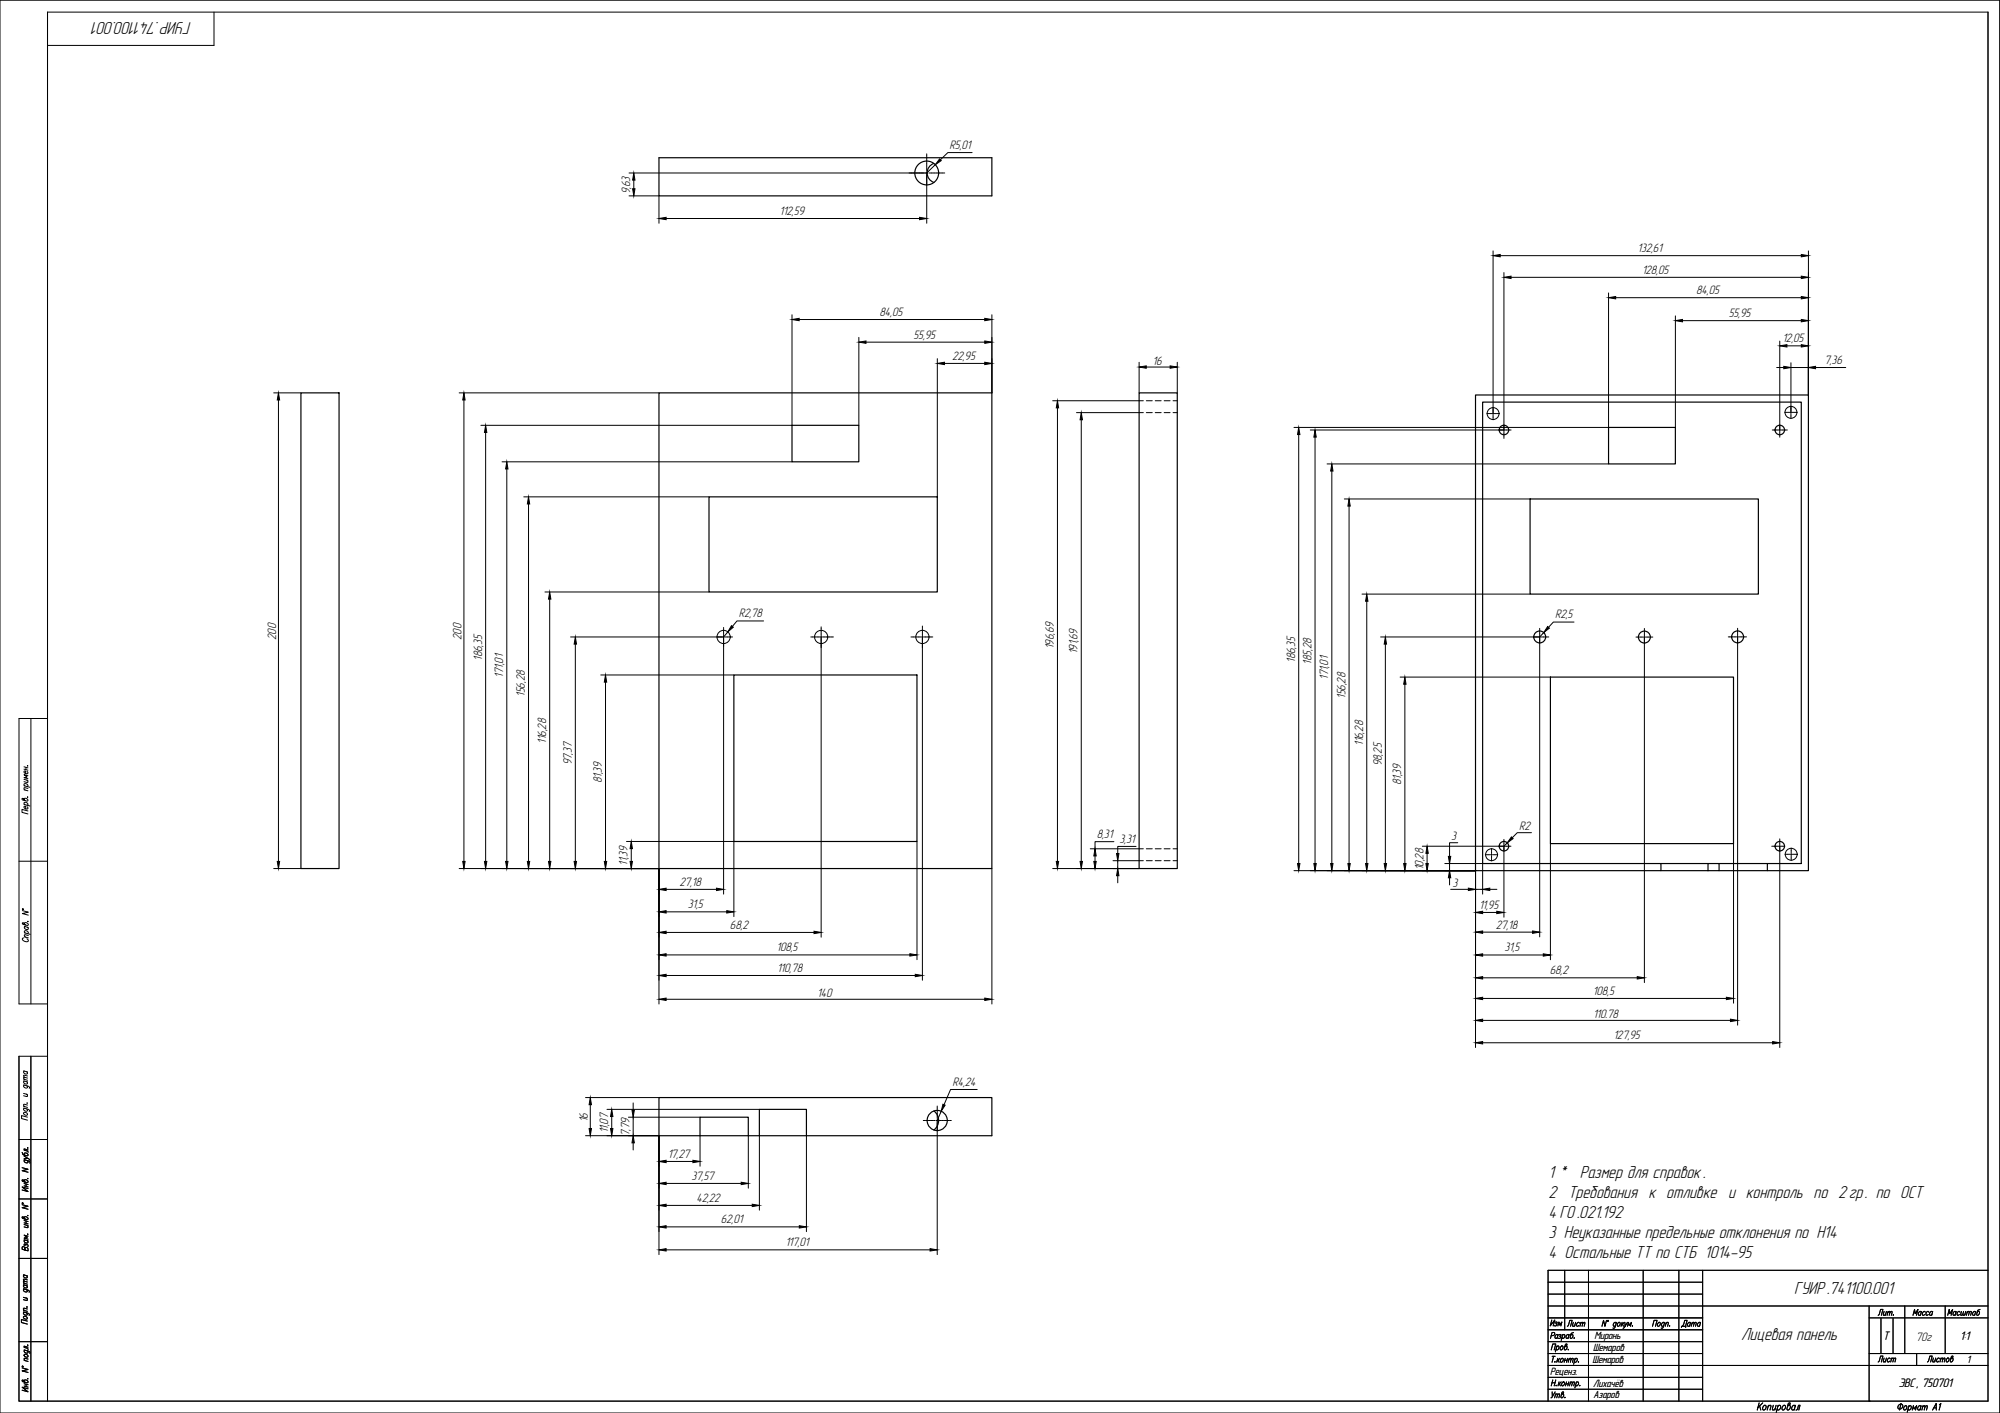
[picture p68: page 1]

1 * Размер для справок. 2 Требования к отливке и контроль по 2 гр. по ОСТ

3 Неуказанные предельные отклонения по H14
4 Остальные ТТ по СТБ 1014-95

ГУИР .741100.001

Миронь
Шемаров
Шемаров | | 1 1

Лицевая панель

Реценз. | | ЭВС, 750701

Лихачёв
Азаров
