SN4NTR/ArduinoSecuritySystem/Final/Plots/Нижняя крышка.pdf

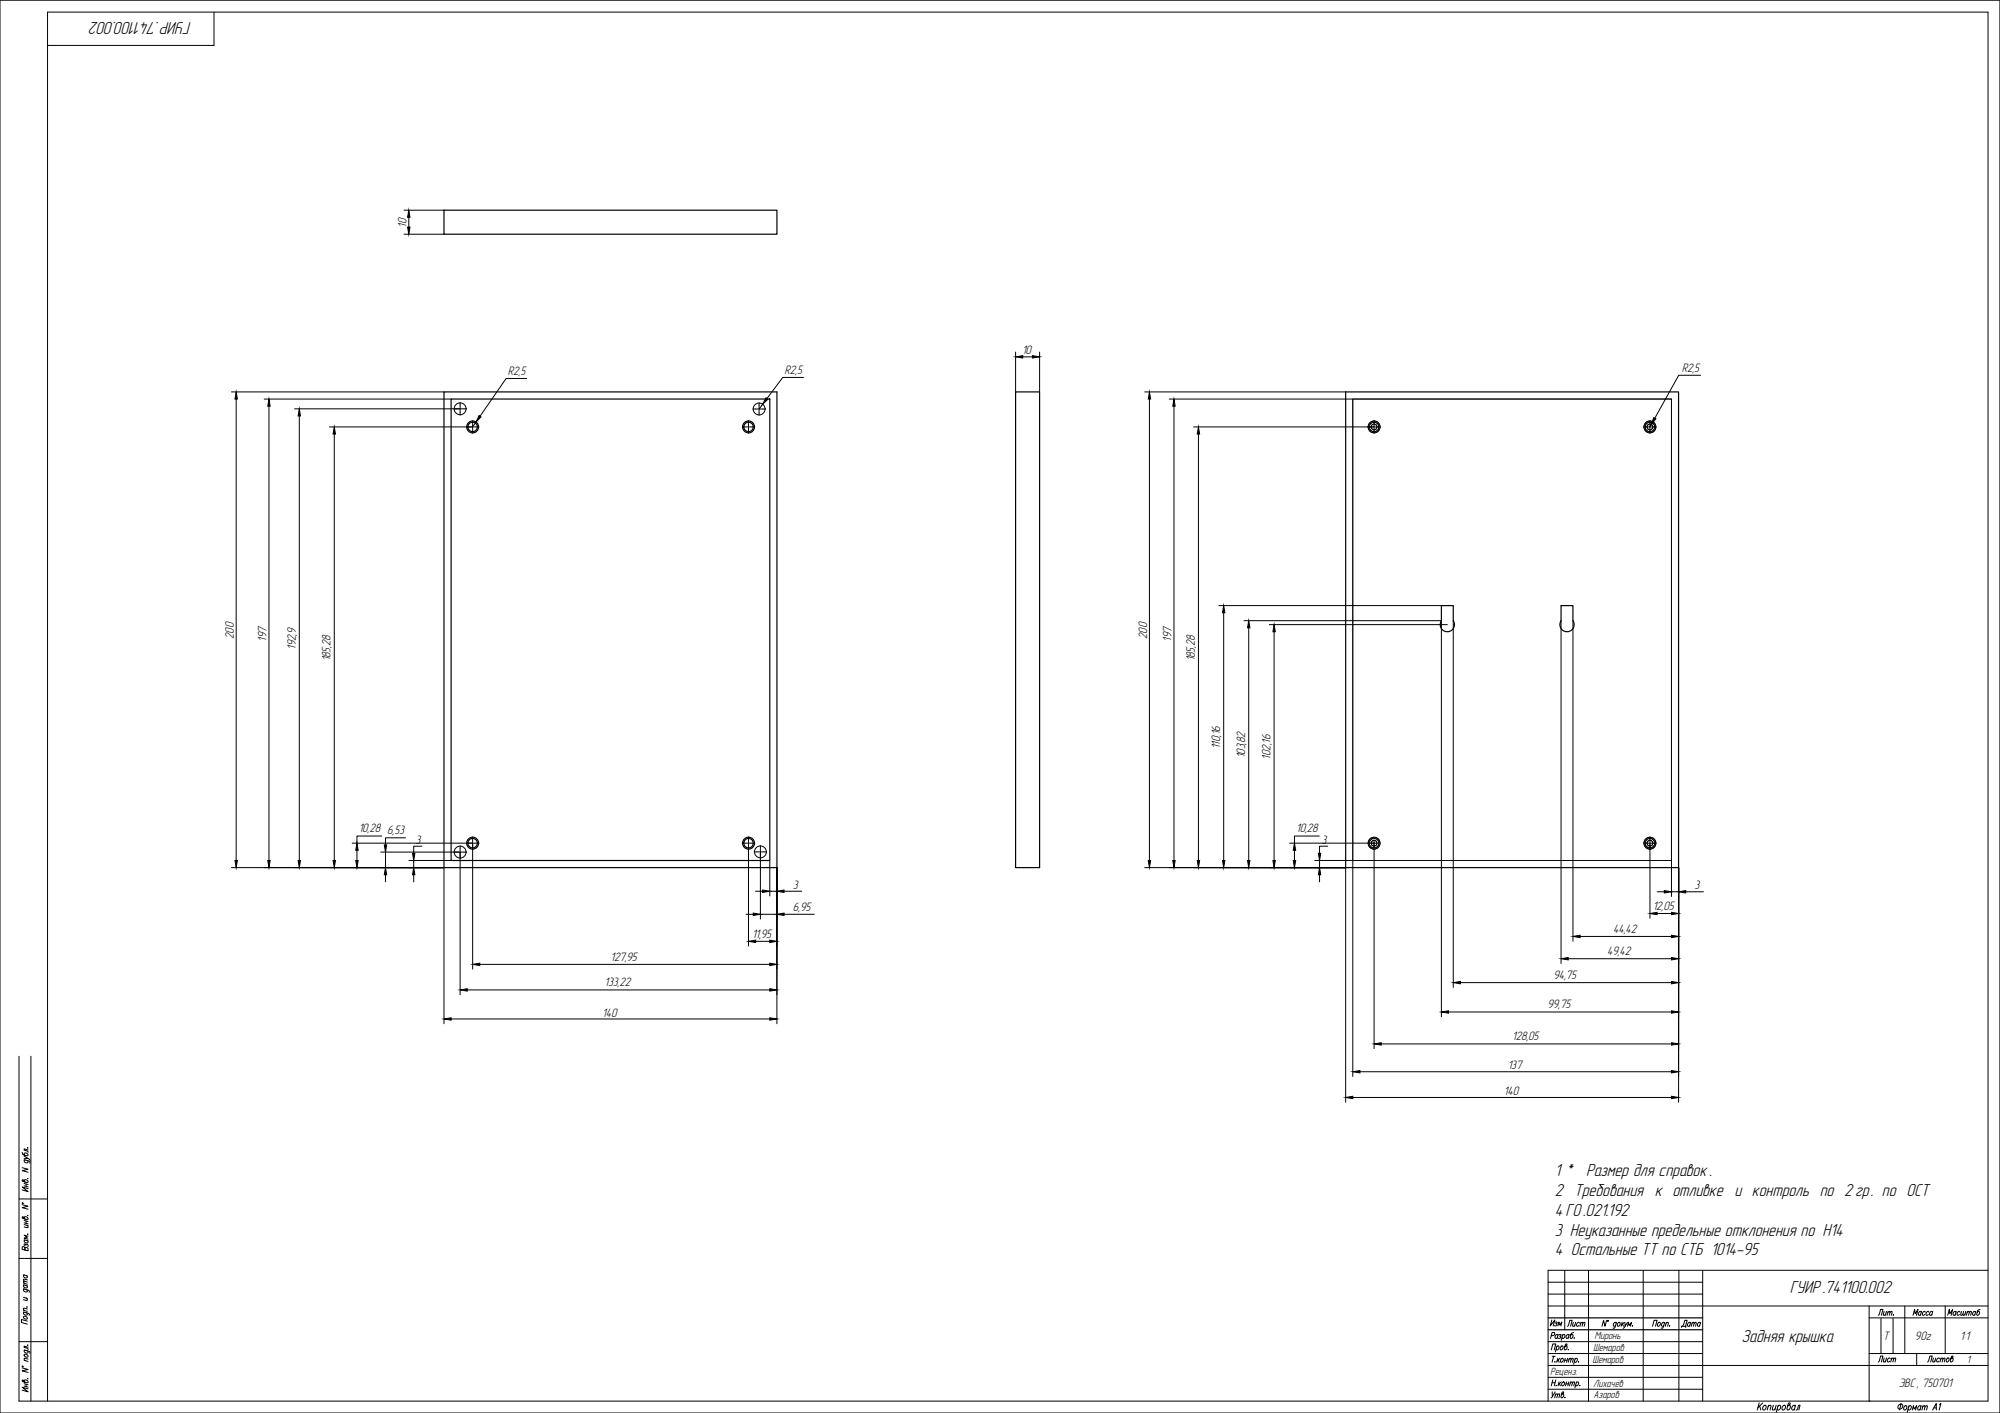
[picture p69: page 1]

1 * Размер для справок. 2 Требования к отливке и контроль по 2 гр. по ОСТ

3 Неуказанные предельные отклонения по H14
4 Остальные ТТ по СТБ 1014-95

ГУИР .741100.002

Миронь
Шемаров
Шемаров | | 1

Задняя крышка

Реценз. | | ЭВС, 750701

Лихачёв
Азаров
