SN4NTR/ArduinoSecuritySystem/Final/Plots/Сборочный чертеж печатной платы.pdf

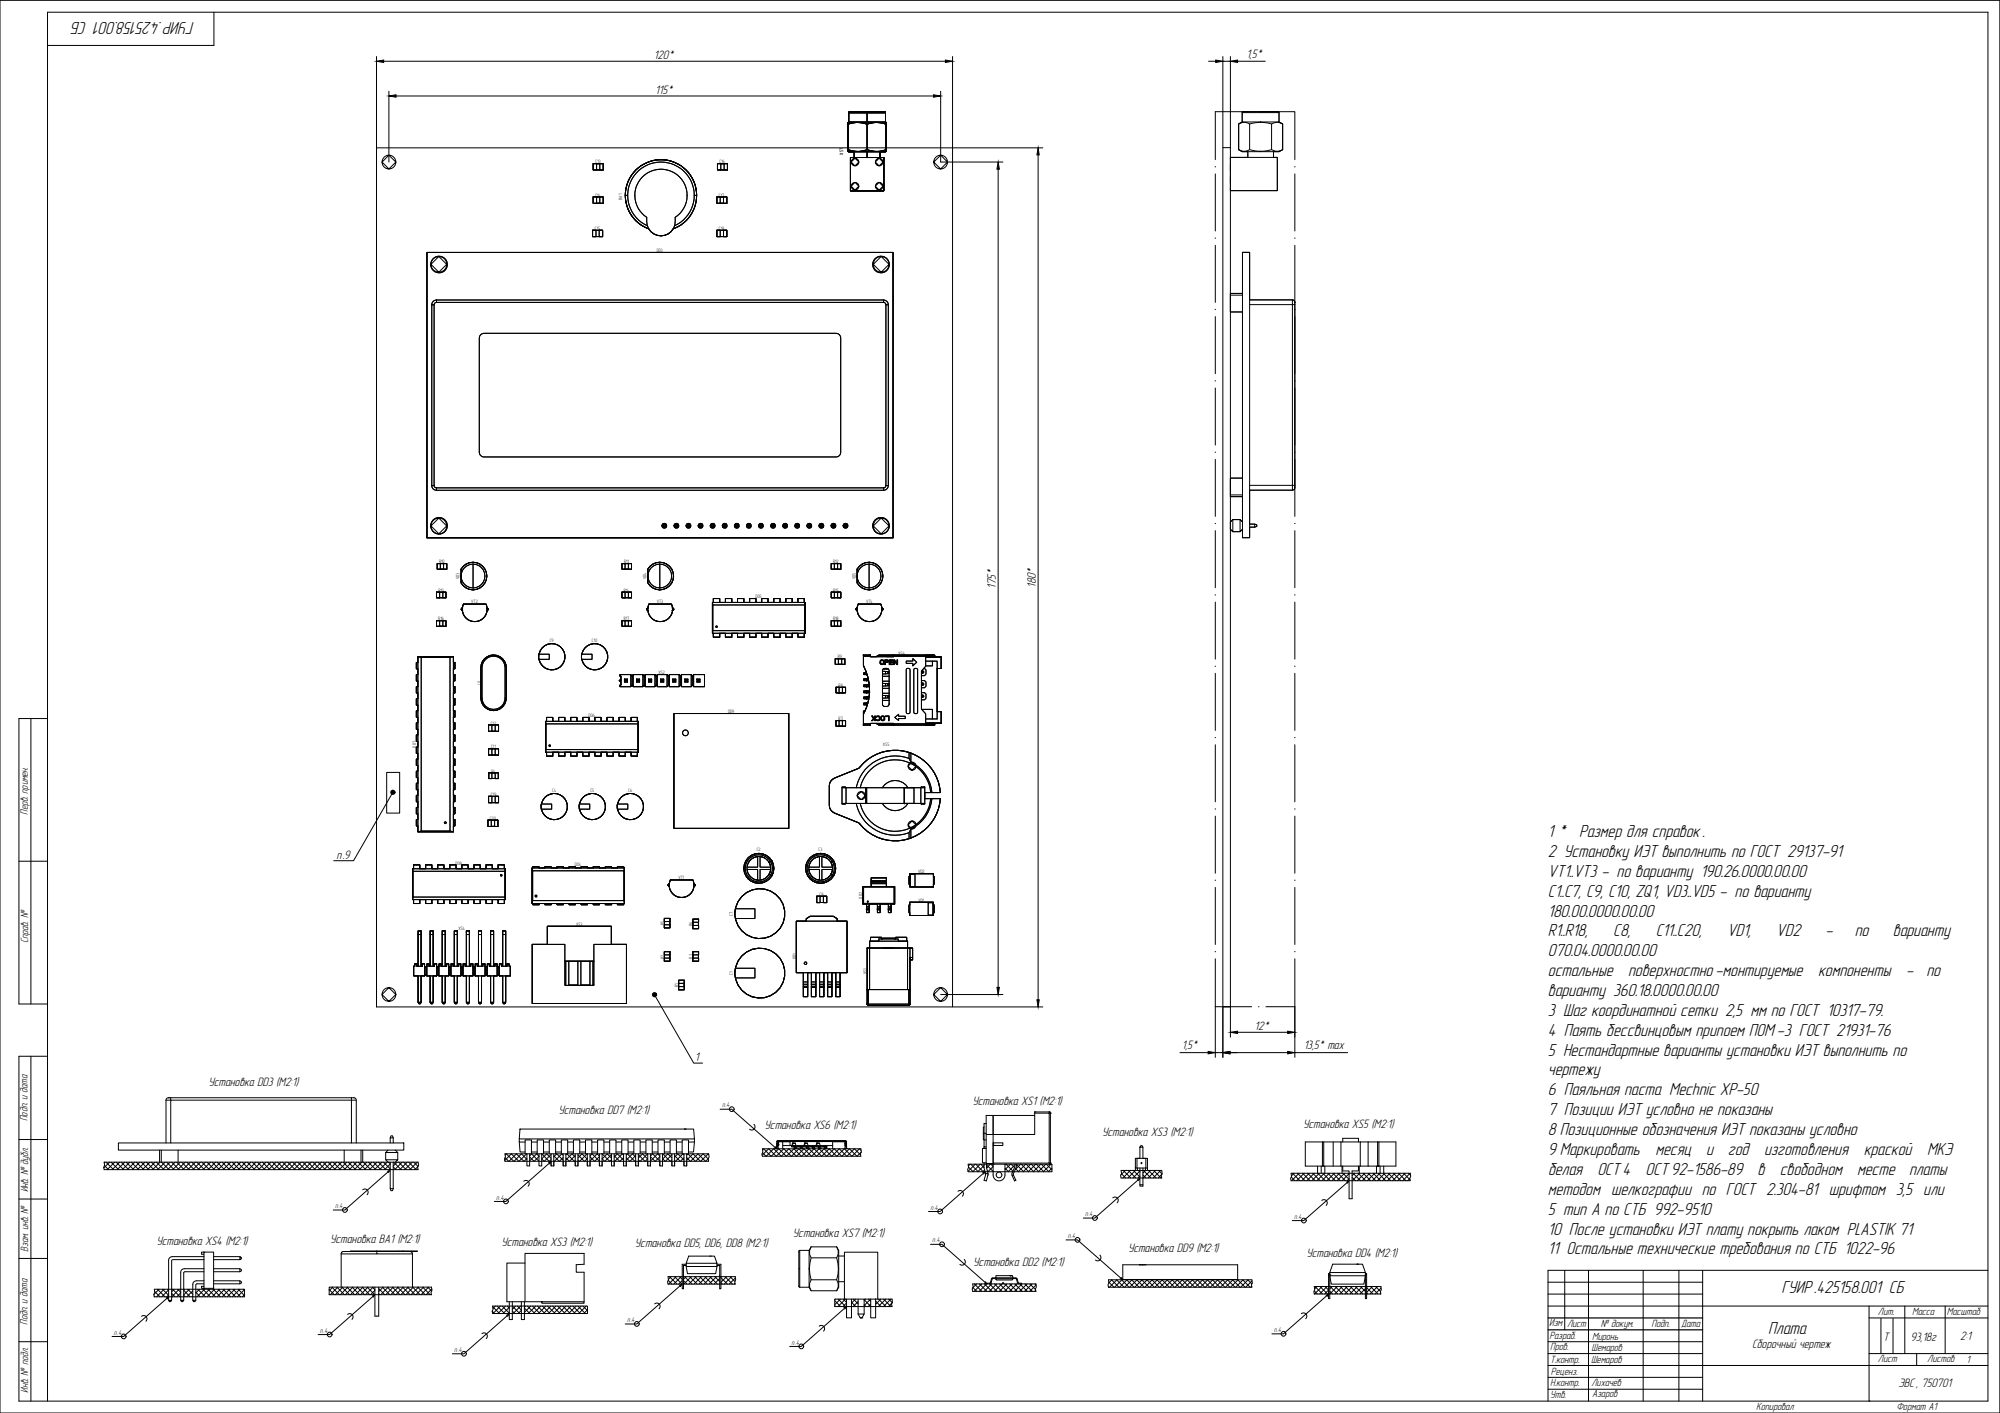
[picture p70: page 1]

Инв. № подл. Перв. примен. Подп. и дата Взам. инв. № Подп. и дата Инв. № дубл. Справ. №

1 * Размер для справок. 2 Установку ИЭТ выполнить по ГОСТ 29137-91

VT1..VT3 - по варианту 190.26.0000.00.00
C1..C7, C9, C10, ZQ1, VD3..VD5 - по варианту
остальные поверхностно-монтируемые компоненты - по
варианту 360.18.0000.00.00
3 Шаг координатной сетки 2,5 мм по ГОСТ 10317-79.
4 Паять бессвинцовым припоем ПОМ -3 ГОСТ 21931-76
5 Нестандартные варианты установки ИЭТ выполнить по
чертежу
6 Паяльная паста Mechnic XP-50
7 Позиции ИЭТ условно не показаны
8 Позиционные обозначения ИЭТ показаны условно
9 Маркировать месяц и год изготовления краской МКЭ
белая ОСТ 4 ОСТ 92-1586-89 в свободном месте платы
методом шелкографии по ГОСТ 2.304-81 шрифтом 3,5 или
5 тип А по СТБ 992-9510
10 После установки ИЭТ плату покрыть лаком PLASTIK 71
11 Остальные технические требования по СТБ 1022-96

ГУИР .425158.001 СБ

Плата Сборочный чертеж | Лит. | Масса | Масштаб

Изм | Лист | № докум. | Подп. | Дата | | | Т | | 93,18г | 2:1
Разраб. | | Миронь
Пров. | | Шемаров
Т.контр. | Шемаров | | | | Лист | Листов 1
Реценз. | | | | | ЭВС, 750701
Н.контр. | Лихачёв
Утв. | Азаров
