SN4NTR/ArduinoSecuritySystem/Final/Plots/Сборочный чертеж устройства.pdf

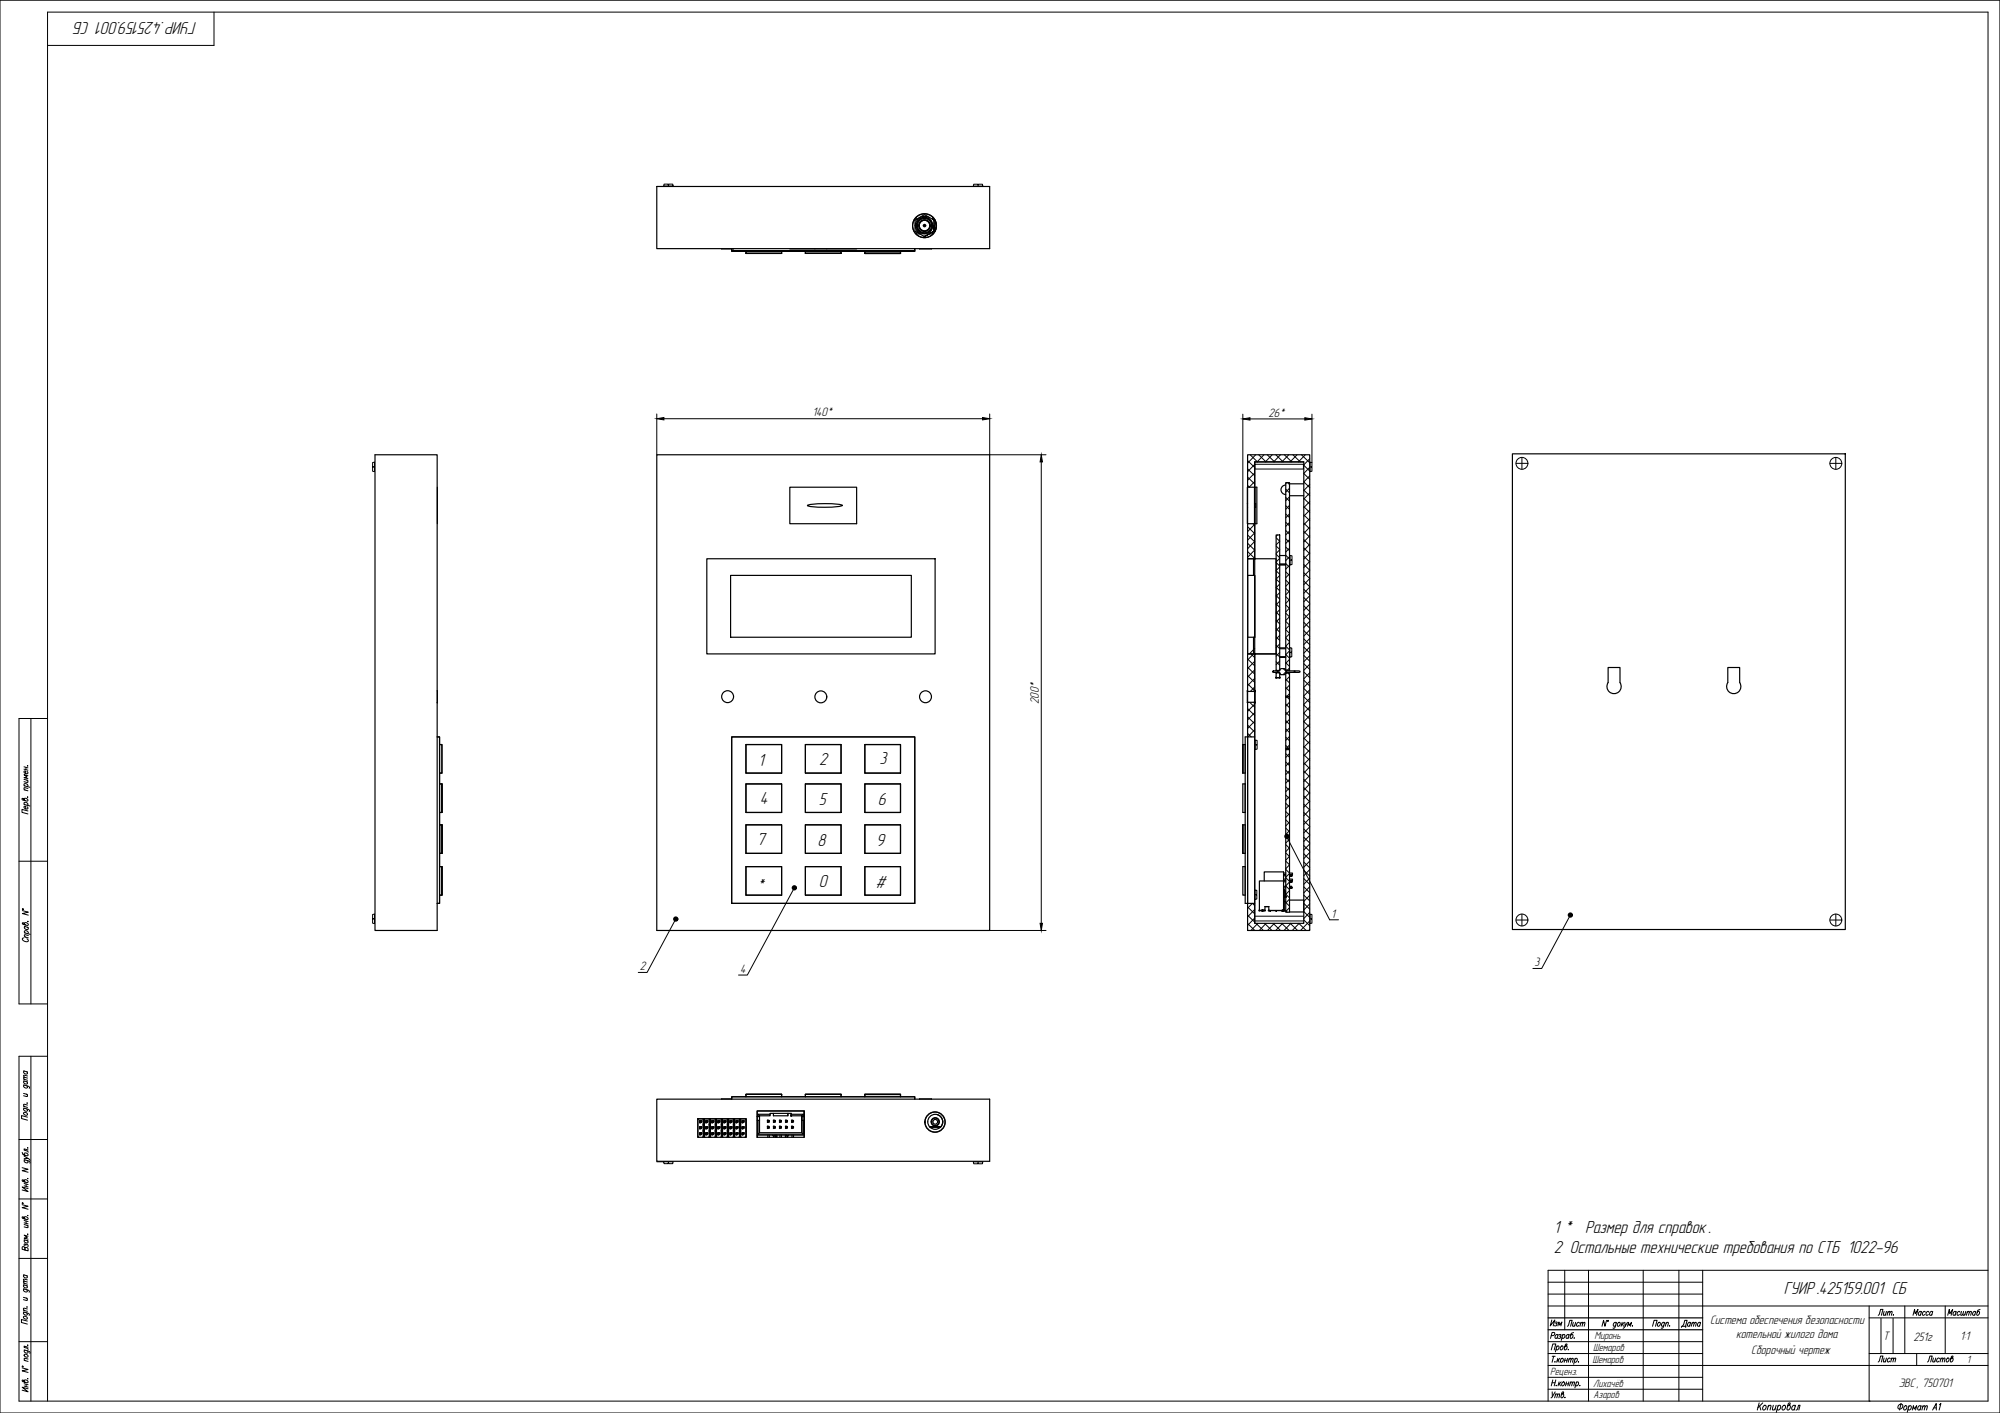
[picture p71: page 1]

1 * Размер для справок. 2 Остальные технические требования по СТБ 1022-96

ГУИР .425159.001 СБ

Система обеспечения безопасности котельной жилого дома Сборочный чертеж
Т | 251г | 1:1

Миронь
Шемаров
Шемаров | | 1

Реценз. | | ЭВС, 750701

Лихачёв
Азаров
