SN4NTR/ArduinoSecuritySystem/Final/Plots/Схема алгоритма работы.pdf

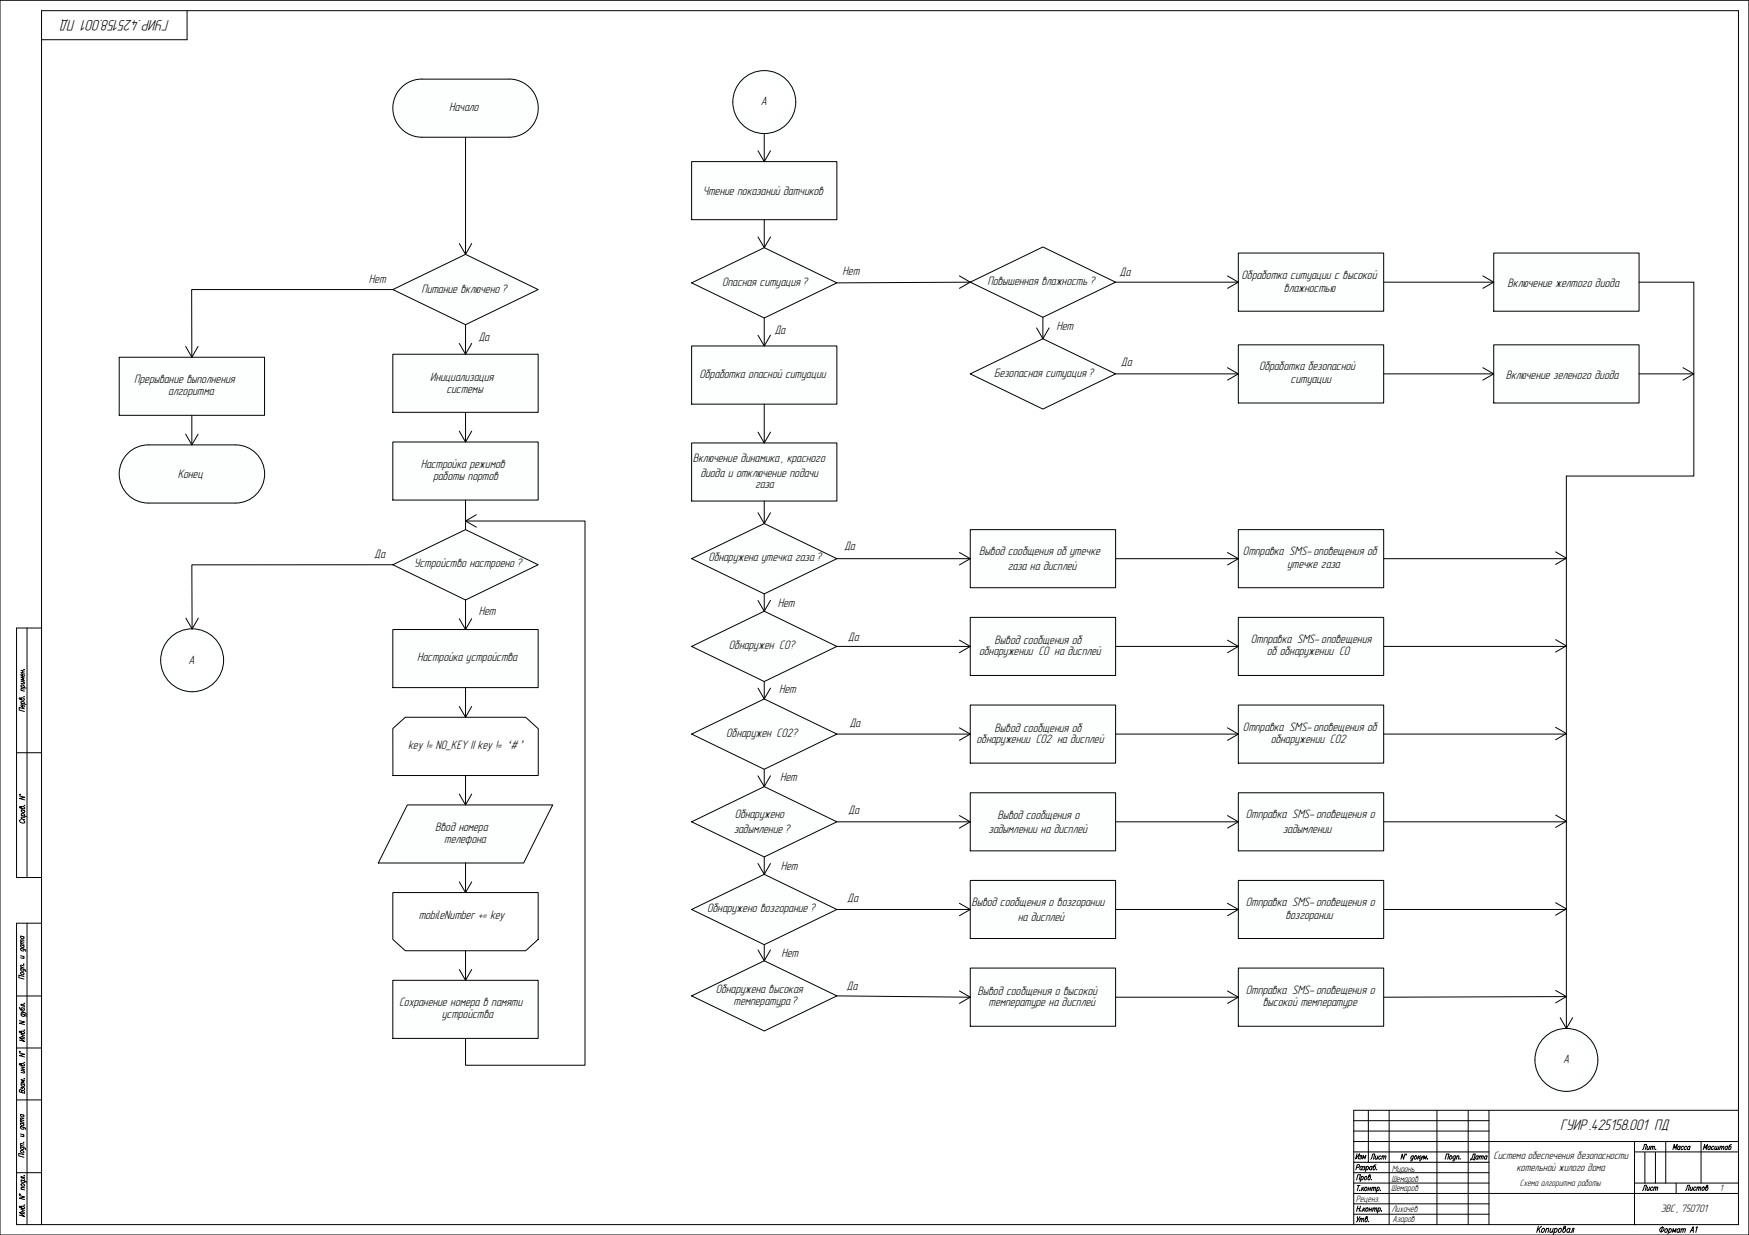
[picture p72: page 1]
Питание включено ?; Прерывание выполнения; Опасная ситуация ?; Повышенная влажность ?; Обработка ситуации с высокой; Настройка режимов работы портов; Обработка опасной ситуации; Безопасная ситуация ?; Обработка безопасной; ситуации; Включение зеленого диода; Устройство настроено ?; Настройка устройства; Обнаружена утечка газа ?; Вывод сообщения об утечке; утечке газа; key != NO_KEY || key != ‘# ’; Обнаружен CO?; Вывод сообщения об; Ввод номера; Обнаружен CO2?; mobileNumber += key; задымление ?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

Чтение показаний датчиков

Включение желтого диода

Включение динамика, красного
диода и отключение подачи

Отправка SMS-оповещения об

газа на дисплей

Отправка SMS-оповещения
об обнаружении CO

обнаружении CO на дисплей

обнаружении CO2

обнаружении CO2 на дисплей

Вывод сообщения о
задымлении на дисплей

Отправка SMS-оповещения о

Вывод сообщения о высокой
температуре на дисплей

высокой температуре

Сохранение номера в памяти

ГУИР .425158.001 ПД

Система обеспечения безопасности котельной жилого дома Схема алгоритма работы

Миронь
Шемаров
Шемаров | | 1

Реценз. | | ЭВС, 750701

Лихачёв
Азаров
