SN4NTR/ArduinoSecuritySystem/Final/Plots/Схема структурная.pdf

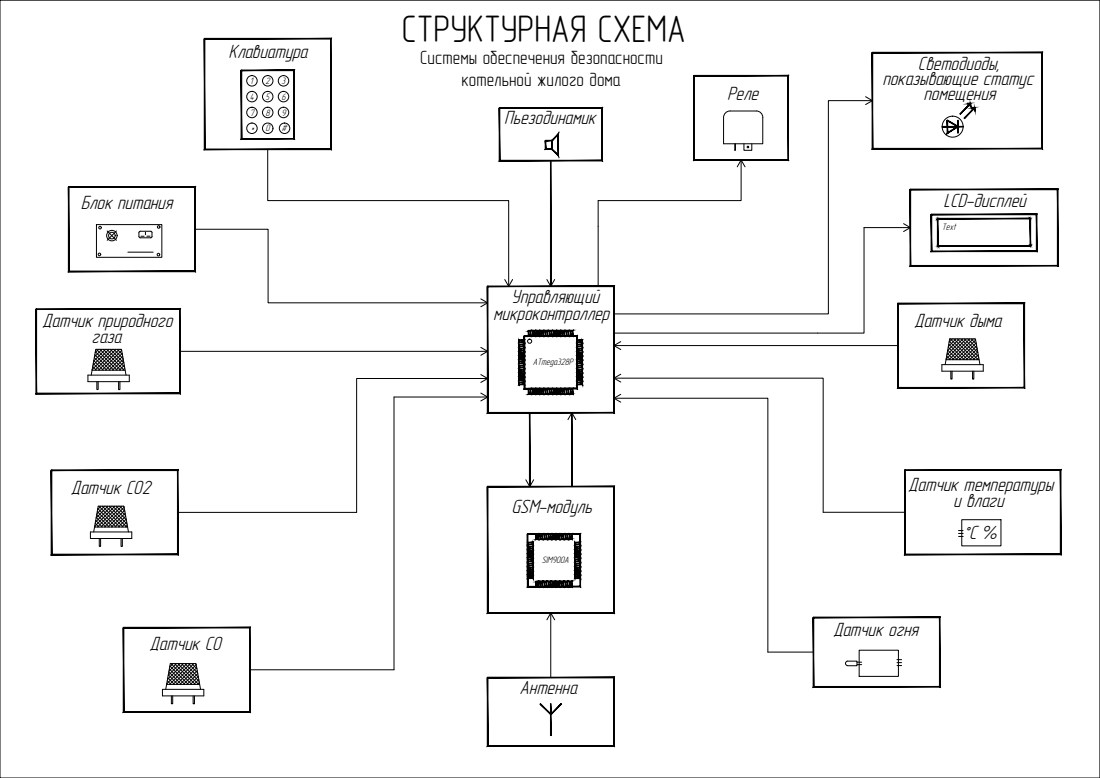
[picture p73: page 1]
СТРУКТУРНАЯ СХЕМА; Блок питания; Датчик природного; Датчик дыма; показывающие статус Реле; помещения; Датчик CO; Датчик CO2; Датчик огня; Датчик температуры и влаги

Системы обеспечения безопасности
котельной жилого дома
