SN4NTR/ArduinoSecuritySystem/Final/Plots/Схема электрическая принципиальная.pdf

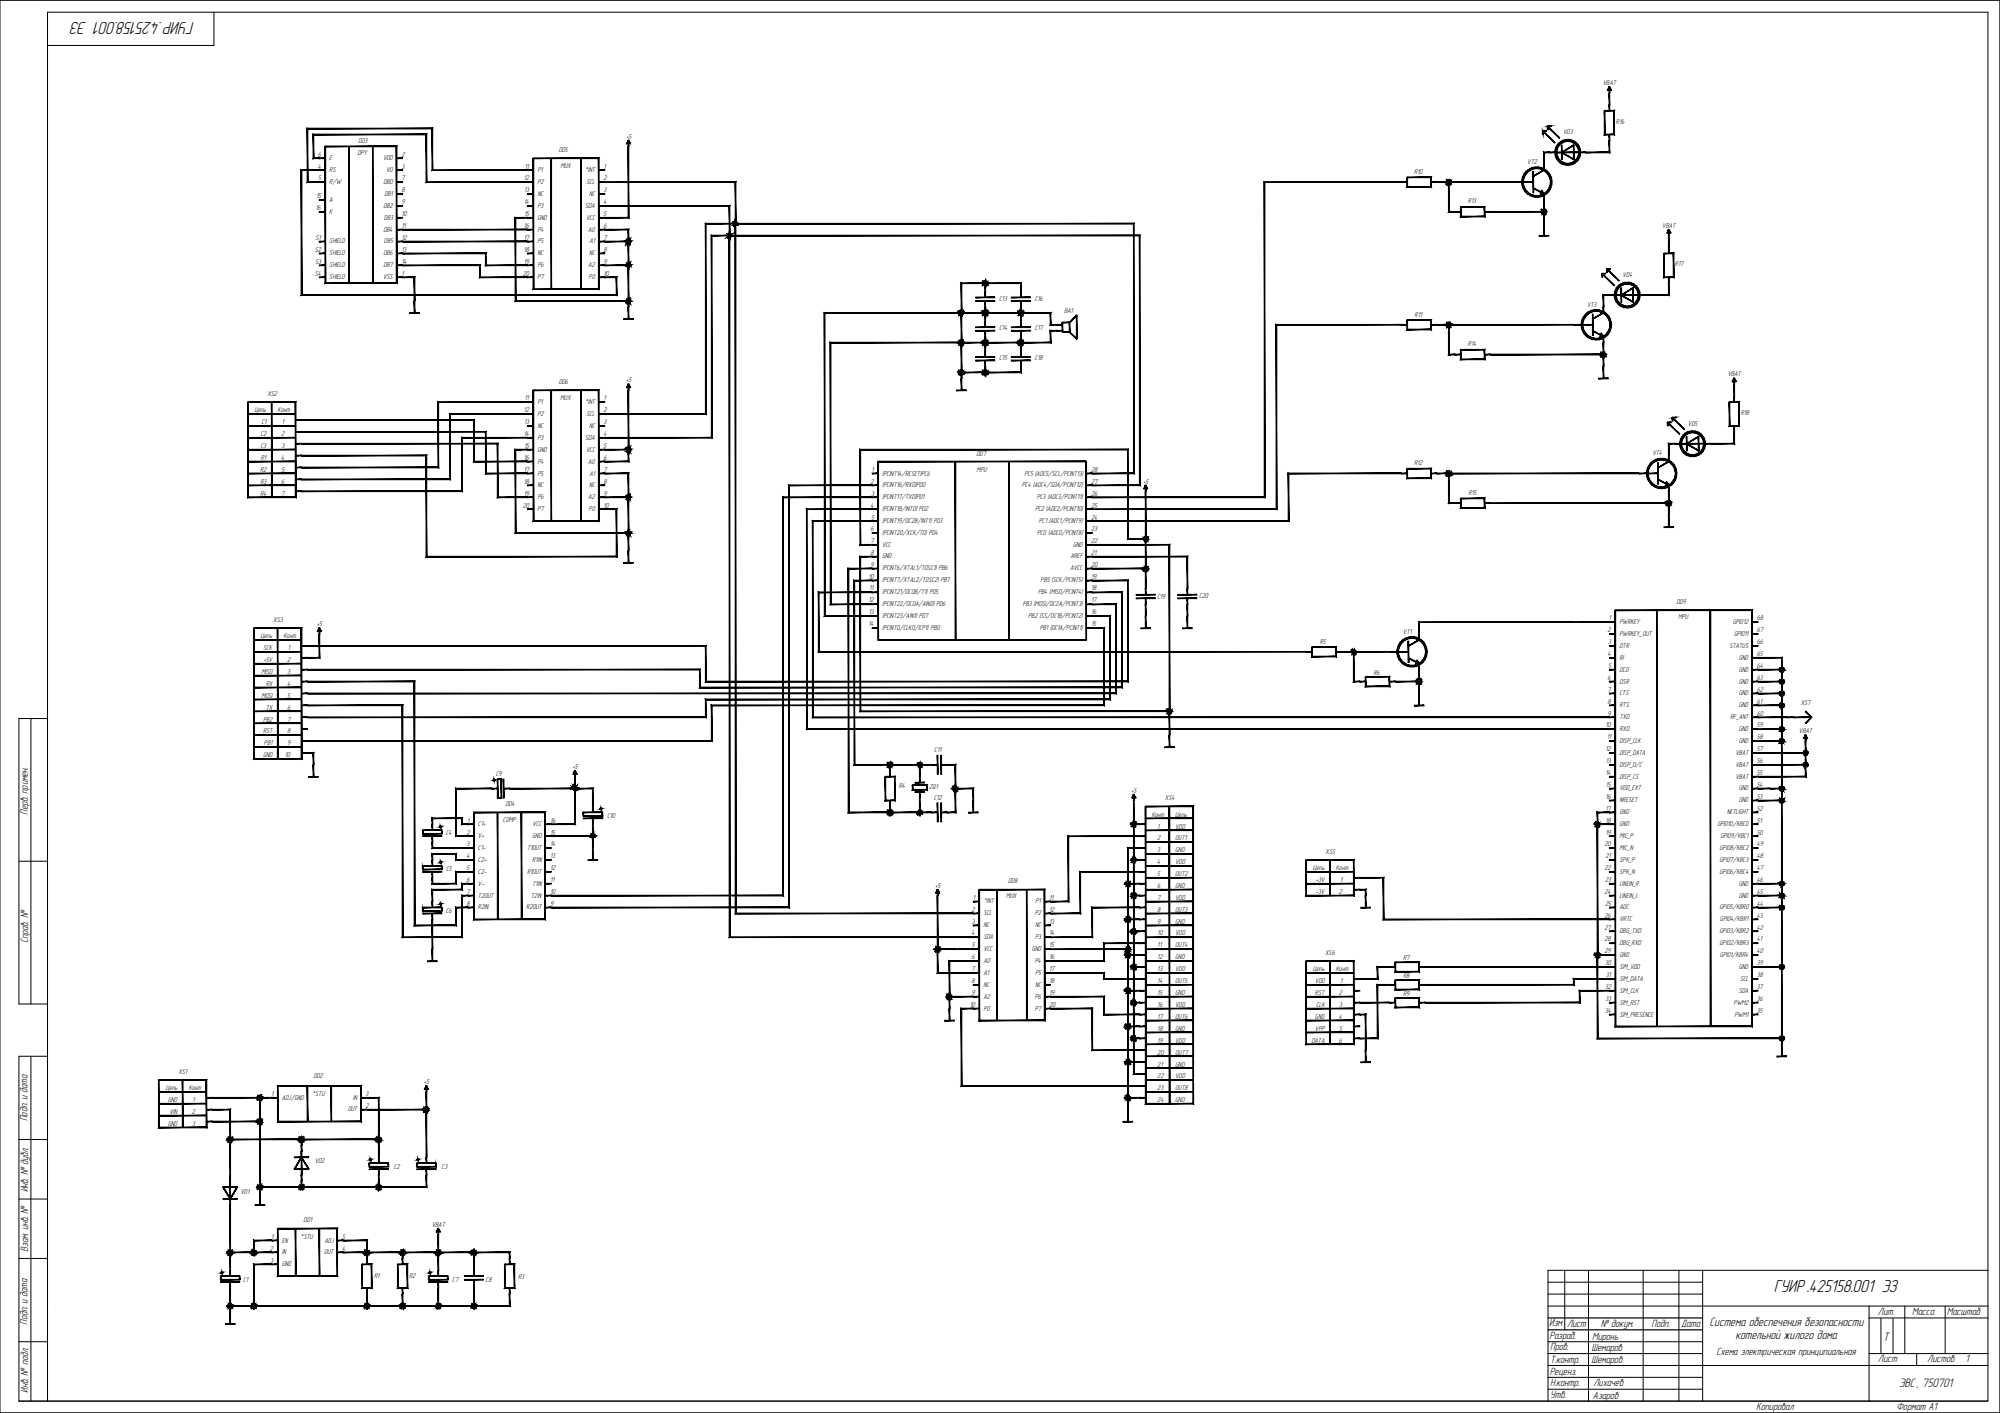
[picture p74: page 1]

Инв. № подл. Перв. примен. Подп. и дата Взам. инв. № Подп. и дата Инв. № дубл. Справ. №

Изм | Лист | № докум. | Подп. | Дата
Разраб.
Пров. | | Шемаров

Шемаров

Н.контр.
