SN4NTR/ArduinoSecuritySystem/Final/Plots/Чертеж печатной платы.pdf

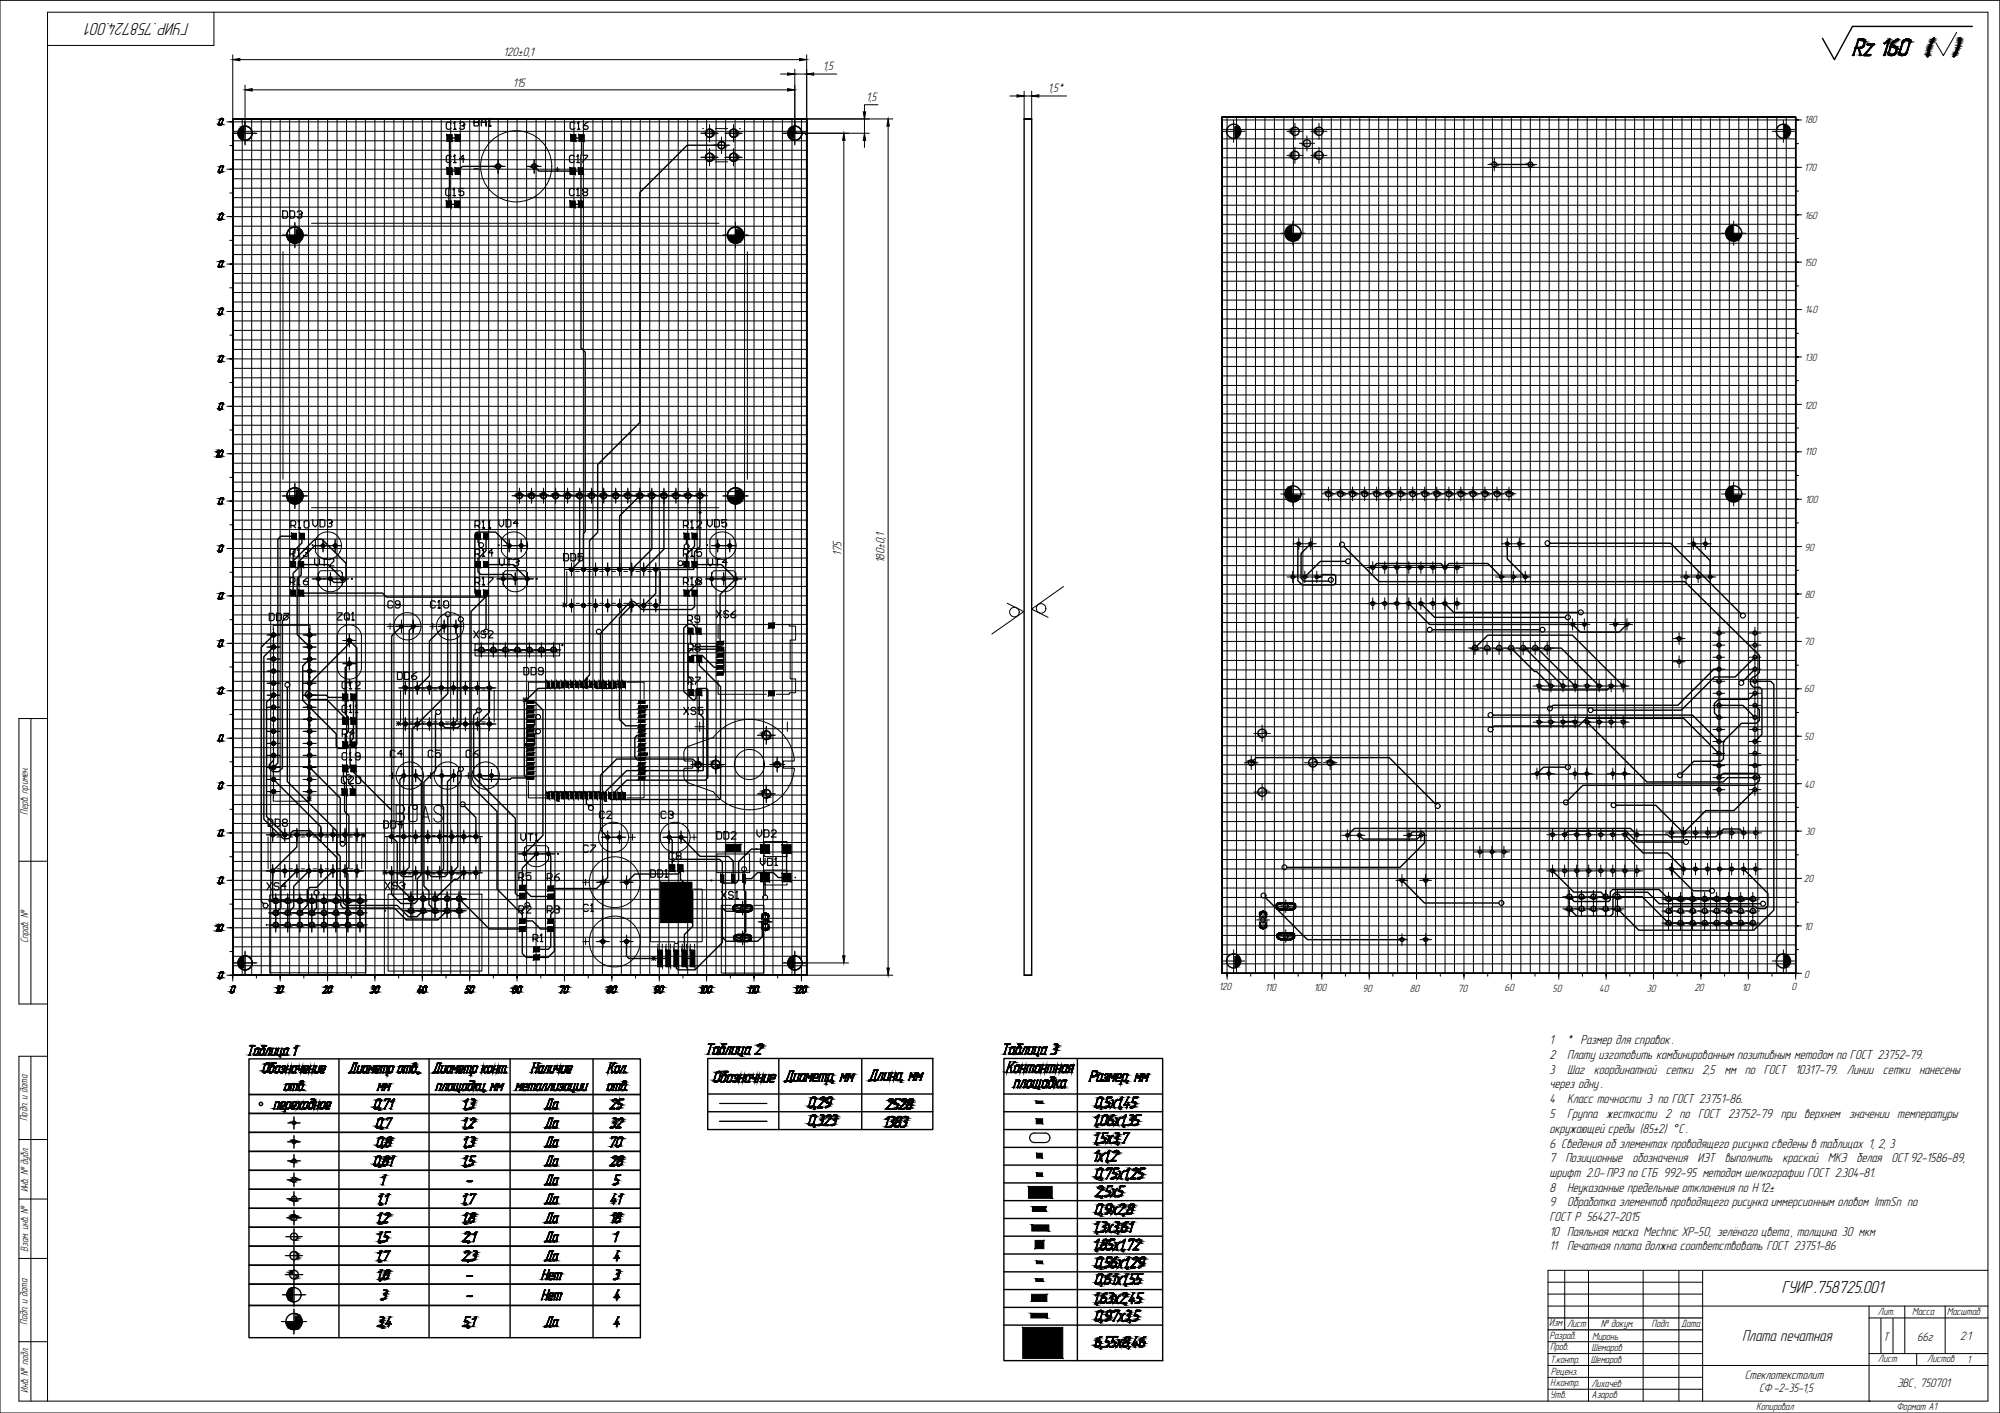
[picture p75: page 1]
Копировал; Формат А1; Т.контр.; Лист; Листов 1 * Размер для справок. 2 Плату изготовить комбинированным позитивным методом по ГОСТ 23752-79. 3 Шаг координатной сетки 2,5 мм по ГОСТ 10317-79. Линии сетки нанесены

Инв. № подл. Перв. примен. Подп. и дата Взам. инв. № Подп. и дата Инв. № дубл. Справ. №

через одну. 4 Класс точности 3 по ГОСТ 23751-86. 5 Группа жесткости 2 по ГОСТ 23752-79 при верхнем значении температуры

окружающей среды (85±2) °С. 6 Сведения об элементах проводящего рисунка сведены в таблицах 1, 2, 3 7 Позиционные обозначения ИЭТ выполнить краской МКЭ белая ОСТ 92-1586-89,

шрифт 2.0- ПРЗ по СТБ 992-95 методом шелкографии ГОСТ 2.304-81. 8 Неуказанные предельные отклонения по Н 12± 9 Обработка элементов проводящего рисунка иммерсионным оловом ImmSn по

ГОСТ Р 56427-2015
10 Паяльная маска Mechnic XP-50, зелёного цвета, толщина 30 мкм

11 Печатная плата должна соответствовать ГОСТ 23751-86 | | | | | Т 66г 2:1 ГУИР .758725.001

Плата печатная | Лит. | Масса | Масштаб

Изм | Лист | № докум. | Подп. | Дата
Разраб. | | Миронь
Пров. | | Шемаров
Реценз. | Шемаров | | | | | 1

Стеклотекстолит СФ -2-35-1,5 | ЭВС, 750701

Н.контр. | Лихачёв
Утв. | Азаров
