SN4NTR/ArduinoSecuritySystem/Final/For Review/Plots/Сборочный печатной платы Миронь.pdf

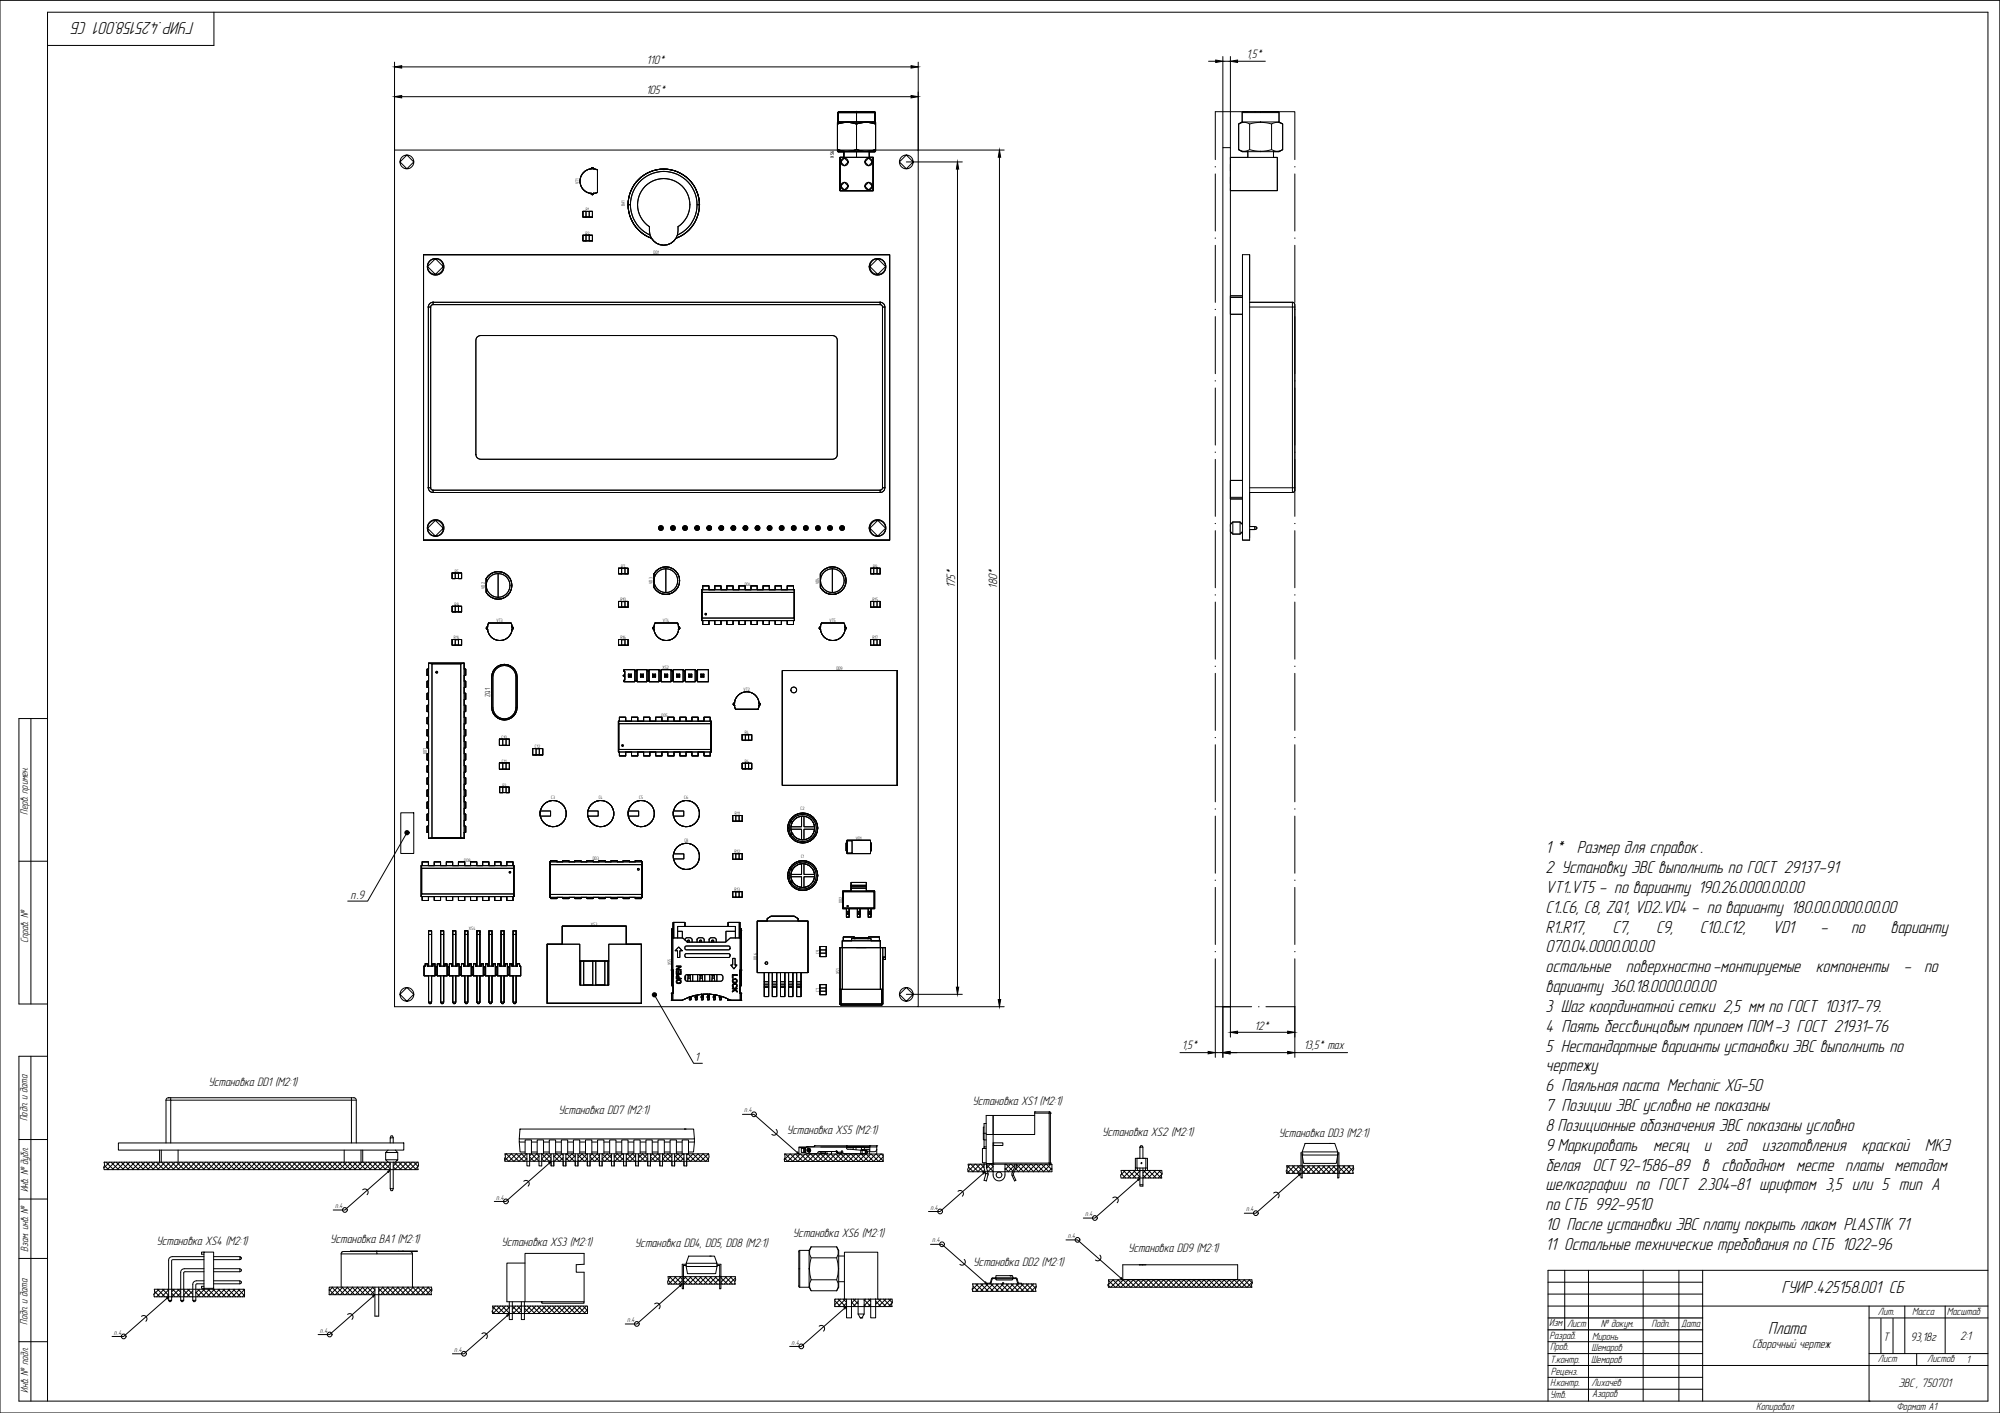
[picture p76: page 1]

Инв. № подл. Перв. примен. Подп. и дата Взам. инв. № Подп. и дата Инв. № дубл. Справ. №

1 * Размер для справок. 2 Установку ЭВС выполнить по ГОСТ 29137-91

VT1..VT5 - по варианту 190.26.0000.00.00
C1..C6, C8, ZQ1, VD2..VD4 - по варианту 180.00.0000.00.00
остальные поверхностно-монтируемые компоненты - по
варианту 360.18.0000.00.00
3 Шаг координатной сетки 2,5 мм по ГОСТ 10317-79.
4 Паять бессвинцовым припоем ПОМ -3 ГОСТ 21931-76
5 Нестандартные варианты установки ЭВС выполнить по
чертежу
6 Паяльная паста Mechanic XG-50
7 Позиции ЭВС условно не показаны
8 Позиционные обозначения ЭВС показаны условно
9 Маркировать месяц и год изготовления краской МКЭ
белая ОСТ 92-1586-89 в свободном месте платы методом
шелкографии по ГОСТ 2.304-81 шрифтом 3,5 или 5 тип А
по СТБ 992-9510
10 После установки ЭВС плату покрыть лаком PLASTIK 71
11 Остальные технические требования по СТБ 1022-96

ГУИР .425158.001 СБ

Плата Сборочный чертеж | Лит. | Масса | Масштаб

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
