SN4NTR/ArduinoSecuritySystem/(list of files, drawings)

Other design files:
Altium/Project/2021-04-05_19-02-56.PcbLib
Altium/Project/2021-04-05_19-02-56.SchLib
Altium/Project/AltiumDesigner/2021-05-09_11-47-01/Atmega328.PcbLib
Altium/Project/AltiumDesigner/2021-05-09_11-47-01/Atmega328.SchLib
Altium/Project/atmega32u4.PcbLib
Altium/Project/atmega32u4.SchLib
Altium/Project/atmega2560.PcbLib
Altium/Project/atmega2560.SchLib
Altium/Project/diploma.SchLib
Altium/Project/ideas.SchDoc
Altium/Project/main.SchDoc
Altium/Project/max232.PcbLib
Altium/Project/max232.SchLib
Altium/Project/NCP1117ST50T3G.PcbLib
Altium/Project/NCP1117ST50T3G.SchLib
Altium/Project/PCB1.PcbDoc
Altium/Project/PCF8574DGVR.PcbLib
Altium/Project/PCF8574DGVR.SchLib
Altium/Project/Project.PrjPcb
Altium/Project/sim_connector.PcbLib
Altium/Project/sim_connector.SchLib
Altium/Project/struct.SchDoc
Proteus/Project.pdsprj
