SN4NTR/ArduinoSecuritySystem/(commit log)

2021-04-08 Add I2C expander for LCD
    [Project.pdsprj]
2021-04-08 Fix issue with DHT11 sensor, update arduino model lib
    [Arduino + DHT11.pdsprj, Project.pdsprj]
2021-04-08 Add keyboard device, implement registration with mobile number input
    [Project.pdsprj]
2021-04-10 Add CO, CO2, Smoke sensors
    [Project.pdsprj]
2021-04-11 Implement logic for high temperature situation handling
    [Project.pdsprj]
2021-04-25 Replace Arduino Mega with Uno
    [2021-04-05_19-02-56.PcbLib, 2021-04-05_19-02-56.SchLib, NCP1117ST50T3G.PcbLib, NCP1117ST50T3G.SchLib, PCF8574DGVR.PcbLib, PCF8574DGVR.SchLib, Project.PrjPcb, Project.pdsprj]
2021-04-25 Add gas sensor logic
    [Project.PrjPcb, Project.pdsprj, main.SchDoc, struct.SchDoc]
2021-05-01 Add economical calculations in mathcad
    [Arduino + DHT11.pdsprj, Project.pdsprj]
2021-05-11 update document, update altium scheme
    [28P3_ATM.step, Atmega328.PcbLib, Atmega328.SchLib, PCB1.PcbDoc, main.SchDoc, struct.SchDoc]
2021-05-11 update struct scheme, update PCB board
    [PCB1.PcbDoc, main.dwg, struct.SchDoc, struct.dwg]
2021-05-11 remove USB-A, update doc
    [PCB1.PcbDoc, main.SchDoc]
2021-05-12 update economy + doc
    [ТЭО.xlsx]
2021-05-14 update schema, pcb, update economy and main doc
    [NCP1117ST50T3G.PcbLib, PCB1.PcbDoc, main.SchDoc]
2021-05-15 Update main doc and economy
    [PCB1.PcbDoc, main.SchDoc]
2021-05-15 Update docs, autocad files
    [main.dwg, struct.dwg]
2021-05-16 update docs
    [PCB1.PcbDoc]
2021-05-18 update economy
    [Draftman.dxf, PCB1.DWG, Project.PrjPcb, main.SchDoc, main.dwg, struct.dwg, Нестандартные элементы.dwg, Принципиальная схема.dwg]
2021-05-19 add case 3D model, update sheets
    [All Sheets.dwg, Корпус.dwg, Сборочный чертеж.dwg]
2021-05-19 Create case sheet, update other sheets
    [Рамка формата А1 горизонтальная и вертикальная autocad.dwg]
2021-05-20 Add algorithm sheet
    [All Sheets.dwg, main.SchDoc]
2021-05-20 Update sheets, update doc with links
    [Project.PrjPcb]
2021-05-26 Update doc and sheets
    [Верхняя крышка.dwg.idw, Нижняя крышка.dwg.idw]
2021-05-27 Update all...
    [Верхняя крышка.dwg.idw, Нижняя крышка.dwg.idw]
2021-05-30 Update all schematics
    [Draftman.dxf, PCB2.dxf, Project.PrjPcb, main.SchDoc, Корпус.dwg.idw, Нестандартные элементы.dwg, Принципиальная схема.dwg]
2021-05-31 Update everything...
    [Корпус 3.dwg]
2021-06-03 Last updates
    [Draftman 2.dxf]
2021-06-19 Add presentation
    [Корпус 3.dwg.idw]
